mkupriyanov05/Diploma_Baka/RPZ_Kupriyanov_Diploma.docx

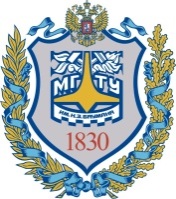
[picture p76: figure]
Gerb-BMSTU_01

| Министерство науки и высшего образования Российской Федерации Федеральное государственное бюджетное образовательное учреждение высшего образования «Московский государственный технический университет имени Н.Э. Баумана (национальный исследовательский университет)» (МГТУ им. Н.Э. Баумана)

ФАКУЛЬТЕТ «Информатика и системы управления» («ИУ»)

КАФЕДРА «Проектирование и технология производства электронной аппаратуры» («ИУ-4»)

РАСЧЕТНО-ПОЯСНИТЕЛЬНАЯ ЗАПИСКА

К ВЫПУСКНОЙ КВАЛИФИКАЦИОННОЙ РАБОТЕ

НА ТЕМУ:

«Гитарный эффект «Бит Крашер»

Студент группы ИУ4-83Б М.М. Куприянов

(Подпись, дата)

Руководитель ВКР В.В. Макарчук

(Подпись, дата)

Нормоконтролер

(Подпись, дата)

2026 г.

АННОТАЦИЯ

Представленная работа посвящена разработке электронного изделия, реализующего гитарный эффект «Бит Крашер». Такое изделие необходимо для изменения частотного спектра аналогового сигнала, что позволяет менять звучание гитарного инструмента. Его предполагается использовать при исполнении мелодий и музыкальных композиций на электрогитаре. Прошедший через спроектированное изделие звуковой сигнал приобретает характерные черты «роботизированности» и «зернистости».

Расчетно-пояснительная записка (РПЗ) включает в себя комплект документации, необходимой для разработки и производства изделия, состоящий из схем электрических структурной, функциональной и принципиальной, чертежей печатной платы, схемы сборки модуля электроники, деталей корпуса и самого изделия после сборки. Дополнительно в приложении к РПЗ представлены спецификация на изделие и перечень содержащихся в нем электронных компонентов. Приведены соображения по выбору характеристик спроектированного изделия и его электронной компонентной базы.

Ключевые слова: гитарный эффект, «Бит Крашер», аналого-цифровой преобразователь, цифро-аналоговый преобразователь, схема выборки-хранения, схемотехническое проектирование, конструкторское проектирование, технологическое проектирование.

ABSTRACT

This work is dedicated to the development of an electronic device implementing the guitar effect "Bit Crusher." Such a device is necessary for modifying the frequency spectrum of an analog signal, which allows changing the sound of a guitar instrument. It is intended to be used when performing melodies and musical compositions on an electric guitar. The audio signal passing through the designed device acquires characteristic features of "robotic" and "grainy" sound.

The Design and Explanatory Report (DER) includes a set of documentation necessary for the development and production of the device, consisting of electrical circuit diagrams: structural, functional, and schematic; printed circuit board drawings; an electronics module assembly diagram; enclosure parts; and the final assembled device. Additionally, the DER appendix contains the device specification and a list of electronic components included in it. Considerations regarding the selection of characteristics for the designed device and its electronic component base are also provided.

Keywords: guitar effect, "Bit Crusher," analog-to-digital converter, digital-to-analog converter, sample-and-hold circuit, circuit design, engineering design, technological design.

СОДЕРЖАНИЕ

С.

# УСЛОВНЫЕ ОБОЗНАЧЕНИЯ, СОКРАЩЕНИЯ И ТЕРМИНЫ

АЦП - Аналого-Цифровой Преобразователь;

ГОСТ – Государственный Стандарт;

ГЭ Гитарный эффект

ДПП – Двухсторонняя Печатная Плата;

ЕСКД – Единая Система Конструкторской Документации;

ИМС - Интегральная Микросхема;

КМО - Компоненты, Монтируемые в Отверстия;

КМП - Компоненты, Монтируемые на Поверхность;

ОУ - Операционный Усилитель;

ПП - Печатная Плата;

РПЗ – Расчётно-пояснительная записка;

РТЗ – Расширенное техническое задание;

САПР - Система Автоматизированного Проектирования;

СВХ - Схема Выборки-Хранения;

ТЗ - Техническое Задание;

ТРИЗ - Теория Решения Изобретательских Задач;

ЦАП - Цифро-Аналоговый Преобразователь;

ЭА - Электронная Аппаратура;

ЭРЭ - Электрорадиоэлемент;

ЭС - Электронное Средство;

ABS – ударопрочная техническая термопластическая смола на основе сополимера акрилонитрила с бутадиеном и стиролом;

FDM – Fused Deposition Modeling - аддитивная технология, широко используемая при создании трёхмерных моделей, при прототипировании и в промышленном производстве

SNR - Signal-to-Noise Ratio – отношение сигнал/шум

# ВВЕДЕНИЕ

Создание новых музыкальных инструментов было занятием людей задолго до появления современной цивилизации. Необычное звучание выделяло исполнителей среди равных. Множество талантов раскрылось с помощью уникальных звуковых профилей. Изобретая альтернативу классическим инструментам, музыканты проявляли и продолжают проявлять свою креативность, раз за разом расширяя диапазон звуковых волн, достигающих ушей слушателей.

С распространением электричества радиолюбители стали использовать доступные ЭРЭ для создания устройств, искажающих сигнал инструментов, в том числе и гитар. Такие устройства начали называть гитарными эффектами. Самыми популярными из ГЭ признаны «Дисторшн», «Фузз», «Вибрато» и др. Однако, создание первых цифровых программ для персональных компьютеров, осуществляющих функции обработки звуковых сигналов, поставило перед разработчиками программного обеспечения необходимость решения проблемы низкой разрядности. Малая разрядность искажала сигналы и «роботизированность», создаваемая несовершенными устройствами, стала узнаваемой и полюбилась слушателям. После лет усовершенствования электронной аппаратуры встала задача искусственно создать такие искажения звукового сигнала. Решить ее был призван ГЭ, названный «Бит Крашер». Особенность этого эффекта заключается в использовании двух основных принципов: понижение разрядности цифровой формы сигнала и уменьшение частоты его дискретизации.

Оба упомянутых принципа в современных устройствах реализуются при помощи цифровой обработки сигналов. Программное обеспечение или отдельный прибор обычно использует микроконтроллер или другой программируемый модуль для работы с сигналом как набором цифровых линий. Аналого-цифровое преобразование в современных устройствах осуществляется с целью удобства работы с сигналом.

Представляемая работа, в противовес существующим на рынке техническим решениям, с целью сохранения аутентичности звука и лучшего контроля над каждым этапом преобразования использует дискретные элементы и микросхемы. Преобразование звукового сигнала из аналоговой формы в цифровую для создания звукового эффекта совершается в нем не как конечная цель, а для создания возможности дальнейшей работы с сигналом. Весь процесс изменения сигнала осуществляется в данном случае в соответствии со строго обозначенной последовательностью. Дополнительно стоит отметить разделение этой последовательности на функциональные модули, речь о которых пойдет дальше, что дает возможность совершенствовать разработанное изделие согласно этим отдельным модулям, без необходимости замены всей архитектуры системы.

Актуальность работы обусловлена недостаточным количеством аналогов разработанного изделия на отечественном рынке. Выбирая устройства с указанной выше структурой, использующей дискретные ЭРЭ и ИМС, круг производителей сокращается еще больше. В результате анализа цена на указанную продукцию, представленную на зарубежном рынке, оказывается слишком высокой вследствие наличия дополнительных логистических и таможенных затрат.

Целью работы являлось создание макетного образца устройства «Гитарный эффект «Бит Крашер», а также конструкторско-технологической документации к нему, включающей в себя расчетную и графическую часть.

Сборка и тестирование образца будет служить основой для оценки предложенных технических решений, а также проверки корректности функционирования и достижения заявленных характеристик.

Для достижения поставленной цели был выполнен следующий комплекс работ:

- разработка структурной схемы Э1;
- разработка функциональной схемы Э2;
- разработка принципиальной схемы Э3;
- разработка конструкции печатной платы;
- разработка конструкции электронного модуля;
- разработка конструкции корпуса изделия;
- разработка конструкции всего изделия в целом;
- разработка технологического процесса сборки изделия;
- расчёты изделия на механические и тепловые воздействия;
- разработка технологического процесса изделия;
- сборка макетного образца изделия;
- разработка методики и испытательного стенда для контроля рабочих характеристик изделия.

Исходными данными для работы являлись:

- задание на выполнение квалификационной работы бакалавра;
- календарный план выполнения квалификационной работы бакалавра.

Результатами работы являются:

- электрическая структурная схема (Э1);
- электрическая функциональная схема (Э2);
- электрическая принципиальная схема (Э3);
- чертеж печатной платы;
- сборочный чертёж электронного модуля;
- чертеж основания корпуса изделия;
- чертеж крышки корпуса изделия;
- сборочный чертёж изделия;
- эскизный технологический процесс сборки изделия;
- расчёт программы выпуска изделия;
- отчёт по проведению контрольных испытаний изделия.

Структура и объем работы. Работа разделена на четыре раздела.

В первом разделе проведен анализ технико-экономического обоснования выполнения работы путем анализа его технического задания, а также выполнен сравнительный анализ функциональных параметров существующих аналогов.

Второй раздел содержит результаты конструкторско-схемотехнического проектирования разработанного изделия. В ней приведено описание процесса разработки структурной, функциональной и принципиальной электрических схем, конструкций печатной платы и корпуса и выполнены необходимые для этого схемотехнические и конструкторские расчеты.

В третьем разделе изложены результаты технологического проектирования создаваемого изделия. Изложены процесс разработки схем сборки изделия и результаты расчета и анализа его технологичности.

Заключительный четвертый раздел включает в себя результаты экспериментальных исследований созданного изделия, для чего были выполнены работы по созданию измерительного стенда, методик проведения измерений и анализа результатов проведенных экспериментов.

В заключении кратко подведены итоги проделанной работы.

# 1 ТЕХНИКО-ЭКОНОМИЧЕСКОЕ ОБОСНОВАНИЕ РАЗРАБОТКИ ИЗДЕЛИЯ «ГИТАРНЫЙ ЭФФЕКТ «БИТ КРАШЕР»

## 1.1 Обзор существующих аналогов изделия и обоснование экономической целесообразности разработки устройства

Основной задачей изделий типа «Бит Крашер» является изменение спектра звукового сигнала. Ожидаемую форму можно описать как ступенчатое изменение сигнала во времени, т.е. такие изделия должны обеспечить соответствующий спектральный диапазон.

Наиболее частые параметры, по которым описывается необходимый частотный спектр и определяются достоинства ГЭ «Бит Крашер» — это частота дискретизации сигнала, количество разрядов и полоса пропускания. Примем их в качестве фундаментальных характеристик именно для такого типа изделий. Также не стоит забывать и про универсальные для изделий электроники параметры: вес, габариты, потребляемый ток, количество функций и стоимость. Отдельно выделим как характеристику способ преобразования, что как было сказано ранее влияет на сохранение аутентичности звука и модульности архитектуры изделия. Проведем анализ представленных на рынке аналогов по этим характеристикам. Стоит отметить, что в данном разделе под аналогами подразумеваются самостоятельные изделия, а не устанавливаемое программное обеспечение, поскольку цель работы – создание образца изделия, а не программы.

Рассмотрим изделие, реализующее функции гитарного эффекта «Бит Крашер» от фирмы Sonicake (КНР) [1]. Его внешний вид представлен на рисунке 1.1.

Фото 1 - Sonicake QSS-20 Wave Crush Bitcrusher.

Рисунок 1.1 – Внешний вид изделия, реализующего функции гитарного эффекта «Бит Крашер» фирмы «Sonicake» (КНР)

Представленное изделие имеет следующие функциональные параметры:

- Вес: 125 г. Данный вес обеспечивает комфорт при переноске и использовании.
- Габаритные размеры: 92×38×36 мм. Указанные размеры делают изделие портативным.
- Потребляемый ток: 110 мА. Небольшой ток позволяет экономить электроэнергию.
- Количество функций: 3. Совмещение нескольких режимов работы увеличивает вариативность использования изделия, что положительно влияет на спрос на него.
- Стоимость: 6390 р. Указана рыночная цена на данное изделие.
- Частота дискретизации: 0,75 - 44 кГц. Большая вариативность выбора частоты дискретизации влияет на возможность изменения степени искажения звукового сигнала. Чем меньше частота дискретизации, тем более искаженным будет звук.
- Количество разрядов: от 5 до 16. Большая вариативность выбора количества разрядов влияет на возможность изменения степени искажения сигнала. Чем меньше количество разрядов, тем более искаженным будет звук.
- Полоса пропускания: 20 Гц - 20 кГц. Частоты, на которых работает изделие, соответствуют слышимому человеческим ухом звуковому диапазону.
- Cпособ преобразования: цифровой. Цифровое преобразование не требует большого количества ЭРЭ и ИМС, однако не предоставляет тех преимуществ, которые были перечислены при описании преобразовании дискретными элементами.

Эти характеристики позволяют оценить функциональность и особенности данной модели ГЭ.

Также рассмотрим гитарный эффект «Бит Крашер» от Electro-Harmonix (США) [2]. Его внешний вид представлен на рисунке 1.2.


Рисунок 1.2 - Внешний вид гитарного эффекта «Бит Крашер» от Electro-Harmonix (США)

Представленное изделие имеет следующие функциональные параметры:

- Вес: 350 г. Небольшой вес обеспечивает комфорт в переноске и использовании.
- Габариты: 115×70×55 мм. Малые габариты делают изделие портативным.
- Потребляемый ток: 100 мА. Небольшой ток позволяет экономить электроэнергию.
- Количество функций: 5. Совмещение нескольких режимов работы увеличивает вариативность использования изделия, что положительно влияет на спрос на него.
- Стоимость: 23000 р. Указана рыночная цена на данное изделие.
- Частота дискретизации: 0,11 – 48 кГц. Большая вариативность выбора частоты дискретизации влияет на возможность изменения степени искажения сигнала. Чем меньше частота дискретизации, тем более искаженным будет звук.
- Количество разрядов: от 1 до 24. Большая вариативность выбора количества разрядов влияет на возможность изменения степени искажения сигнала. Чем меньше количество разрядов, тем более искаженным будет звук.
- Полоса пропускания: 20 Гц - 20 кГц. Частоты, на которых работает изделие, соответствуют слышимому человеческим ухом звуковому диапазону.
- Cпособ преобразования: цифровой. Цифровое преобразование не требует большого количества ЭРЭ и ИМС, однако не предоставляет тех преимуществ, которые были перечислены при описании преобразовании дискретными элементами.

Эти характеристики позволяют оценить функциональность и особенности данной модели ГЭ.

По итогам анализа характеристик аналогов можно сделать следующие выводы.

Рассмотренные аналоги выделяются своей вариативностью. В качестве достоинств этих изделий можно выделить возможность изменения частоты дискретизации и количества разрядов. Эти параметры значительно увеличивают варианты использования изделия. Также достоинствами являются количество функций и малые габариты. Совмещение этих двух параметров позволяет потенциальному покупателю получить большую функциональность в корпусе меньших размеров.

Недостатками изделия назовем цифровое преобразование сигнала, сопровождающееся спектральными потерями в уникальном звуке инструмента, подключенного ко входу, и его высокую стоимость, которая сделает его менее доступным для покупателей.

Стоит заметить, что представленные модели произведены зарубежом, что делает потенциального пользователя зависимым от импорта товаров. На отечественном рынке сопоставимых по функционалу аналогов практически нет.

Обзор аналогов помогает определить возможные сильные и слабые стороны разрабатываемого изделия. Такое рассмотрение выделяет основные различия между существующими решениями и разрабатываемым изделием, чтобы иметь понимание какие характеристики можно превратить в преимущества готового продукта.

## 1.2 Анализ задания на проектирование

Проведенный анализ расширенного технического задания позволяет выделить требования и характеристики к изделию:

- Cпособ преобразования: на дискретных ЭРЭ и ИМС. Такая архитектура сохраняет аутентичное звучание гитарного инструмента, а также дает возможность легкой замены модулей преобразователя.
- Габаритные размеры: до 150 × 100 × 50 мм. Выбранный способ преобразования обеспечивает умеренные размеры изделия. Важно заметить, что использование большего количества ЭРЭ и ИМС увеличивает габаритные размеры.
- Вес: до 500 г. Габаритные размеры ставят ограничения на снижение итогового веса изделия, однако такое его значение можно признать умеренным.
- Потребляемый ток: до 200 мА. Обеспечение небольшого тока необходимо для малого расхода электроэнергии, а следовательно, и денежных и инфраструктурных затрат на функционирование прибора.
- Количество функций: 1. Создание изделия с меньшим количеством функций и режимов работы удешевляет его и уменьшает его сложность.
- Стоимость: 2000 р. Указана примерная цена на данное изделие, что в сравнении с аналогами делает его более доступным.
- Частота дискретизации: 100 кГц. Уменьшение частоты дискретизации позволяет менять характеристики звука и часто используется в ГЭ «Бит Крашер», однако в данной работе такая задача не ставится. Большая частота дискретизации избавляет изделие от нежелательного явления алиасинга (наложения спектров при слишком малой частоте дискретизации), обеспечивая передискретизацию.
- Количество разрядов: 4. Этот параметр напрямую влияет на степень искажения. В данной работе для упрощения конструкции обеспечивается малая количество разрядов, что вносит значительные искажения в сигнал. При анализе необходимой величины этого параметра было найдено техническое противоречие. Увеличение числа выполняемых разрядов геометрически увеличивает количество необходимых элементов, а следовательно, и габариты изделия. Решение данного противоречия представлено в главе, посвященной схемотехнической разработке изделия.
- Полоса пропускания: 4 Гц – 40 кГц. Частоты, на которых работает изделие, соответствуют слышимому человеческим ухом звуковому диапазону.
- Питание: +9В. Такое стандартное значение питания предполагается обеспечивать распространенной батареи типа «Крона». Большинство ИМС, которые могут использоваться в данной работе, работают от напряжения питания +5В, однако для обеспечения точного преобразования необходимо стабилизировать это питание. Для этого используется источник питания с типовым значением, большим чем +5В.

Учитывая приведенные характеристики, проектируемое изделие можно описать как недорогой, малопотребляющий гитарный эффект, обладающий небольшими размерами и весом, выполняющий серьезные спектральные преобразования для получения ступенчатой формы временной диаграммы звукового сигнала.

## Выводы

Был проведен сравнительный обзор характеристик продуктов-аналогов «Гитарный эффект «Бит Крашер», представленных на рынке. Главными недостатками были признаны однообразие способа преобразования и его несовпадение с требуемым и высокая стоимость изделия. Первый недостаток влияет на желание потребителя сохранять уникальный звук музыкального инструмента при использовании прибора, а также он не обеспечивает достаточной вариативности в замене модулей без изменения всей архитектуры. Второй недостаток сокращает количество потенциальных покупателей, так как высокая цена на изделие значительно уменьшает его доступность.

По итогам анализа технического задания были выявлены требуемые параметры изготавливаемого изделия. В качестве ключевой характеристики было обозначено количество разрядов. Она отвечает за степень искажения сигнала и должна быть обеспечена прежде всего. Также стоит отметить намеренное использование самостоятельных ЭРЭ и ИМС для построения архитектуры преобразования. Этот параметр сильно отличает разрабатываемое изделие от аналогов.

Данная глава помогает определить функционал и направление развития изделия. Выявлены ключевые недостатки аналогов, которые будут использоваться как сильные качества гитарного эффекта «Бит Крашер».

# 1 КОНСТРУКТОРСКО-СХЕМОТЕХНИЧЕСКИЙ РАЗДЕЛ РАЗРАБОТКИ ИЗДЕЛИЯ «ГИТАРНЫЙ ЭФФЕКТ «БИТ КРАШЕР»

## 1.1 Выбор архитектуры изделия

Основная задача изделия – дискретизировать сигнал по определенному числу уровней напряжения. При условии, что на вход подается звукового сигнала от гитары, его форма – синусоида. Она должна быть преобразована в волну такой же частоты, сэмплированную по нескольким уровням. В результате временная диаграмма выглядит как возрастающие и убывающие по закону синусоиды ступеньки.

Самый распространенный вид такого преобразования – последовательное аналого-цифровое, а затем и цифро-аналоговое. Таким образом цифровая форма, несомненно, внесет шумы квантования, за счет чего сигнал и приобретет необходимую форму. Величина этих шумов зависит от количества разрядов АЦП. Чем меньше разрядов, тем больше величина шумов квантования (отклонения значения преобразованного сигнала от входного).

Среди возможных схемотехнических исполнений АЦП было принято решение в пользу АЦП параллельного типа. Он сочетает быстродействие с простотой и отсутствием необходимости использовать множество элементов. Хоть быстродействие и не столь критично для данного устройства, ведь частота дискретизации равна 100 кГц, компактная реализация – безусловный плюс, позволяющий сохранить малые габариты устройства.

С учетом рассмотренных выше соображений была выбрана структура ЦАП для разрабатываемого изделия. В работе была использована R-2R лестница резистивных элементов. Простота исполнения в данном случае дополняется возможностью контроля потребления токов за счет изменения величины сопротивления.

Отдельным вопросом стоит выделить выбор разрядности АЦП. Поскольку в параллельном типе преобразователя количество активных элементов, а именно, компараторов, увеличивается геометрически (N бит параллельного АЦП требуют 2N компараторов), то стоит стремиться к малому их количеству, так как обратное приведет к слишком большим габаритным размерам. Однако при уменьшении разрядности звук становиться все менее разборчивым и искаженным до неузнаваемости, иными словами, уменьшиться критическая величина SNR у схемы. Отсюда можно выделить противоречие: устройство требует одновременно большую и меньшую разрядность АЦП. Это противоречие проиллюстрировано на рисунке 2.1.


Рисунок 2.1 – Предметное противоречие схемы АЦП изделия

Разрешить данное противоречие можно, прибегнув к методам ТРИЗ Г.С. Альтшуллера. Эта теория предоставляет конечный список принципов, используя которые решаются любые противоречия [3]. В данном случае воспользуемся принципами Предварительного действия и Обращения вреда в пользу.

Следуя первому, уменьшим размеры корпусов других блоков и элементов схемы. Это позволит не отказываться от увеличения количества компараторов, а следовательно, и размеров всей схемы, сохраняя их высокие свойства преобразования сигнала. Как уже было упомянуто, будет использоваться компактное решение для ЦАП. Помимо этого, необходимый для устройства блок СВХ тоже будет реализован в малогабаритном исполнении – на единственном конденсаторе.

Принцип Обращения вреда в пользу используем так: примем, что низкое качество сигнала – это «плюс» данного устройства. Такие искажения придадут сигналу неповторимые спектральные параметры, они станут конкурентным преимуществом эффекта перед аналогами. Таким образом, компактность будет удовлетворена, а SNR будет считаться приемлемым.

Придем к компромиссу: в качестве АЦП будет использоваться преобразователь параллельного типа для 4 разрядов. 2⁴ = 16 уровней напряжения позволят сигналу остаться достаточно разборчивым, придадут необходимые спектральные изменения и сохранят габариты устройства малыми.

## 1.2 Проектирование схемы электрической структурной

Структурная схема устройства была разработана согласно ГОСТ 2.701-84 [4]. В качестве среды разработки была выбрана САПР КОМПАС-3D v23 [5]. Структурная схема изделия представлена на рисунке 2.2.

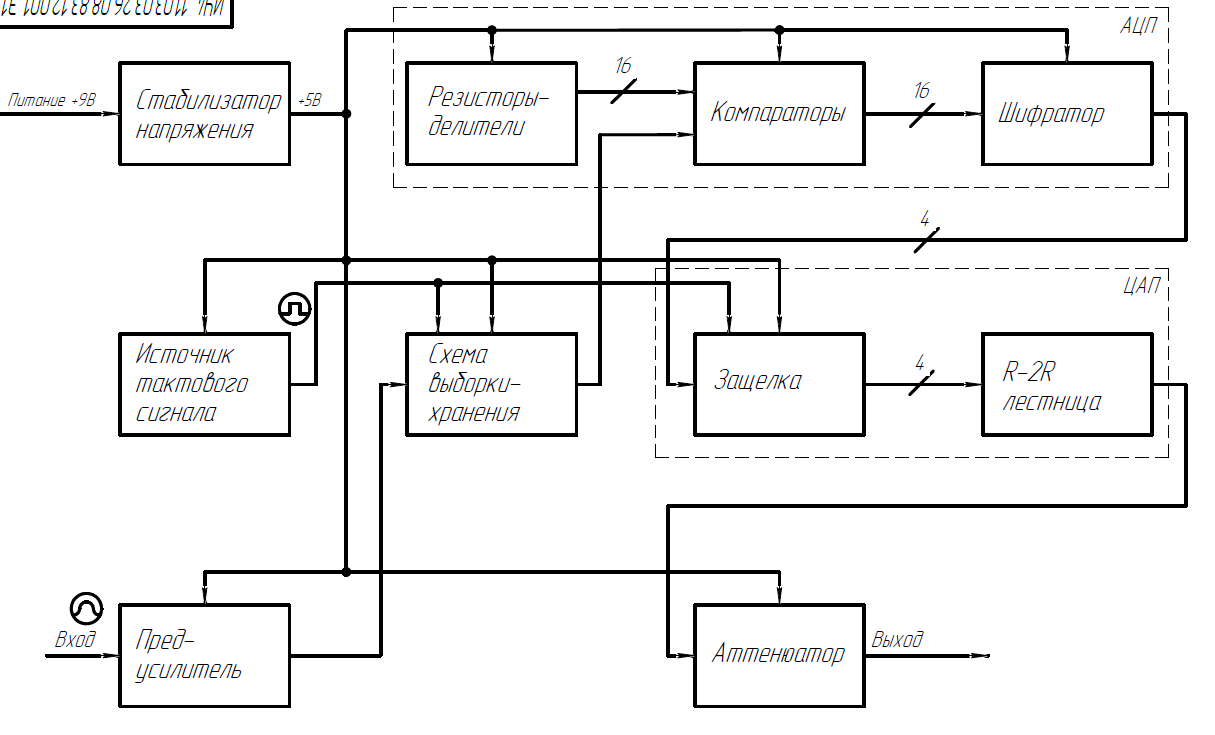
[picture p77: figure]

Рисунок 2.2 – Схема электрическая структурная изделия

Все устройство можно условно разделить на 10 функциональных блоков:

- блок «Стабилизатор напряжения» - микросхема с обвязывающей её по рекомендации производителя элементной базой, служит для понижения и стабилизации напряжения, приходящего со входа питания до уровня, необходимого для питания ИМС;
- блок «Источник тактового сигнала» - кварцевый резонатор, включенный в схему Пирса, необходимый для дискретизации и синхронизации сигнала;
- блок «Резисторы-делители» - 15 точных резисторов одного номинала для создания опорных напряжений для компараторов;
- блок «Компараторы» - 16 компараторов для создания термометрического кода сигнала;
- блок «Шифратор» - преобразует термометрический код в двоичный;
- блок «Предусилитель» - аналоговый усилитель звуковой частоты на операционном усилителе. Выполняет предварительное усиление слабого сигнала с гитары до уровня, необходимого для корректной работы АЦП, имеет возможность подстройки;
- блок «Схема выборки-хранения» - схема, состоящая из аналогового ключа и конденсатора для выборки определенного уровня сигнала и дальнейшей его обработки;
- блок «Защелка» - синхронизирует сигналы с шифратора с помощью тактового сигнала для его дальнейшего корректного преобразования;
- блок «R-2R лестница» - схема на резисторах для преобразования цифрового сигнала в аналоговый;
- блок «Аттенюатор» - аналоговый усилитель звуковой частоты на операционном усилителе. Выполняет ослабление сигнала после преобразований до прежнего уровня гитары, имеет возможность подстройки.

Блоки «Резисторы-делители», «Компараторы» и «Шифратор» были объединены в общий блок «АЦП» для лучшего понимания работы устройства. Аналогично «Защелка» и «R-2R лестница» были объединены в «ЦАП».

## 1.3 Проектирование схемы электрической функциональной

На основе схемы электрической структурной, была разработана схема электрическая функциональная. Схема разработана по ГОСТ 2.702-2011 [6], и представлена на рисунке 2.3.

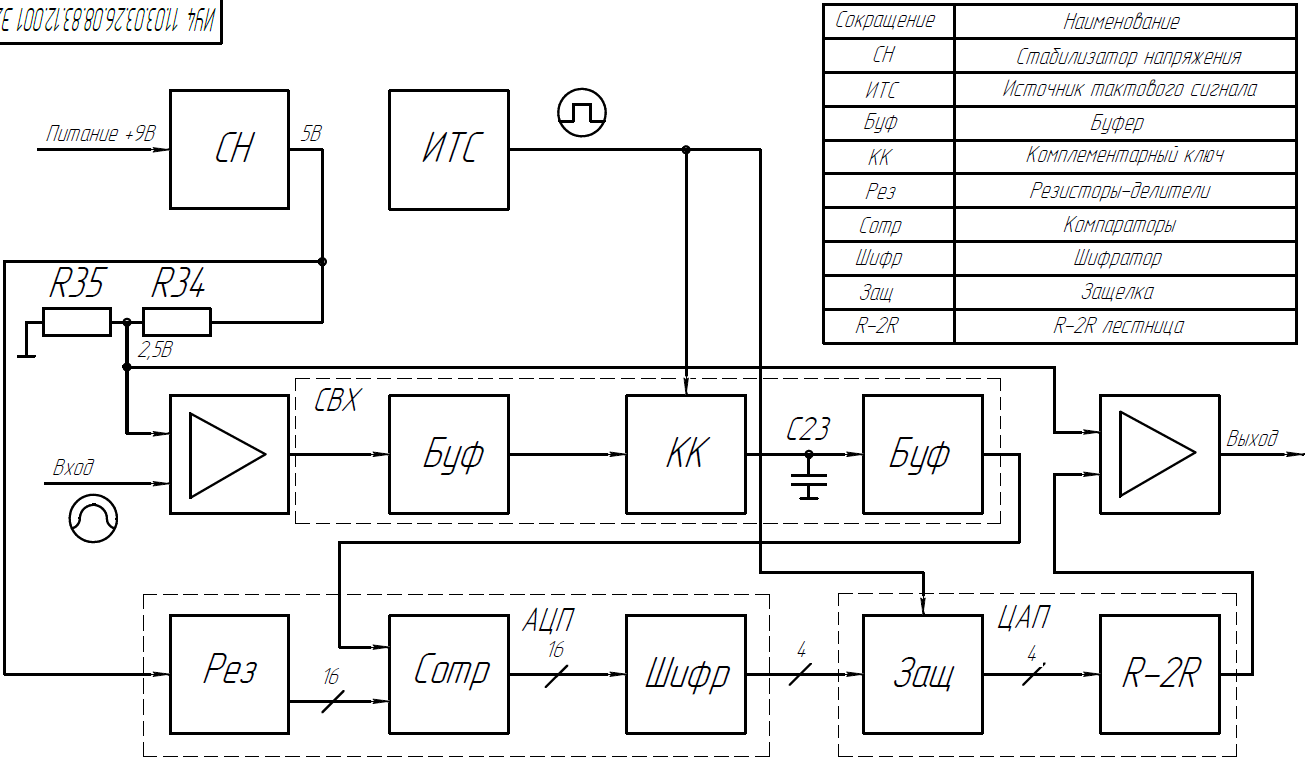
[picture p78: figure]

Рисунок 2.3 - Схема электрическая функциональная изделия

Функциональная схема уточняет структурную. Некоторые блоки разбиты на более подробные. Реализация других блоков представлена с помощью составляющих их элементов. Так, уточнены составляющие элементы схемы выборки-хранения: 2 буфера, комплементарный ключ и конденсатор C23. Также показано образование опорного уровня напряжения питания равного половине питания на резисторах R34 и R35 для корректной работы операционных усилителей.

## 1.4 Проектирование схемы электрической принципиальной

На основе схемы электрической функциональной, была разработана схема электрическая принципиальная. Схема разработана по ГОСТ 2.702-2011 [6], и представлена на рисунке 2.4.

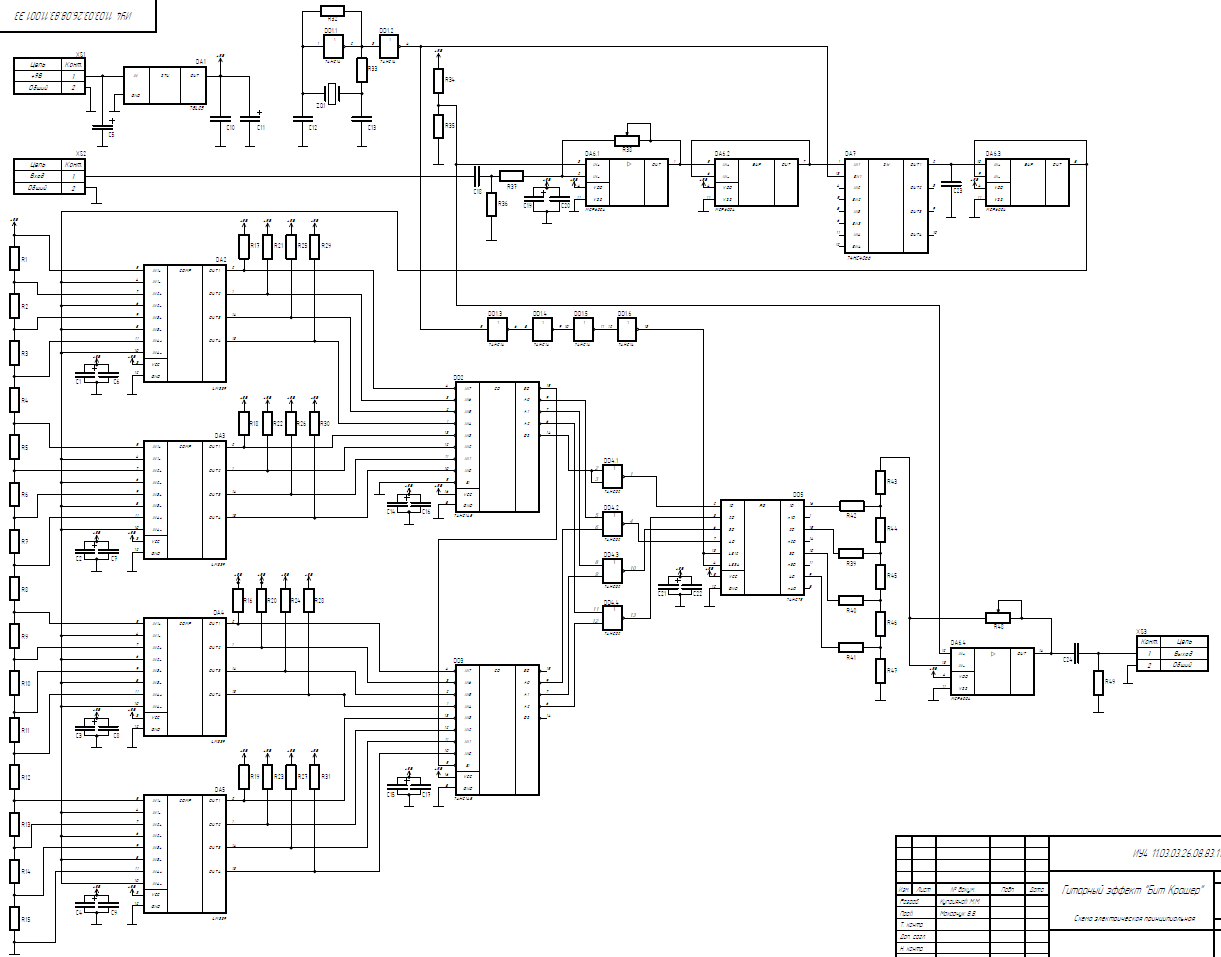
[picture p79: figure]

Рисунок 2.4 - Схема электрическая принципиальная изделия

Стабилизатор напряжения состоит из микросхемы DA1 и помехоподавляющих конденсаторов С5, C10 и С11. Он преобразует входное напряжение 9В в стабильное напряжение 5В, критически необходимое для работы других элементов схемы.

Источник тактового сигнала создает меандр частотой 100 кГц на кварцевом резонаторе ZQ1, резисторах R32, R33, конденсаторах C12, C13, и микросхеме DD1 (инвертор Шмитта).

Предусилитель, включающий микросхему DA6 (операционный усилитель), резисторы R36 - R38 (R38 – потенциометр для изменения амплитуды), конденсаторы C18 – C20 (C18 – разделительный, C19-C20 – помехоподавляющие), увеличивает амплитуду входящего сигнала с целью возможности его корректной обработки следующими блоками.

Схема выборки-хранения (СВХ) – блок, необходимый для временной фиксации значения сигнала в определенном значении. Он использует буферы на микросхемах DA6 (ОУ), DA7 (комплементарный ключ) и конденсаторе C23.

Блок АЦП объединяет в себе ряд резисторов-делителей (R1-R15) для установки 16 пороговых напряжений, ряд компараторов (DA2-DA5) для сравнения полученных пороговых напряжений с сигналом из устройства выборки-хранения и схему приоритетного шифратора 16 в 4 (DD2-DD4) для преобразования термометрического кода в бинарный. Сопутствующие резисторы и конденсаторы нужны для корректной работы микросхем.

Блок ЦАП с помощью защелки (DD5) и R-2R лестницы (R39-R47) преобразует бинарный код обратно в аналоговый сигнал.

Аттенюатор, выполненный на микросхеме DA6 (ОУ) с помощью резистора R48 (потенциометра, аналогичного R38), возвращает прошедшему обработку звуку первоначальную амплитуду.

## 1.5 Выбор и анализ элементной базы устройства

Основные характеристики компонентов приведены в таблице 2.1. Типы используемых элементов и их технические условия указаны в перечне элементов в Приложении А. Таблица составлена на основе технической документации на элементы, а также на основе ГОСТ 28213-89 [7].

Таблица 2.1 – Анализ сборочного состава

Обозначение | Элемент | Описание/Номинал | Параметры внешних воздействий
| | | Температурный диапазон, °С | Влажность | Вибрации, Гц | Перегрузка, g | Ударные перегрузки
С1-C4, C11, C14-C15, C19, C21 | Электролитический конденсатор | 1 мкФ ±20% 16В | -60…+125 | 80% при +25°С | 5…600 | 40 | до 20g за 10мс
C5 | Электролитический конденсатор | 10 мкФ ±20% 50В | -60…+125 | 80% при +25°С | 5…600 | 40 | до 20g за 10мс
C12-C13 | Керамический конденсатор | 20 пФ ±20% 50В 0805 | -60…+125 | 80% при +25°С | 5…600 | 40 | до 20g за 10мс
C23 | Керамический конденсатор | 4,7 нФ ±20% 16В 0805 | -60…+125 | 80% при +25°С | 5…600 | 40 | до 20g за 10мс
C6-C10, C16-C17, C20, C22 | Керамический конденсатор | 100 нФ ±20% 16В 0805 | -60…+125 | 80% при +25°С | 5…600 | 40 | до 20g за 10мс
C18, С24 | Керамический конденсатор | 1 мкФ ±20% 16В 0805 | -60…+125 | 80% при +25°С | 5…600 | 40 | до 20g за 10мс
DA1 | Стабилизатор напряжения | 78L05 | -40…+125 | 98% при +40°С | 5…600 | 40 | до 20g за 10мс
DA2-DA5 | Компаратор счетверенный | LM339D | -40…+85 | 95% при +40°С | 5…600 | 40 | до 10g за 10мс
DA6 | Операционный усилитель счетверенный | MCP6004 | -40…+85 | 95% при +40°С | 5…600 | 40 | до 10g за 10мс
DA7 | Переключатель двунаправленный счетверенный | 74HC4066 | -40…+85 | 95% при +40°С | 5…600 | 40 | до 10g за 10мс
DD1 | Инвертер сшестеренный | 74HC14 | -40…+85 | 95% при +40°С | 5…600 | 40 | до 10g за 10мс
DD2-DD3 | Приоритетный шифратор 8х3 | SN74HC148 | -40…+85 | 95% при +40°С | 5…600 | 40 | до 10g за 10мс
DD4 | 2И-НЕ счетверенный | 74HC02D | -40…+85 | 95% при +40°С | 5…600 | 40 | до 10g за 10мс
DD5 | Защелка бистабильная счетверенная | 74HC75D | -40…+85 | 95% при +40°С | 5…600 | 40 | до 10g за 10мс
R1-R15 | Резистор | 316 Ом ±0.5% 0.125Вт 0805 | -60…+150 | 98% при +35°С | 5…600 | 60 | до 20g за 10мс
R33 | Резистор | 1 кОм ±5% 0.125Вт 0805 | -60…+150 | 98% при +35°С | 5…600 | 60 | до 20g за 10мс
R16-R31, R37 | Резистор | 5,1 кОм ±5% 0.125Вт 0805 | -60…+150 | 98% при +35°С | 5…600 | 60 | до 20g за 10мс
R34-R35, R43-R46 | Резистор | 10 кОм ±0.1% 0.125Вт 0805 | -60…+150 | 98% при +35°С | 5…600 | 60 | до 20g за 10мс
R38, R48 | Потенциометр | 10,0 кОм ±10% 1 Вт | -60…+150 | 98% при +35°С | 5…600 | 60 | до 20g за 10мс
R39-R42, R47 | Резистор | 20 кОм ±0.1% 0.125Вт 0805 | -60…+150 | 98% при +35°С | 5…600 | 60 | до 20g за 10мс
R32, R36, R49 | Резистор | 1 МОм ±5% 0.125Вт 0805 | -60…+150 | 98% при +35°С | 5…600 | 60 | до 20g за 10мс
ZQ1 | Кварцевый резонатор | 100 кГц, DMX-26S, SMD08038P4 | -20…+60 | 98% при +35°С | 5…600 | 60 | до 20g за 10мс
XS1 | Разъем штыревой | WR-TBL 691313510002 | -20…+85 | 98% при +40°С | 5…600 | 40 | до 10g за 10мс
XS2-XS3 | Разъем «Джек» 6,3 мм | NYS-2152 | -20…+85 | 98% при +40°С | 5…600 | 40 | до 10g за 10мс

С учетом анализа элементной базы сформулированы нормальные условия для работы изделия:

- диапазон температур: -0…+40°С;
- перегрузки до 20g;

Из анализа элементной базы можно сделать вывод, что данный состав компонентов устройства обеспечивает его функционирование и работоспособность в условиях, соответствующих техническому заданию.

## 1.6 Расчет коэффициентов электрической нагрузки

Воспользовавшись справочными данными и результатами моделирования, схемы, найдем коэффициенты нагрузки ЭРЭ.

Для конденсаторов:

k_н =U/(U_(доп))

где U – напряжение на обкладках

Uдоп – максимально допустимое напряжение на обкладках.

Конденсатор C5

Напряжение на обкладках конденсатора C1 равно напряжению питания схемы и составляет 9В±10%. Максимально допустимое напряжение на обкладках данных конденсаторов, согласно их техническим данным, составляет 50В. Таким образом, коэффициент нагрузки для них равен:

k_н =9/50=0,18

Конденсаторы С1-C4, C6-C11, C14-C17, C19-C22

Напряжение на обкладках этих конденсаторов определяется напряжением стабилизированного напряжения, что составляет 5В. Максимально допустимое напряжение на обкладках конденсаторов, согласно его техническим данным, составляет 16В. Таким образом, коэффициент нагрузки для него равен:

k_н =5/16=0,313

Конденсаторы C12, С13

Напряжение на обкладках конденсаторов С12, С13 примерно равно значениям цифровой схемы DD1 (0 и 5В). Выберем максимальное – 5В. Максимально допустимое напряжение на обкладках конденсаторов, согласно их техническим данным, составляет 50В. Таким образом, коэффициент нагрузки для него равен:

k_н =5/50=0,1

Конденсаторы C18, C24

Напряжение на обкладках конденсаторов C18, C24 примерно равно уровню опорного напряжения делителя плюс максимальному напряжению выходного сигнала и составляет 3,5В. Максимально допустимое напряжение на обкладках конденсаторов, согласно их техническим данным, составляет 16В. Таким образом, коэффициент нагрузки для них равен:

k_н =(3,5)/16=0,219

Для резисторов:

k_н =P/(P_(доп))

где P – рассеиваемая мощность на резисторе;

Pдоп – максимально допустимая рассеиваемая мощность.

Резисторы R1-R15

При сопротивлении резистора R = 316 Ом и протекающем токе 1 мА рассеиваемая мощность резистора составляет P=I^2 R= 0,000316 Вт . Из конструкторско-технологических соображений выбраны резисторы с рассеиваемой мощностью P=0,125 Вт . Таким образом, коэффициент нагрузки резистора составляет:

k_н =(0,000316)/(0,125)=0,002528

Резисторы R16-R31

При сопротивлении резисторов R = 5,1 кОм и максимальном падении напряжения 5В рассеиваемая мощность резистора составляет P=(U^2)/R=0,0049 Вт . Из конструкторско-технологических соображений выбраны резисторы с рассеиваемой мощностью P=0,125 Вт . Таким образом, коэффициент нагрузки резистора составляет:

k_н =(0,0049)/(0,125)=0,0392

Резистор R32, R36, R49

При сопротивлении резисторов R = 1 MОм и максимальном падении напряжения 5В рассеиваемая мощность резистора составляет P=(U^2)/R=0,000025 Вт . Из конструкторско-технологических соображений выбраны резисторы с рассеиваемой мощностью P=0,125 Вт . Таким образом, коэффициент нагрузки резистора составляет:

k_н =(0,000025)/(0,125)=0,0002

Резистор R33

При сопротивлении резисторов R = 1 кОм и максимальном падении напряжения 5В рассеиваемая мощность резистора составляет P=(U^2)/R=0,025 Вт . Из конструкторско-технологических соображений выбраны резисторы с рассеиваемой мощностью P=0,125 Вт . Таким образом, коэффициент нагрузки резистора составляет:

k_н =(0,025)/(0,125)=0,2

Резисторы R34, R35

При сопротивлении резисторов R = 10 кОм и максимальном падении напряжения 2,5В рассеиваемая мощность резистора составляет P=(U^2)/R=0,00025 Вт . Из конструкторско-технологических соображений выбраны резисторы с рассеиваемой мощностью P=0,125 Вт . Таким образом, коэффициент нагрузки резистора составляет:

k_н =(0,00025)/(0,125)=0,002

Резистор R37

При сопротивлении резистора R = 5.1 кОм и максимальном падении напряжения 2В рассеиваемая мощность резистора составляет P=(U^2)/R= 0,00078 Вт . Из конструкторско-технологических соображений выбраны резисторы с рассеиваемой мощностью P=0,125 Вт . Таким образом, коэффициент нагрузки резистора составляет:

k_н =(0,00078)/(0,125)=0,00627

Резисторы R38, R48

При сопротивлении резистора R = 10 кОм и максимальном падении напряжения 2В рассеиваемая мощность резистора составляет P=(U^2)/R= 0,0004Вт . Из конструкторско-технологических соображений выбраны резисторы с рассеиваемой мощностью P=0,125 Вт . Таким образом, коэффициент нагрузки резистора составляет:

k_н =(0,0004)/(0,125)=0,0032

Резистор R39-R42

При сопротивлении резистора R = 20 кОм и протекающем токе 20 мкА рассеиваемая мощность резистора составляет P=I^2 R= 0,000008 Вт . Из конструкторско-технологических соображений выбраны резисторы с рассеиваемой мощностью P=0,125 Вт . Таким образом, коэффициент нагрузки резистора составляет:

k_н =(0,000008)/(0,125)=0,000064

Резисторы R43-R46

При сопротивлении резистора R = 10 кОм и протекающем токе 20 мкА рассеиваемая мощность резистора составляет P=I^2 R= 0,000004 Вт . Из конструкторско-технологических соображений выбраны резисторы с рассеиваемой мощностью P=0,125 Вт . Таким образом, коэффициент нагрузки резистора составляет:

k_н =(0,000004)/(0,125)=0,000032

Резистор R47

При сопротивлении резисторов R = 20 кОм и максимальном протекающем токе I = 80 мкА рассеиваемая мощность резистора составляет P=I^2 R=0,000128 Вт . Из конструкторско-технологических соображений выбраны резисторы с рассеиваемой мощностью P=0,125 Вт . Таким образом, коэффициент нагрузки резистора составляет:

k_н =(0,000128)/(0,125)=0,001024

Для стабилизатора напряжения DA1:

Падение напряжения на стабилизаторе составляет 9 – 5 = 4, следовательно мощность для стабилизатора при токе 45 мкА: P=IU=0,00018 Вт .

Для компараторов DA2-DA5:

Поскольку напряжение питания составляет 5 В, а ток потребления может достигать 0,8 мА, следовательно мощность составляет: P=IU=0,004 Вт .

Для операционного усилителя DA6:

Поскольку напряжение питания составляет 5 В, а ток потребления может достигать 0,1 мА, следовательно мощность составляет: P=IU=0,0005 Вт .

Для переключателя двунаправленного DA7:

Поскольку протекающий ток составляет примерно 1 мА, а сопротивление ключа составляет 50 Ом, следовательно мощность составляет: P=I^2 R=0,00005 Вт .

Для инверторов DD1:

Поскольку напряжение питания составляет 5 В, а ток потребления может достигать 10 мкА, следовательно мощность составляет: P=IU=0,00005 Вт .

Для шифраторов DD2-DD3:

Поскольку напряжение питания составляет 5 В, а ток потребления может достигать 90 мкА, следовательно мощность составляет: P=IU=0,00045 Вт .

Для «2И-НЕ» DD4:

Поскольку напряжение питания составляет 5 В, а ток потребления может достигать 20 мкА, следовательно мощность составляет: P=IU=0,0001 Вт .

Для защелки DD5:

Поскольку напряжение питания составляет 5В, а ток потребления может достигать 10 мкА, следовательно мощность составляет: P=IU=0,00005 Вт .

Рассчитаем мощность, потребляемую изделием:

P_c = ΔU→0 = 0

P_(DA1) =IU≈0,00018 Вт

P_(DA2-5) =IU≈0,016 Вт

P_(DA6) =IU≈0,0005 Вт

P_(DA7) =I^2 R≈0,00005 Вт

P_(DD1) =I^2 R≈0,00005 Вт

P_(DD2-3) =IU≈0,0009 Вт

P_(DD4) =IU≈0,0001 Вт

P_(DD5) =IU≈0,00005 Вт

P_(R1-15) =I^2 R≈0,00474 Вт

P_(R16-31) =(U^2)/R≈0,0784 Вт

P_(R32,36, 49) =(U^2)/R≈0,000075 Вт

P_(R33) =(U^2)/R≈0,025 Вт

P_(R34,35) =(U^2)/R≈ 0,00125 Вт

P_(R37) =(U^2)/R≈0,00078 Вт

P_(R38,48) =(U^2)/R≈0,0008 Вт

P_(R39-42) =I^2 R≈0,000032 Вт

P_(R43-46) =I^2 R≈0,000016 Вт

P_(R47) =I^2 R≈0,000128 Вт

P _(XS1-4) = ΔU→0 = 0

Суммарная мощность P=0,129 Вт . Тогда ток источника питания должен быть равен:

I = P/U = (0,129)/9≈14,3 мА

Максимальную рассеиваемую мощность примем равной 0,2 от суммарной мощности, т.е. примерно 0,0258 Вт . Устройство должно обеспечить тепловой режим, гарантирующий отвод тепла и не допускающий превышение указанного температурного диапазона. При проектировании важно учесть ограничение по мощности и оставить необходимое пространство для более оптимальной циркуляции воздуха.

## 1.7 Расчет параметров печатного монтажа изделия

Плата изготавливается комбинированным позитивным методом. Выбранный материал изготовления платы – стеклотекстолит фольгированный СФ-2-18Г. Толщина диэлектрика – 1,5 мм. Толщина фольгированного слоя – 18 мкм. Класс точности изготовления – 3. Количество слоёв – 2. Выбор параметров материала ПП обусловлен размерами электронных компонентов и токами, протекающими по проводникам. Минимальная ширина печатных проводников, минимальное расстояние между печатными проводниками и минимальный гарантийный поясок указаны в ГОСТ Р 53429-2009 [8] для 3 класса точности.

Конструктивно-технологический расчет печатных плат производится с учётом производственных погрешностей рисунка проводящих элементов, фотошаблона, базирования, сверления и т.п.

Минимальная ширина проводников:

Минимальная ширина печатных проводников для ПП, изготовленных комбинированным методом вычисляется по формуле:

t=t_(D_(min)) +|Δt_(н.о.) | ,

где t_(D_(min)) – минимально допустимая ширина проводника, рассчитываемая в зависимости от допустимой токовой нагрузки,

Δt_(н.о.) – нижнее предельное отклонение размеров ширины печатного проводника.

Минимальная допустимая ширина проводника по постоянному току рассчитывается по формуле:

t_(D_(min)) =(I_(max))/(j_(доп) *h) ,

где I_(max) – максимальный постоянный ток,

j_(доп) – допустимая плотность тока,

h - толщина печатного проводника.

Максимальная допустимая плотность тока при изготовлении ПП комбинированным позитивным методом варьируется от 100 до 250 А/(мм^2) . Для расчётов примем её равной 100 А/(мм^2) .

Из расчёта потребляемой мощности известно, что максимальный ток в печатных проводниках равен 14,3 мА.

Тогда минимальная ширина печатных проводников, при толщине медного слоя 18 мкм:

t_(D_(min)) =(14,3*10^(-3))/(100*0,018)=0,085 мм

Также необходимо рассчитать максимальную длину проводника с учётом допустимого падения напряжения для обеих групп:

t_(D_(min)) =(ρ*I_(max) *l)/(U_(доп) *h) ,

где ρ – удельное сопротивление слоя меди,

l – максимальная длина проводника,

U_(доп) – допустимое падение напряжение (принимается как 5% от напряжения питания).

Максимальная длина проводника – 50 мм:

t_(D_(min)) '=(0,0175*14,3*10^(-3) *0,050)/(12*0,05*0,018)≈0,125 мм

Рассчитываем минимальные ширины печатных проводников по формуле:

t_1 =t_(D_(min)) +|Δt_(н.о.) |=0,085+0,1=0,185

t_2 =t_(D_(min)) '+|Δt_(н.о.) |=0,125+0,1=0,225

Примем значения толщин групп печатных проводников равными t_1 =0,25 мм , а t_2 =0,25 мм (минимальные для класса точности 3).

Минимальное значение диаметров монтажных отверстий:

d=d_э +|Δd_(н.о.) |+r ,

где d_э – максимальный размер вывода устанавливаемого ЭРЭ,

Δd_(н.о.) – нижнее предельное отклонение от номинального диаметра монтажного отверстия,

r – разница между минимальным диаметром отверстия и максимальным диаметром вывода ЭРЭ.

Максимальный размер вывода устанавливаемого ЭРЭ равна 1,3 мм. Тогда по формуле можно высчитать минимальное допустимое значение диаметров монтажных отверстий:

d=1,3+0,1+0,1=1,5 мм

Примем значение диаметра монтажного отверстия равным 1,5 мм.

Минимальный диаметр контактных площадок:

D=d+Δd_(в.о.) +2b+Δt_(в.о.) +2Δd_(тр) +√(T_d^2 +T_D^2 +Δt_(н.о.)^2)

где Δd_(в.о.) – верхнее предельное отклонение диаметра отверстия,

b – гарантийный поясок,

Δd_(тр) – величина подтравливания диэлектрика в отверстии (0 – для ДПП),

T_d – позиционный допуск расположения отверстия,

T_D – позиционный допуск расположения контактной площадки,

Δt_(в.о.) – верхнее предельное отклонение ширины печатного проводника,

Δt_(н.о.) – нижнее предельное отклонение ширины печатного проводника.

Тогда минимальный диаметр контактных площадок:

D=1,5+0+2*0,04+0,05+0+√(0,000064+0,000225+0,0001)≈1,59

Примем размер контактной площадки равной 1,6 мм.

Расчёт минимального расстояния между элементами проводящего рисунка:

S=S_(minD) +Δt_(в.о.) +(T_1)/2 ,

где S_(minD) – минимально допустимое расстояние между элементами проводящего рисунка (для фольгированного стеклотекстолита с напряжением менее 25 В принимается равным 0,1 мм),

T_1 – позиционный допуск расположения печатных проводников.

Тогда:

S=0,1+0,1+(0,05)/2=0,225

Примем S = 0,25 мм.

## 1.8 Разработка печатной платы изделия

На основе вычисленных параметров печатного монтажа была разработана топология печатной платы.

При компоновке были учтены требования оптимальных функциональных связей между модулями, их устойчивость и стабильность, требования прочности и жесткости, помехозащищенности и нормального теплового режима, требования технологичности, эргономики, удобства эксплуатации и ремонта. Внешний вид электронного модуля представлен на рисунке 2.5.


Рисунок 2.5 – Внешний вид электронного модуля

Топология печатной платы представлена на рисунках 2.6 и 2.7.


Рисунок 2.6 - Топология верхнего слоя печатной платы


Рисунок 2.7 - Топология нижнего слоя печатной платы

Чертеж печатной платы ИУ4.11.03.03.25.07.73.11.002 представлен на рисунке 2.8 и в Приложении А.

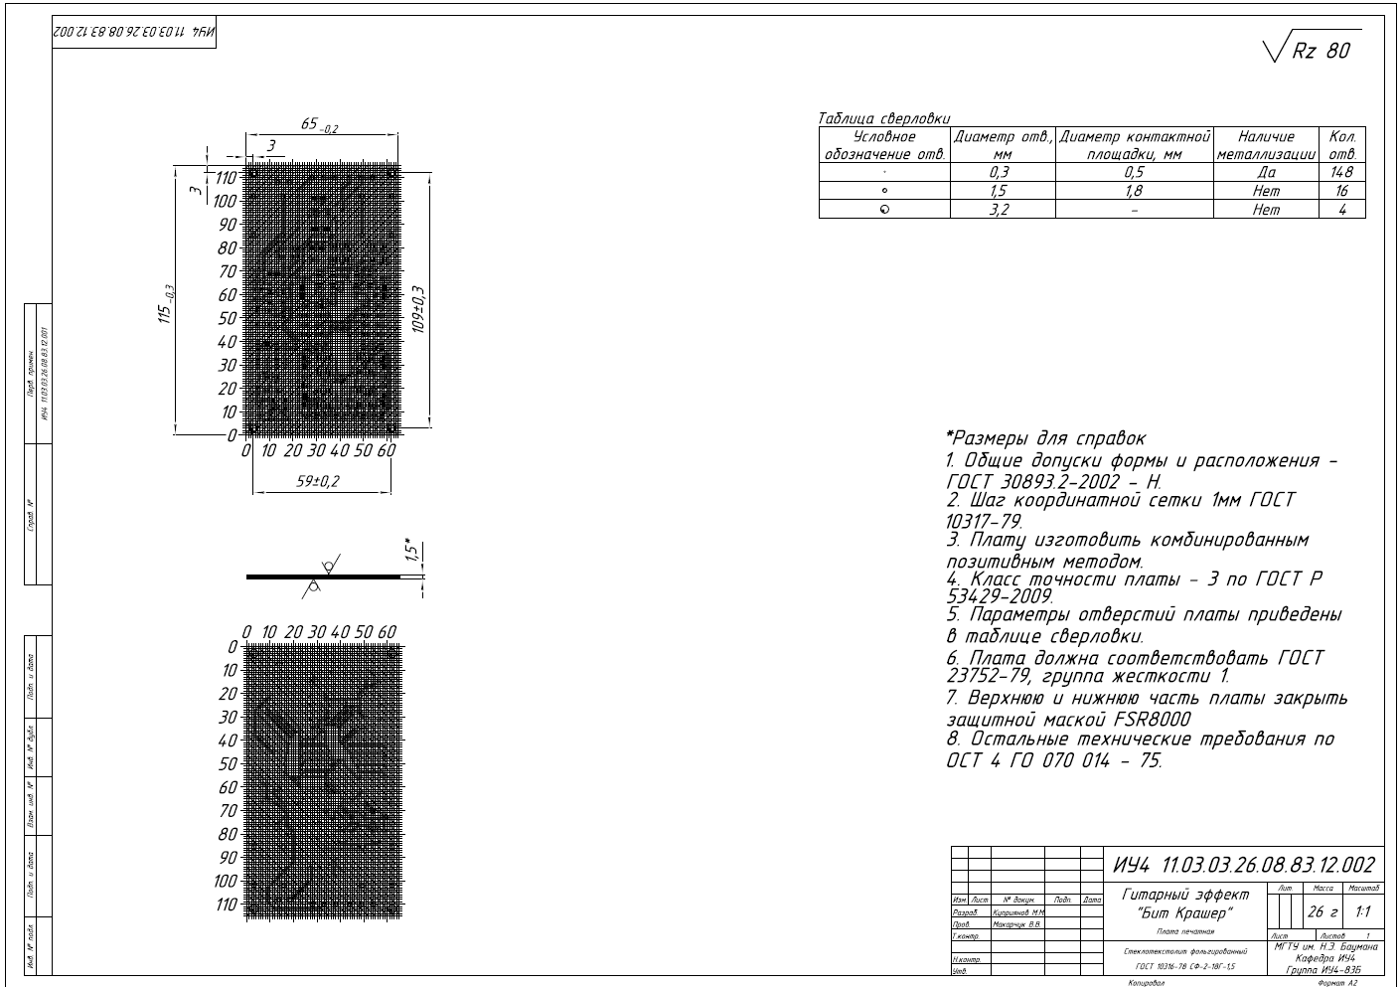
[picture p80: figure]

Рисунок 2.8 – Чертеж печатной платы изделия

Разработка топологии печатной платы устройства производилась в САПР Altium Designer 21. Готовая плата соответствует требованиям ГОСТ 53429-2009 [8], 3-й класс точности. Шаг координатной сетки 1,0 мм.

## 1.9 Разработка электронного модуля изделия

Сборочный чертёж электронного модуля представлен на рисунке 2.9, а также на чертеже ИУ4.11.03.03.24.07.73.11.001 СБ (Приложение А).

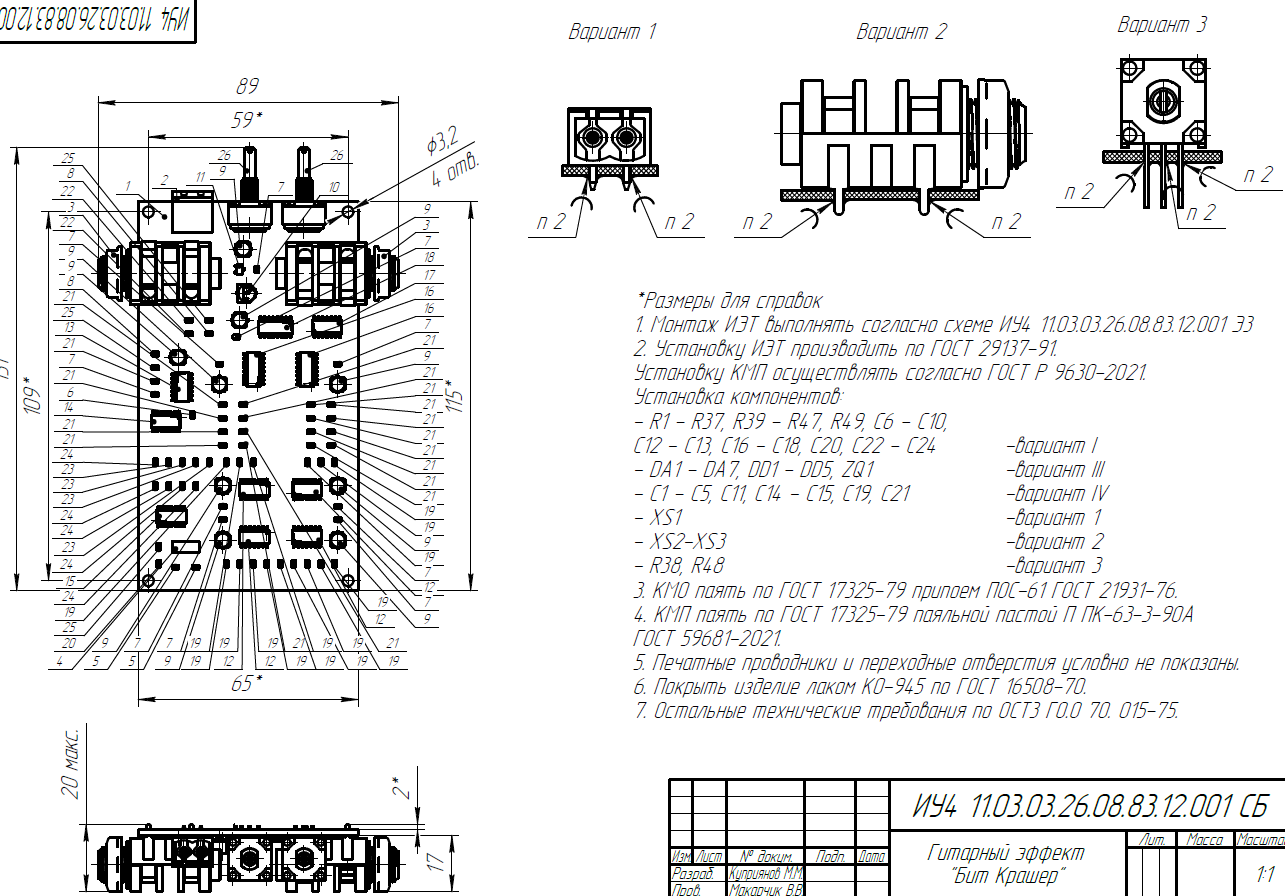
[picture p81: figure]

Рисунок 2.9 – Сборочный чертеж электронного модуля

Для защиты электронного модуля от влаги необходимо нанесение электроизоляционного лака на места паянных соединений. Для этого был выбран акриловый лак PLASTIK-71 ТУ 2389-001-78983067-05, как наиболее удобный для нанесения, надёжный, а также дешёвый среди аналогов.

## 1.10 Расчет теплового режима

Целью расчета является определение температур нагретой зоны и среды вблизи поверхности ЭРЭ, необходимых для оценки надёжности. Для получения более точных данных производилось моделирование теплового режима в пакете FloEFD САПРа Solid Edge 2022 [9], т.к. моделирование в нём дает возможность проводить комплексный анализ и симуляцию внутренних потоков и теплообмена.

Были установлены определенные условия моделирования. Некоторые из этих условий включают:

Окружающая среда: для моделирования теплового режима использовался воздух, что является типичной окружающей средой для моделируемого устройства.

Температура окружающей среды: для моделирования принята температура окружающей среды 20°C, как температура окружающей среды типичная для жилых помещений.

Рассеивающая мощность компонентов: В модели учтены только компоненты с рассеивающей мощностью более 0,1 мВт. Это позволяет сосредоточиться на наиболее значимых источниках тепла и провести более точный анализ их влияния на тепловой режим устройства. Так как в результате расчетов ни один из компонентов не рассеивает более указанной мощности, моделирование не учитывает рассеиваемую мощность компонентов.

Коэффициент теплопроводности для ПП и ЭРЭ: для моделирования использованы соответствующие значения коэффициентов теплопроводности для стеклотекстолита FR4 (материал печатной платы) и пластика (материал элементов радиоэлектроники). Эти значения важны для правильного расчета передачи тепла внутри устройства.

Геометрия: для проведения анализа использовалась упрощённая модель электронного модуля и устройства, которые позволяют сократить общий объём вычислений, не влияя на конечное значение результата.

Все это позволяет оценить эффективность системы охлаждения, выявить потенциальные проблемы с перегревом и принять соответствующие меры для обеспечения нормального теплового режима работы устройства.

Результаты теплового анализа представлены на рисунке 2.10.


Рисунок 2.10 - Результаты теплового анализа изделия

Наиболее чувствительные к верхней температурной границе компоненты – стабилизатор напряжения DA1 и операционный усилитель DA6, максимально допустимая температура которого - +85 ℃. Сравнение температур нагревающихся компонентов с их максимально возможными допустимыми температурами представлено в таблице 2.2.

Таблица 2.2 - Сравнение температур нагревающихся компонентов с их максимально возможными допустимыми температурами

Компонент | Предельная температура, ℃ | Расчётная температура, ℃
DA1 | +85 | +33
DA6 | +85 | +32

Как видно из таблицы 2.2 ни у одного элемента расчётная температура не превышает максимально допустимую.

Нижняя граница температур согласно техническому заданию – 0℃. Но т.к. все компоненты выдерживают как минимум 0℃, то проводить моделирование при данной температуре окружающей среды бессмысленно.

Результаты моделирования позволяют убедиться, что температурные условия внутри устройства находятся в пределах допустимых значений, что способствует надежной и безопасной работе устройства.

## 1.11 Расчет на механические воздействия

Согласно ГОСТ 16019-2001 [10], разрабатываемое изделие относится к групповой аппаратуре С1, которая подразумевает стойкость к различным механическим и климатическим факторам.

В частности, требования к стойкости устройства включают воздействие синусоидальных вибраций и механических ударов при транспортировке.

Для синусоидальных вибраций указан следующий набор параметров:

- диапазон частот от 10 до 150 Гц,
- амплитуда ускорения 14,73 м/с² (1,5⋅g).

Относительно механических ударов при эксплуатации приведены следующие значения:

- пиковое ударное ускорение 49,1 м/с² (5⋅g),
- длительность удара 10 мс.

Эти параметры определяются для проверки устойчивости изделия к вибрациям и ударам, которым оно может подвергаться в процессе эксплуатации. Разработка изделия должна учитывать данные требования и предусмотреть соответствующие меры для обеспечения стойкости и надежности в условиях синусоидальных вибраций и механических ударов.

Т.к. закрепление устройства производится по четырём угловым монтажным отверстиям (по четырём точкам), для анализа механических воздействий необходимо использовать моделирование в специализированных компьютерных средах.

Было произведено частотное моделирование в САПР SolidEdge 2022 с использованием пакета FloEFD. Условия проведения моделирования, следующие:

- крепление электронного модуля обеспечивается монтажными отверстиями в четырех точках,
- геометрия ПП была упрощена для достижения необходимого результата,
- параметры и масса печатной платы соответствуют стеклотекстолиту СФ-2-18Г,
- материал для ЭРЭ соответствует пластику ABS.

Результат моделирования продемонстрирован на рисунках 2.11, 2.12, 2.13, 2.14, 2.15.


Рисунок 2.11 - Деформация электронного модуля при воздействии частоты первой моды


Рисунок 2.12 - Деформация электронного модуля при воздействии частоты второй моды


Рисунок 2.13 - Деформация электронного модуля при воздействии частоты третьей моды


Рисунок 2.14 - Деформация электронного модуля при воздействии частоты четвертой моды


Рисунок 2.15 - Деформация электронного модуля при воздействии частоты пятой моды

Результаты моделирования показывают, что существует 5 резонансных мод для проектируемого устройства. Собственные частоты этих мод указаны в таблице 2.3.

Таблица 2.3 – Собственные частоты электронного модуля

Номер моды | Собственная частота, Гц
1 | 770
2 | 1528
3 | 2593
4 | 3152
5 | 4099

Таким образом, на основе результатов моделирования можно сделать вывод, что проектируемое устройство будет работоспособным и сохранит свою функциональность при действии вибраций в заданном диапазоне от 10 до 150 Гц, т.к. ни одна из собственных частот не попадает в этот диапазон.

## 1.12 Расчет интенсивности отказов

Расчет интенсивности отказов заключается в определении показателей надежности изделия по известным характеристикам надежности составляющих компонентов и условиям эксплуатации.

Расчёт выполняется по методике π‑факторов, используемой для оценки интенсивности отказов изделий на импортной элементной базе.

Исходные данные: Нормальные условия окружающей среды. Уровень качества компонентов – коммерческий. Электрическая нагрузка элементов не превышает номинальных значений.

Интенсивность отказа компонентов с учетом условий эксплуатации изделия вычисляется по формуле:

λ_i = λ_b π_T π_E π_Q π_S ,

где λ_b – базовая интенсивность отказов элемента (FIT/шт);

π_T – температурный коэффициент;

π_E – коэффициент, учитывающий условия эксплуатации;

π_Q – коэффициент качества;

π_S – коэффициент электрической нагрузки.

Результаты вычислений представлены в таблице 2.4:

Таблица 2.4 – Интенсивность отказов компонентов

№ | Группа элементов | Кол-во | Выводы | λ_b, FIT/шт | K_T | K_э | K_к | K_c | λᵢ, FIT/шт | Σ(nᵢλᵢ), FIT
1 | Конденсатор электролитический | 1 | 2 | 200 | 1.8 | 1.0 | 1.0 | 1.0 | 360 | 360
2 | Конденсатор керамический | 14 | 2 | 10 | 1.3 | 1.0 | 1.0 | 1.0 | 13 | 182
3 | Резистор | 48 | 2 | 5 | 1.2 | 1.0 | 1.0 | 1.0 | 6 | 288
4 | ИМС аналоговая SOIC-8 | 1 | 8 | 120 | 1.5 | 1.0 | 1.0 | 1.1 | 198 | 198
5 | ИМС аналоговая SOIC-14 | 6 | 14 | 120 | 1.5 | 1.0 | 1.0 | 1.2 | 216 | 1296
6 | ИМС цифровая SOIC-14 | 2 | 14 | 100 | 1.5 | 1.0 | 1.0 | 1.2 | 180 | 360
7 | ИМС цифровая SOIC-16 | 3 | 16 | 100 | 1.5 | 1.0 | 1.0 | 1.3 | 195 | 585
8 | Кварцевый резонатор | | 4
9 | Разъём клеммный WR-TBL | 2 | 2 | 300 | 1.1 | 1.0 | 1.0 | 1.0 | 330 | 660
10 | Разъём Jack 6.35 мм | 2 | 4 | 350 | 1.1 | 1.0 | 1.0 | 1.0 | 385 | 770
11 | Печатная плата СФ-2-18Г, двусторонняя | 1 | — | 50 | 1.1 | 1.0 | 1.0 | 1.0 | 55 | 55

Суммарная интенсивность отказов:

λ_(сист) =∑_(i=1)^n n_i λ_i = 4774 FIT

Среднее время наработки на отказ:

T_(ср) = (10^9)/(λ_(сист))≈ 209000 ч ≈ 24 года.

С учетом нагрева компонентов в процессе работы (до 61°C) расчетное среднее время наработки на отказ устройства составляет менее 24 лет, что на порядок превышает минимальное требование, заданное в ТЗ (10000 часов). Устройство обладает высоким запасом по интенсивности отказов, что свидетельствует о качественно подобранной элементной базе.

## 1.13 Проектирование корпуса изделия

Согласно техническому заданию, устройство предполагается использовать при температуре окружающей среды от 0 °С до +40 °С. Относительная влажность 0…95% при температуре +25 °С и атмосферном давлении (8,3…10,6) 10⁴ Па.

Требования по механические воздействия: вибрации в диапазоне частот от 10 до 150 Гц с ускорением до 1,5g, а также ударные нагрузки с ускорением до 5g длительностью до 10 мс, предъявляются только во время транспортировки.

Корпус устройства выполняет несколько важных функций для обеспечения его надежной работы и защиты:

Во-первых, корпус должен обеспечивать прочное и надежное крепление печатной платы внутри устройства. Это важно для предотвращения перемещений и деформаций платы, которые могут привести к повреждению компонентов или нарушению электрических соединений.

Во-вторых, корпус должен быть способен выдерживать воздействия, такие как удары, вибрации и падения, чтобы предотвратить повреждение внутренних компонентов. Он должен обладать достаточной прочностью и амортизационными свойствами, чтобы поглощать энергию при ударах и смягчать воздействие вибраций.

В-третьих, корпус должен быть выполнен из материалов, обеспечивающих оптимальное сочетание легкости и прочности. Это позволяет уменьшить вес устройства и одновременно обеспечить достаточную жесткость и устойчивость к вибрационным нагрузкам. Такая конструкция позволяет избежать искажений и повреждений компонентов при воздействии вибраций.

В-четвёртых, корпус должен быть разработан с учетом экономической эффективности. Это включает в себя возможность мелкосерийного и серийного производства, использование стандартных компонентов и материалов, а также оптимизацию процессов сборки и монтажа. Такой подход позволяет снизить затраты на производство и обеспечить экономическую целесообразность устройства.

В-пятых, корпус должен обеспечивать удобный доступ ко всем внутренним компонентам для обслуживания и ремонта. Это включает наличие съемных панелей или крышки, легкость снятия и установки компонентов, а также обеспечение доступа к разъемам и соединениям. Удобство обслуживания и ремонта упрощает обслуживание устройства, сокращает время и затраты на его обслуживание.

В-шестых, корпус придает устройству законченный внешний вид и защищает его от воздействий окружающей среды, таких как пыль, влага, химические вещества и электромагнитные помехи. Он должен быть выполнен из материалов, которые обладают необходимой степенью защиты и электромагнитной совместимости.

Все эти требования и функции корпуса устройства взаимосвязаны и важны для обеспечения надежной работы и защиты устройства во время эксплуатации. В результате проведённого анализа в качестве материала для изготовления корпусов устройства выбран ударопрочный пластик ABS (акрилонитрил бутадиен стирол) ГОСТ 33366.1-2015 [11]. Выбор ABS в качестве материала для изготовления корпусов устройства обоснован его свойствами и соответствием требованиям. Изделие спроектировано для изготовления на 3D-принтере с применением FDM-технологии.

Корпус состоит из 2 деталей: основания и крышки. Внешний вид и чертеж основания корпуса изображены на рисунках 2.16 и 2.17.


Рисунок 2.16 – Внешний вид основания корпуса

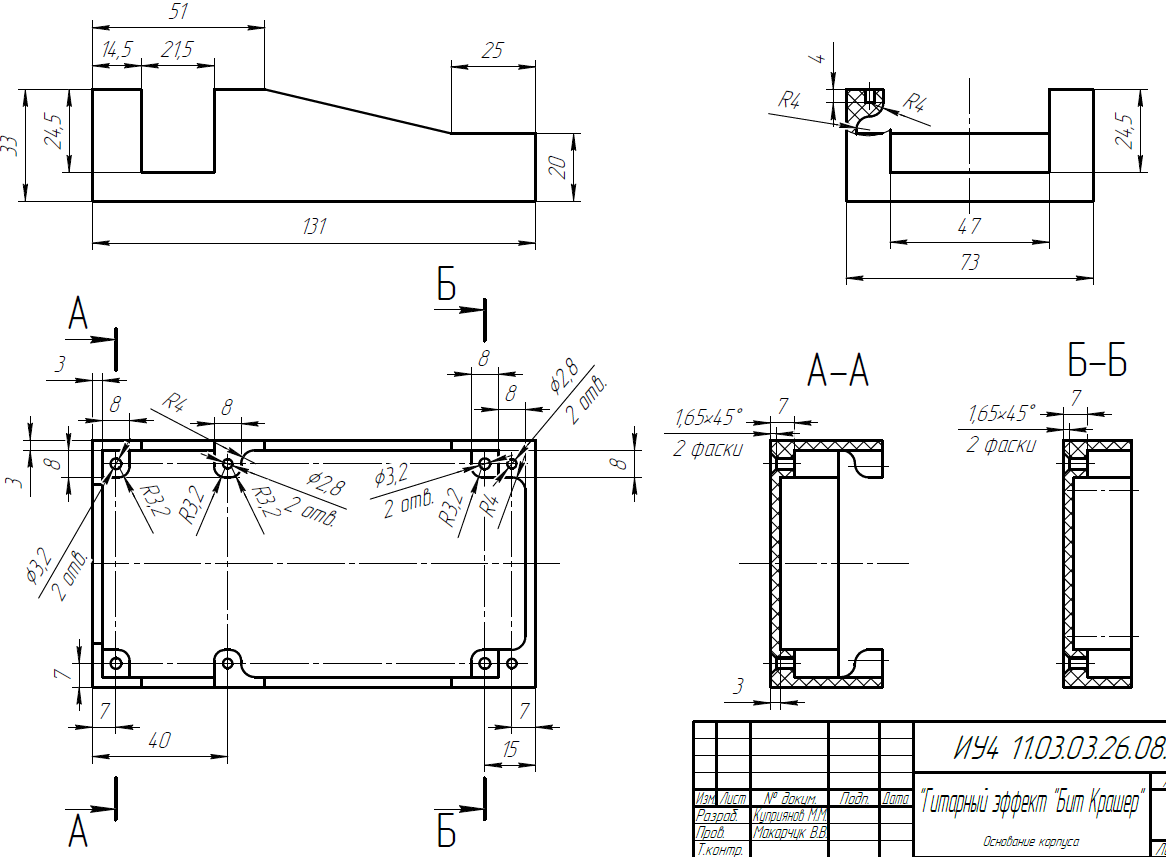
[picture p82: figure]

Рисунок 2.17 – Чертеж основания корпуса

Внешний вид и чертеж крышки показаны на рисунках 2.18 и 2.19.


Рисунок 2.18 - Внешний вид крышки корпуса


Рисунок 2.19 - Чертеж крышки корпуса

Внешний вид и чертеж изделия в сборе представлены на рисунке 2.20 и 2.21.


Рисунок 2.20 – Внешний вид изделия в сборе

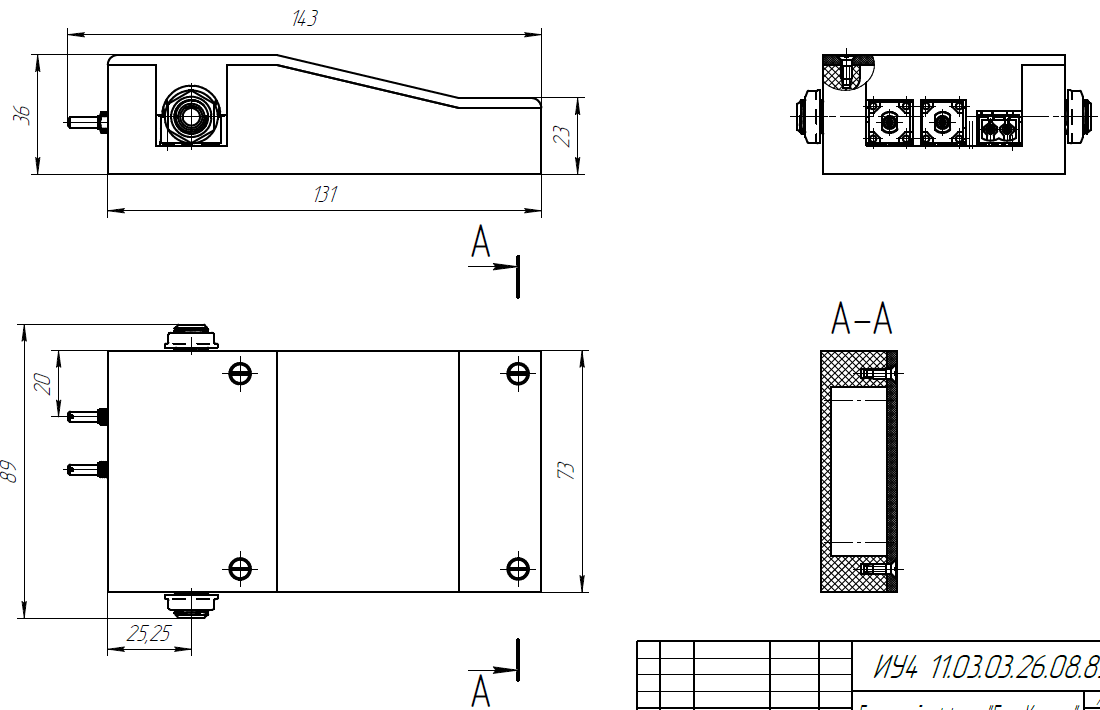
[picture p83: figure]

Рисунок 2.21 – Чертеж изделия в сборе

Габаритные размеры устройства равны 143×89×36 мм, что удовлетворяет условиям технического задания.

Приведенные расчеты показывают разработанные корпус и крышка, предназначены для изготовления с применением FDM-технологии, что дает возможность точно соответствовать требованиям проектирования, обеспечивает гибкость и экономическую эффективность процесса производства, а также упрощает обслуживание и ремонт устройства.

## Выводы

В схемотехнической части этой главы были разработаны электрические схемы устройства «Гитарный эффект «Бит Крашер». Начиная со схемы электрической структурной (Э1), в которой архитектура была разделена на 10 логических блоков, производилось уточнение связей: сначала до схемы электрической функциональной (Э2), а после и до электрической принципиальной (Э3).

Затем были подобраны и проанализированы электронные компоненты для дальнейшего проектирования электронного модуля устройства. Также для ЭРЭ и ИМС проведены расчеты нагрузок. Далее были вычислены необходимые параметры печатной платы. На основе данных о компонентах и ПП создана топология печатной платы, на которой КМО и КМП расположены с одной стороны, в то время как печатные проводники – с двух. Топология была представлена в виде чертежа ПП, а электронный модуль – в виде сборочного чертежа.

На следующем этапе произведены расчеты электронного модуля ГЭ: тепловой режим, механические воздействия и интенсивность отказов. Полученные данные удовлетворяют условиям ТЗ.

Завершающей частью главы стала разработка корпуса изделия. В качестве материала был выбран ABS пластик для удобной FDM-печати. Разработанные детали корпуса и изделие в сборе были представлены в виде 3D-моделей и чертежей.

По итогам этой главы было разработано функционирующее устройство «Гитарный эффект «Бит Крашер», соответствующее целям и задачам работы. Результаты работы оформлены в чертежах и таблицах, представленных в главе.

# 2 ТЕХНОЛОГИЧЕСКИЙ РАЗДЕЛ РАЗРАБОТКИ ИЗДЕЛИЯ «ГИТАРНЫЙ ЭФФЕКТ «БИТ КРАШЕР»

## 2.1 Анализ конструкторской документации изделия

В список разработанных для изделия деталей входят электронный модуль (печатная плата с установленными на нее ЭРЭ и ИМС), основание корпуса и его крышка. Габаритные размеры, получившиеся после проектирования и изготовления изделия, составляют 143×89×36 мм.

Выберем типы пайки электронных компонентов на печатную плату. При единичном и мелкосерийном производстве осуществляется пайка паяльником для КМО и пайка феном для КМП. При крупносерийном и массовом производстве рекомендуется осуществлять пайку групповой заготовки КМО волной и пайку КМП в печи. Так как количество КМО в конструкции мало, используем следующие типы: пайка в печи для КМП, пайка паяльником для КМО. Монтаж элементов на плате односторонний.

Здесь и далее рассматриваются технологические аспекты производства для серийного процесса.

ЭРЭ и ИМС, размещенные на плате, можно разделить на следующие группы, указанные в порядке установки на ПП:

- интегральные цифровые и аналоговые микросхемы в корпусе типа SOIC, устанавливаемые на поверхность.
- интегральные аналоговые микросхемы в корпусе типа SOT, устанавливаемые на поверхность,
- резисторы и конденсаторы в корпусе типоразмера 0805, устанавливаемые на поверхность,
- конденсаторы в корпусах типоразмера A (3216) и C (6032), устанавливаемые на поверхность,
- потенциометры, устанавливаемые в отверстие,
- разъемы, устанавливаемые в отверстие.

Выводы ЭРЭ, монтируемых в отверстие, формовки не требуют.

На основе анализа конструкторской документации для разработки ТП сборки и монтажа устройства необходимо предусмотреть поузловую сборку:

- сборка электронного модуля,
- сборка корпуса, которая включает монтаж электронной модуля на основание и установку крышки.

## 2.2 Анализ сборочного состава

В таблице 3.1 представлен анализ сборочного состава электронного модуля изделия «Гитарный эффект «Бит Крашер».

Таблица 3.1 - Анализ сборочного состава электронного модуля

№ п/п | Наименование и обозначение ЭРЭ | Внешний вид компонентов | Эскиз установки | Операция | Код операции

Чип резистор (SMD) 0805 10 КОм купить в магазине радиотехники «Проконтакт»

1 | Резисторы: R1-R49 Конденсаторы: C6-C10, C12-C13, C16-C18, C20, C22-C24 Кварцевые резонаторы: ZQ1 | | | Монтаж КМП | 8878
2 | Конденсаторы: С1-C5, C11, C14-C15, C19, C21 | | | Монтаж КМП | 8878

Купить Микросхема TLC7733ID SOIC8 на сайте официального дилера по выгодной цене - ООО "ТСИ"

3 | Микросхемы: DA1 | | | Монтаж КМП | 8878

OP747ARZ, прецизионный ОУ 4 канала малошумящий SOIC14

4 | Микросхемы: DA2-DA7, DD3-DD4 | | | Монтаж КМП | 8878
5 | Микросхемы: DD1-DD2, DD5 | | | Монтаж КМП | 8878

Потенциометр (резистор) — Википедия

6 | Потенциометры: R38, R48 | | | Монтаж КМО | 8881

691313510002 WURTH ELEKTRONIK, Terminal Block, Header, 5.08 mm | element14 Australia

7 | Разъемы: XS1-XS2 | | | Монтаж КМО | 8881

Купить Rean NYS 215 панельный разъём 1/4 Phone Jack 6.3 мм "мама", стерео в Москве по цене 37 ₽ в интернет-магазине - описание, фото, параметры, видео, отзывы

8 | Разъемы: XS3-XS4 | | | Монтаж КМО | 8881

Способы сборки деталей корпуса представлены в таблице 3.2.

Таблица 3.2 - Способы сборки деталей корпуса

№ п/п | Наименование | Эскиз варианта установки | Характеристика варианта установки и способа фиксации | Примечания


1 | Установка модуля электронного на основание | | Установка с помощью винтов и гаек | На эскизе: 1 –основание, 2 – винт, 3 - гайка


2 | Присоединение крышки к основанию | | Установка с помощью винтов | На эскизе: 4– крышка, 5 – винт

Пайка выводов КМО компонентов производится согласно ГОСТ 23592-96 [12]. После сборки изделие промывают в ультразвуковой очистительной ванне со очистительной смесью ОЖ-21А по ТУ 2381-001-07518266-2009. Контроль паяных соединений производится визуально-оптическим методом 16х по ГОСТ 24715-81 [13].

## 2.3 Расчет и анализ коэффициента технологичности

Оценку технологичности конструкции ячеек электронных проводят по комплексному показателю технологичности, который рассчитывается по базовым показателям технологичности по формуле:

K=(∑_(i=1)^n (K_i φ_i ))/(∑_(i=1)^n (φ_i )) ,

где Ki – базовые показатели технологичности конструкции ячейки электронной,

φi – весовые коэффициенты базовых показателей технологичности.

Исходные данные для расчета и анализа технологичности конструкции модуля электронного получают путем анализа конструкторской документации. Показатели для расчета и анализа технологичности представлены в таблице 3.3.

Таблица 3.3 - Показатели для расчета и анализа технологичности

Наименование | Обозначение | Значение
Количество ИМС | Нимс | 12
Количество контактных соединений, полученных механизированным путем | Нм.к. | 309
Общее количество соединений | Нм. | 325
Количество элементов, подготавливаемых механизированным путем | Нм.п. | 84
Количество операций механизированного контроля и настройки | Нм.к.н. | 2
Общее количество операций контроля и настройки | Нк.н. | 3
Количество типов номиналов ИЭТ | Нт.ИЭТ | 25
Количество типов номиналов оригинальных ИЭТ | Нт.ор.ИЭТ | 0
Общее число ИЭТ | Hиэт | 89

В таблице 3.4 представлены значения базового коэффициента технологичности, а также коэффициенты технологичности для устройства.

Таблица 3.4 - Значения базового коэффициента технологичности и коэффициенты технологичности

№ п/п | Наименование базового показателя | Расчетная формула | Значение, Ki | Весовой коэффи-циент, φ_i | Примечания
1 | Коэффициент использования ИМС | K_(ИМС) =(Н_(ИМС))/(Н_(ИЭТ)) | 0,13 | 1,0 | Hимс - количество ИМС Hиэт = Hимс + Hэрэ Конструкторский показатель.
2 | Коэффициент автоматизации монтажа | K_(АМ) =(Н_(м.к.))/(Н_М) | 0,95 | 0,8 | Hм.к.-количество монтажных соединений, полученных автоматизированным или механизированным способом. Hм- общее количество паяных соединений. Технологический показатель.
3 | Коэффициент механизации подготовки к монтажу | K_(МП) =(Н_(МП ИЭТ))/(Н_(ИЭТ)) | 0,94 | 0,5 | Hмп.иэт- число элементов, автоматически подготавливаемых к монтажу. Hиэт- общее число ИЭТ Технологический показатель.
4 | Коэффициент механизации контроля и настройки | K_(КН) =(Н_(МКН))/(Н_(КН)) | 0,67 | 0,5 | Hмкн-количество операций механизированного контроля и настройки Hкн-общее число операции контроля и настройки. Технологический показатель.
5 | Коэффициент повторяемости ИЭТ | K_(пов) =1-(Н_(Т ИЭТ))/(Н_(ИЭТ)) | 0,72 | 0,3 | Hт.иэт- число типноминалов ИЭТ. Hиэт-общее число ИЭТ Конструкторский показатель.
6 | Коэффициент применяемости ИЭТ | K_(пр ИЭТ) =1-(Н_(Т ОР ИЭТ))/(Н_(Т ИЭТ)) | 1 | 0,2 | Hт.ор.иэт- число оригинальных ИЭТ. Hт.иэт- число типовых ИЭТ Конструкторский показатель.
7 | Коэффициент использования прогрессивных форм | K_(АМ) =(Д_(пр))/Д | 0 | 0,1 | Дпр. - число деталей пространственной компоновки прогрессивной формы. Д - общее число деталей пространственной компоновки. Конструкторско-технологический показатель.

Комплексный показатель технологичности устройства для заданного объема выпуска определяется на основании базовых показателей по формуле:

K=(0,13×1,0+0,95×0,8+0,94×0,5+0,67×0,5+0,72×0,3+1×0,2+0)/(1,0+0,8+0,5+0,5+0,3+0,2+0,1)=(2,116)/(3,4)≈0,62

Полученное значение комплексного показателя технологичности соответствует нормативному комплексному показателю для серийного производства, хотя его можно назвать лишь удовлетворительным (ГОСТ 14.205-83 [14]). В серийном производстве используют специализированное, высокопроизводительное оборудование и стационарную оснастку, ориентированную на выполнение узкого круга операций, а также труда операторов с навыками работы на конкретных технологических линиях.

## 2.4 Разработка схемы сборки изделия в серийном производстве

Схема сборки необходима для описания последовательности основных сборочных операций и служит источником данных для разработки маршрутного ТП. Процесс сборки можно условно разделить на 2 этапа. На первом этапе производится сборка электронного модуля, на втором этапе – сборка устройства в корпус.

Схема сборки электронного модуля устройства представлена на рисунке 3.1.

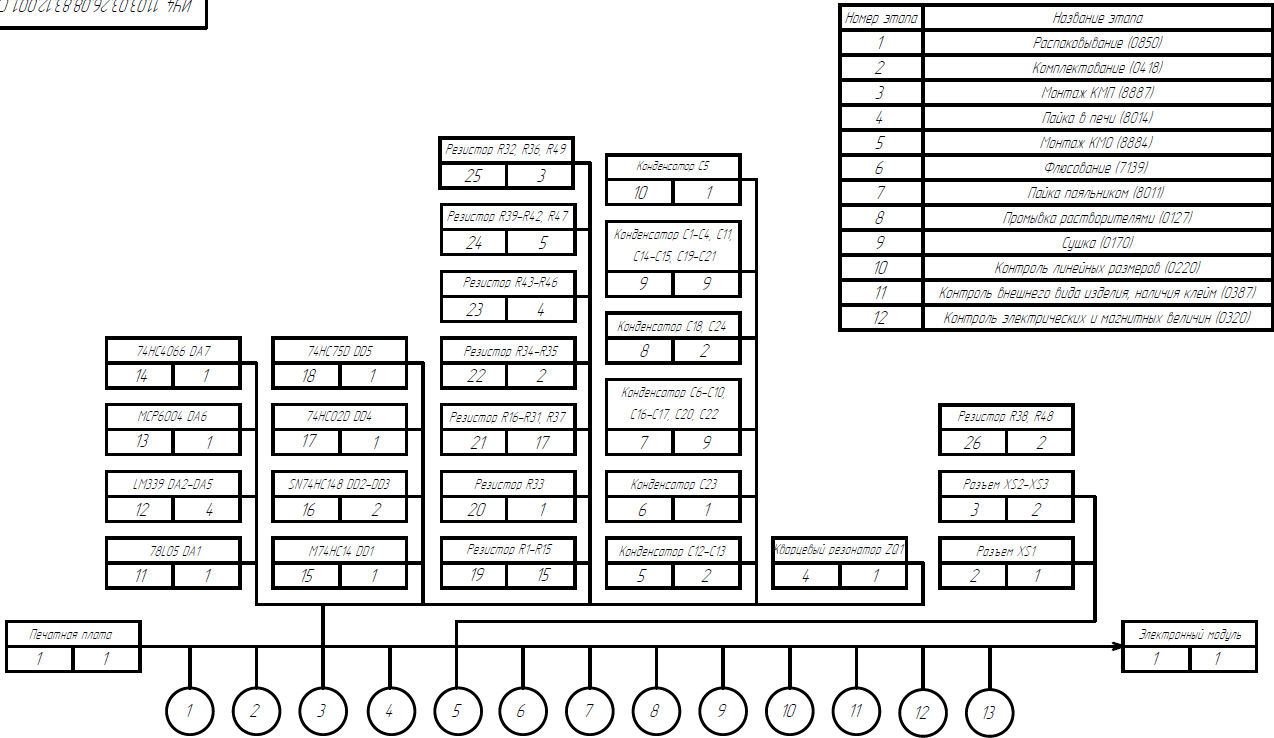
[picture p84: figure]

Рисунок 3.1 - Схема сборки электронного модуля

Для сборки устройства используются операции согласно классификатору технологических операций [15] в следующей последовательности:

  1. Распаковывание (0850);
  2. Комплектование (0418);
  3. Монтаж КМП (8887);
  4. Пайка в печи (8014);
  5. Монтаж КМО (8884);
  6. Флюсование (7139);
  7. Пайка паяльником (8011);
  8. Промывка растворителями (0127);
  9. Сушка (0170);
  10. Контроль линейных размеров (0220);
  11. Контроль внешнего вида изделия, наличия клейм (0387);
  12. Контроль электрических и магнитных величин (0320);
  13. Лакирование кистью (7427).

Схема сборки устройства в корпус представлена на рисунке 3.2.


Рисунок 3.2 – Схема сборки устройства в корпус

Последовательность сборки устройства:

  14. Комплектование (0418);
  15. Свинчивание с основанием корпуса (8831);
  16. Свинчивание с крышкой корпуса (8831);
  17. Маркирование (0186);
  18. Упаковывание (0837).

## 2.5 Разработка маршрутного технологического процесса сборки и монтажа устройства

Маршрутный технологический процесс сборки отражает последовательность выполнения технологических операций, содержит информацию об оборудовании и времени выполнения каждой операции. МТП разрабатывается на основе анализа конструкторской документации и схемы сборки опытного образца.

Маршрут сборки и монтажа ГЭ представлен в таблице 3.5.

Таблица 3.5 - Маршрут сборки и монтажа

№ опера-ции | Наименование работы | Оборудование | Изображение оборудования | Значение, с

Сборка ячейки электронной
05 | Распаковывание (0850) | Стол монтажный LANGER EMV 1500 | | 30
10 | Комплектование (0418) | Стол монтажный LANGER EMV 1500 | | 60


15 | Монтаж КМП (8878) | Стол монтажный LANGER EMV 1500, полуавтоматический установщик КМП Ersa EASYLINE 01 | | 120
20 | Пайка в печи (8014) | Многозональная печь Heller 1809 MK5 | | 300


25 | Монтаж КМО (8881) | Стол монтажный LANGER EMV 1500, полуавтоматический установщик КМО Mycronic MY500 | | 60
30 | Флюсование (7139) | Автомат распылительного флюсования Kurtz Ersa VERSAFLOW 4/55 | | 60
35 | Пайка волной (8018) | Волновая паяльная установка Kurtz Ersa ECOSELECT 350 | | 90

Система струйной отмывки печатных плат SAM SM-5600 - СМТМАКС

40 | Промывка растворителями (0127) | Моечная машина AQUEOUS TECHNOLOGIES CYCLONE BATCH | | 120
45 | Сушка (0170) | Сушильная камера DESPATCH LAC1-27-10 | | 120
50 | Контроль внешнего вида изделия, наличия клейм (0387) | Стенд контроля Omron VT-S730 | | 60
55 | Контроль электрических и магнитных величин (0320) | Стенд контроля Omron VT-S730 | | 120
60 | Контроль линейных размеров (0220) | Стенд контроля Omron VT-S730 | | 60
65 | Лакирование кистью (7427) | Стол монтажный LANGER EMV 1500 | | 90

Сборка устройства
70 | Комплектование (0418) | Стол монтажный LANGER EMV 1500 | | 10

Высокоточная автоматическая машина для завинчивания с счётчиком подающего устройства для винтов - Китай Автоматическая машина подачи шнека, механизм автоматической подачи шнека

75 | Свинчивание с основанием корпуса (8831) | Стол монтажный LANGER EMV 1500, автомат для завинчивания DEPRAG AUTOFEED SCREWDRIVING SYSTEM MINI-MAT | | 45
80 | Свинчивание с крышкой корпуса (8831); | Стол монтажный LANGER EMV 1500, автомат для завинчивания DEPRAG AUTOFEED SCREWDRIVING SYSTEM MINI-MAT | | 45

Каплеструйный маркиратор KDM Inkjet 800 — ручной принтер с высотой печати до 25 мм | Купить в Москве | КДМ ТРЕЙДИНГ

85 | Маркирование (0186); | Каплеструйный маркиратор VIDEOJET 1580 | | 20
90 | Упаковывание (0837); | Стол монтажный LANGER EMV 1500 | | 30
Штучное время сборки | | | | 1440

Суммарное штучное время Тшт = 1440 сек. Полученное значение штучного времени сборки и монтажа обеспечивает сборку изделия в серийном производстве.

## 2.6 Расчет и анализ такта выпуска

Анализ объема выпуска изделия проводится с целью определения возможности выпуска изделий по данному ТП с заданным объемом в установленные сроки путем сравнения штучного времени сборки изделия с заданным тактом выпуска. По результатам анализа такта выпуска принимается решение о необходимости изменения технологического процесса, и даются рекомендации по выбору более производительного оборудования, использованию групповых методов обработки, подбирается объем партий изделий. Такт выпуска определяется по формуле:

Т_в =(Ф×60)/(N_(вып)) ,

где Tв – такт выпуска [ч.],

Ф = 2070 – годовой фонд рабочего времени [ч.],

NВЫП = 5000 – годовая программа выпуска [шт.].

Тогда:

Т_в =(2070×60)/5000=24,84(мин)/(шт)=1490с/(шт)

Из сравнения штучного времени сборки устройства (Tшт = 1440 с) и такта выпуска (Тв = 1490 с) следует, что технологический процесс сборки и монтажа обеспечивает сборку изделий в серийном производстве в соответствии с производственным планом выпуска.

## 2.7 Разработка маршрутно-операционного технологического процесса сборки изделия

В таблице 3.6 приведен разработанный маршрутно-операционный техпроцесс сборки и монтажа изделия.

Таблица 3.6 - Маршрутно-операционный техпроцесс сборки и монтажа

№ операции/ перехода | Операция/переход | Оборудование и оснастка | Изображение оборудования и оснастки | Материалы | Режимы | Тшт, с
| Сборка электронной ячейки
10 | Распаковывание ПП, ЭРЭ и ИМС (0850) | Стол монтажный LANGER EMV 1500 | | | | 30

Транспортная упаковка: определение, виды и характеристики | Packresource

01 | Извлечь печатную плату из упаковочной тары, поместить в тару технологическую | Тара упаковочная, тара технологическая
02 | Извлечь ЭРЭ/ИМС из упаковочной тары | Тара упаковочная
03 | Повторить переход 02 для всех ЭРЭ и ИМС
20 | Комплектование (0418) | Стол монтажный LANGER EMV 1500 | | | | 60
01 | Положить ЭРЭ и ИМС в тару технологическую согласно сборочному чертежу и спецификации | Тара технологическая | | Сборочный чертеж, спецификация

Ручной трафаретный принтер ФЕБА - Купить в "Авантех"

30 | Монтаж КМП (8878) | Стол монтажный LANGER EMV 1500, трафаретный принтер паяльной пасты DEK Horizon 03iX, полуавтоматический установщик КМП Ersa EASYLINE 01 | | | | 120
01 | Извлечь ПП из технологической тары, установить печатную плату на стол трафаретного принтера | Тара технологическая, трафаретный принтер паяльной пасты DEK Horizon 03iX

Ракель для паяльной пасты - купить недорого | AliExpress

02 | Нанести паяльную пасту через трафарет | Трафаретный принтер паяльной пасты DEK Horizon 03iX, ракель DEK 265mm PROFILE Squeegee Blade | | Паяльная паста ППС-63-3-90А
03 | Извлечь КМП из технологической тары, установить компонент на плату согласно сборочному чертежу | Тара технологическая, полуавтоматический установщик КМП Ersa EASYLINE 01
04 | Повторить переход 03 для всех КМП
05 | Провести визуальный контроль правильности установки компонентов
40 | Пайка в печи (8014) | Многозональная печь Heller 1809 MK5 | | | | 300
01 | Закрепить печатную плату в печи | Многозональная печь Heller 1809 MK5
02 | Оплавить паяльную пасту в печи согласно режиму пайки | Многозональная печь Heller 1809 MK5 | | | 1. 3℃/с 2. 175℃ 3. 240℃ 4. -4℃/с | 1. 50 2. 100 3. 50 4. 60
04 | Извлечь плату из печи | Многозональная печь Heller 1809 MK5
03 | Провести визуальный контроль правильности пайки компонентов, поместить в тару технологическую | Тара технологическая
50 | Монтаж КМО (8881) | Стол монтажный LANGER EMV 1500, полуавтома-тический установщик КМО | | | | 60
01 | Извлечь КМО из технологической тары, установить компонент на плату согласно сборочному чертежу | Технологическая тара, полуавтоматический установщик КМО Mycronic MY500
02 | Повторить переход 01 для всех КМО
03 | Провести визуальный контроль правильности установки компонентов
60 | Флюсование (7139) | Автомат распылительного флюсования Kurtz Ersa VERSAFLOW 4/55 | | | | 60
01 | Закрепить плату в автомате распылительного флюсования | Автомат распылительного флюсования Kurtz Ersa VERSAFLOW 4/55
02 | Нанести флюс на контактные площадки распылением | Автомат распылительного флюсования Kurtz Ersa VERSAFLOW 4/55 | | Флюс ПВ-209
03 | Снять плату с автомата | Автомат распылительного флюсования Kurtz Ersa VERSAFLOW 4/55
70 | Пайка волной припоя (8018) | Волновая паяльная установка Kurtz Ersa ECOSELECT 350 | | | | 90
01 | Закрепить плату в волновой паяльной установке | Волновая паяльная установка Kurtz Ersa ECOSELECT 350
02 | Припаять КМО волной | Волновая паяльная установка Kurtz Ersa ECOSELECT 350 | | Припой ПОС 61 | Температура Т=260+ 20℃
03 | Снять плату с установки | Волновая паяльная установка Kurtz Ersa ECOSELECT 350
04 | Провести визуальный контроль правильности установки компонентов, поместить плату в тару технологическую | Тара технологическая
80 | Промывка растворителями (0127) | Моечная машина AQUEOUS TECHNOLOGIES CYCLONE BATCH | | | | 120
01 | Извлечь плату из технологической тары, поместить в ванну моечной машины | Тара технологическая, моечная машина AQUEOUS TECHNOLOGIES CYCLONE BATCH
02 | Подать растворитель выше уровня покрытия паяных соединений | Моечная машина AQUEOUS TECHNOLOGIES CYCLONE BATCH | | Раство-ритель марки 645
03 | Выполнить ультразвуковую промывку | Моечная машина AQUEOUS TECHNOLOGIES CYCLONE BATCH
04 | Извлечь плату из моечной машины | Моечная машина AQUEOUS TECHNOLOGIES CYCLONE BATCH
90 | Сушка (0170) | Сушильная камера DESPATCH LAC1-27-10 | | | | 120
01 | Установить плату в сушильную камеру | Сушильная камера DESPATCH LAC1-27-10
02 | Обдуть печатную плату и установленные элементы струей сжатого воздуха со всех сторон | Сушильная камера DESPATCH LAC1-27-10 | | | 0,5 МПа
03 | Провести визуальный контроль сушки, поместить плату в тару технологическую | Тара технологическая
100 | Контроль внешнего вида изделия, наличия клейм (0387) | Стенд контроля Omron VT-S730 | | | | 60
01 | Извлечь плату из технологической тары, поместить на стенд контроля | Тара технологическая

Биология – Тема: Увеличительные приборы

02 | Осмотреть поверхность платы, проверить отсутствие остатков флюса, капель припоя, посторонних включений | Оптический увеличительный прибор (увеличение в 5 раз) Vision Engineering Lynx EVO
03 | Проверить качество паяных соединений: отсутствие непропая, наплывов, перемычек, трещин | Оптический увеличительный прибор (увеличение в 5 раз) Vision Engineering Lynx EVO
04 | Проверить расположение и ориентацию всех элементов по маркировке и монтажной схеме | Оптический увеличительный прибор (увеличение в 5 раз) Vision Engineering Lynx EVO

STABILO Контрольные листы проверки лестниц и подставок (50 шт.)

05 | Записать результаты контроля | Контрольный лист
06 | Поместить плату в тару технологическую | Тара технологическая
110 | Контроль электрических и магнитных величин (0320) | Стенд контроля Omron VT-S730 | | | | 120
01 | Извлечь плату из технологической тары, поместить на стенд контроля | Тара технологическая

КВТ Измерительные щупы

02 | Подключить измерительные щупы, к контрольным точкам схемы | Измерительные щупы Fluke TL75 Test Lead Set
03 | Измерить напряжения питания, падение напряжения в контрольных точках | Измерительные щупы Fluke TL75 Test Lead Set
04 | Проверить параметры работы узла по схеме — выходные сигналы, коэффициенты передачи, уровни логических сигналов | Измерительные щупы Fluke TL75 Test Lead Set
05 | Сопоставить полученные значения с допустимыми по техническим условиям, конструкторской документации | | | Технические условия, конструк-торская докумен-тация
06 | Записать значения и результаты контроля в контрольный лист | Контрольный лист
07 | Поместить плату в тару технологическую | Тара технологическая
120 | Контроль линейных размеров (0220) | Стенд контроля Omron VT-S730 | | | | 60
01 | Извлечь плату из технологической тары, поместить на стенд контроля | Тара технологическая

Штангенинструмент

02 | Проверить исправность инструмента, установить ноль | Штангенинструмент, микрометр, индикатор, калибр (ШЦ-1)
03 | Измерить габаритные размеры | Штангенциркуль, микрометр, линейка, измерительная плита (ШЦ-1)

Координатно-измерительные машины ABERLINK серии Axiom too

04 | Измерить межосевые и установочные размеры | Индикатор, калибр, шаблон, координатная измерительная машина Mitutoyo STRATO-Apex 776

Микрометр гладкий МК-25 0,01 ЧИЗ - купить с доставкой по России

05 | Измерить размеры отверстий и пазы | Нутромер, микрометр Mitutoyo 293-821-30, предельные калибры-пробки
06 | Сопоставить полученные значения с допустимыми по техническим условиям, конструкторской документации | | | Технические условия, конструк-торская докумен-тация
07 | Записать значения и результаты контроля в контрольный лист | Контрольный лист
08 | Поместить плату в тару технологическую | Тара технологическая

Кисть плоская флейцевая 50мм (2 дюйма) купить от 50 ₽ - ASpro-Сибирь

130 | Лакирование кистью (7427) | Стол монтажный LANGER EMV 1500, кисть плоская флейцевая | | | | 90
01 | Извлечь плату из технологической тары, поместить на монтажный стол | Тара технологическая
02 | Нанести лак кистью на поверхности платы | Кисть плоская флейцевая
03 | Подождать 60 секунд для высыхания лака на плате
04 | Поместить плату в тару технологическую | Тара технологическая
| Сборка устройства
140 | Комплектование (0418) | Тара технологическая | | | | 10
01 | Положить основание корпуса, винты и гайки в тару технологическую согласно сборочному чертежу и спецификации | Тара технологическая | | Сборочный чертеж, специфика-ция
150 | Свинчивание с основанием корпуса (8831) | Стол монтажный LANGER EMV 1500, автомат для завинчивания DEPRAG AUTOFEED SCREWDRIVING SYSTEM MINI-MAT | | | | 45
01 | Извлечь плату, основание корпуса, гайки и винты из технологической тары, поместить на монтажный стол | Тара технологическая
02 | Совместить установочные отверстия, установить ячейку на основание
03 | Вставить винты в отверстия
04 | Надеть гайки на винты, завернуть вручную на 3 витка резьбы для центрирования
05 | Затянуть гайки в диагональном порядке, обеспечивая равномерное прижатие электронной ячейки к основанию | Автомат для завинчивания DEPRAG AUTOFEED SCREWDRIVING SYSTEM MINI-MAT
06 | Проверить положение электронной ячейки, отсутствие перекоса, зазоров, повреждений покрытия
07 | Поместить устройство в тару технологическую | Тара технологическая
160 | Свинчивание с крышкой корпуса (8831) | Стол монтажный LANGER EMV 1500, автомат для завинчивания DEPRAG AUTOFEED SCREWDRIVING SYSTEM MINI-MAT | | | | 45
01 | Извлечь плату, основание корпуса и винты из технологической тары, поместить на монтажный стол | Тара технологическая
02 | Совместить установочные отверстия, установить крышку на основание
03 | Вставить винты в отверстия, завернуть вручную на 3 витка резьбы для центрирования
04 | Затянуть винты в диагональном порядке, обеспечивая равномерное прижатие электронной ячейки к основанию | Автомат для завинчивания DEPRAG AUTOFEED SCREWDRIVING SYSTEM MINI-MAT
05 | Проверить положение электронной ячейки, отсутствие перекоса, зазоров, повреждений покрытия
06 | Поместить устройство в тару технологическую | Тара технологическая
170 | Маркирование (0186) | Каплеструйный маркиратор VIDEOJET 1580 | | | | 20
01 | Извлечь устройство из технологической тары, поместить на монтажный стол | Тара технологическая
02 | Очистить маркируемую поверхность от пыли, влаги, масел | | | Ветошь, спирт
03 | Разместить корпус на монтажном столе, обеспечить правильную ориентацию поверхности под печать
04 | Активировать процесс нанесения надписи | Каплеструйный маркиратор VIDEOJET 1580
05 | Проверить чёткость, читаемость и полноту нанесённой информации, правильность расположения надписи
06 | Поместить устройство в тару технологическую
180 | Упаковывание (0837) | Стол монтажный LANGER EMV 1500 | | | | 30
01 | Извлечь устройство из технологической тары, поместить на монтажный стол | Тара технологическая
02 | Поместить устройство в индивидуальный пакет | | | Индиви-дуальный пакет
03 | Разместить упакованное изделие в коробке | | | Коробка
04 | Вложить паспорт, руководство по эксплуатации | | | Паспорт, руководство по эксплуа-тации

Канцелярский нож Attache с фиксатором красный 18 мм - купить с доставкой на дом в Купер

05 | Закрыть коробку, заклеить клейкой лентой | Нож канцелярский NT Cutter A-550P | | Клейкая лента
06 | Нанести стикер с обозначениями: наименование, артикул, количество, масса, знак обращения с грузом | | | Клейкий стикер
07 | Передать упакованные изделия на участок хранения/отгрузки | Тара технологическая

Таким образом, процесс сборки состоит из 18 операций, каждая из которых имеет до 10 переходов.

## 2.8 Разработка электронной модели

Процесс сборки электронной модели устройства «Гитарный эффект «Бит Крашер» представлен далее. На рисунке 3.3 продемонстрирована установка компонентов, монтируемых на поверхность. На рисунке 3.4 показана установка компонентов, монтируемых в отверстие. На рисунке 3.5 представлена установка ячейки на основание корпуса. На рисунке 3.6 показана установка крышки на основание корпуса.


Рисунок 3.3 - Установка компонентов, монтируемых на поверхность


Рисунок 3.4 - Установка компонентов, монтируемых в отверстие


Рисунок 3.5 - Установка ячейки на основание корпуса


Рисунок 3.6 - Установка крышки на основание корпуса

## Выводы

В данном разделе была проведена разработка технологического процесса для устройства «Гитарный эффект «Бит Крашер». При разработке учтены документация и информация о планируемых объемах производства, которое относится к категории «серийное». В результате этого в технологический процесс были включены автоматизированные процессы, такие как установка компонентов и нанесение паяльной пасты. Это позволяет повысить эффективность и точность сборки устройства.

Кроме того, были разработаны схема сборки устройства и маршрутно-операционный технологический процесс. Схема сборки дает общее представление о последовательности операций, необходимых для сборки устройства. Маршрутно-операционный технологический процесс содержит более детальную информацию о каждой операции, включая информацию об оборудовании, времени выполнения и другие технические детали.

Также, была проведена оценка технологичности изделия «Гитарный эффект «Бит Крашер». Расчет показал, что электронный модуль устройства подходит для серийного производства на предприятии. Это подтверждает, что технологический процесс разработан таким образом, чтобы обеспечить эффективную деятельность с учетом планируемых объемов выпуска устройства.

# 3 ЭКСПЕРИМЕНТАЛЬНЫЕ ИССЛЕДОВАНИЯ И ИСПЫТАНИЯ ИЗДЕЛИЯ «ГИТАРНЫЙ ЭФФЕКТ «БИТ КРАШЕР»

## 3.1 Разработка программы испытаний изделия

В данном разделе представлены результаты экспериментальных исследований разработанного изделия, согласно программе и методике испытаний, которая приведена ниже. Схема измерительного стенда показана на рисунке 4.1.


Рисунок 4.1 – Схема измерительного стенда изделия

На схеме указаны все необходимые для проведения эксперимента приборы, а также их взаимное подключение. Источник синусоидального имитирует входной сигнал музыкального инструмента. Источник напряжения подает необходимое питание на изделие. Осциллограф отображает результат преобразование сигнала изделием в виде временной диаграммы.

Программа испытаний предусматривает следующие действия:

1. Подключить источник напряжения +9В±10% к разъему XS1 разработанного изделия;
2. Подключить источник синусоидального сигнала амплитудой из диапазона 0,5-2В и частоты из диапазона 20 Гц – 25 кГц к разъему XS2;
3. Подключить вход осциллографа к разъему XS3;
4. Произвести подстройку предусилителя и аттенюатора разработанного изделия путем вращения ручек потенциометров R38 и R48 до требуемого результата временной диаграммы на экране осциллографа;
5. Сделать снимок полученной на экране осциллографа временной диаграммы;
6. Визуально оценить наличие гармоник в форме полученного сигнала;
7. Получить набор точек, соответствующих амплитуде и частоте полученного сигнала с экрана осциллографа для выполнения быстрого преобразования Фурье;
8. Провести быстрое преобразование Фурье и сравнить спектральную диаграмму с результатами моделирования.

## 3.2 Результаты моделирования изделия

Процесс разработки и тестирования схемы начался с моделирования в среде PSpice A/D [16]. Она обладает обширной библиотекой элементов и интуитивным интерфейсом, что выделяет ее среди аналогичных программ.

В результате моделирования была получена временная диаграмма сигнала на выходе схемы, показанная на рисунке 4.2.


Рисунок 4.2 – Временная диаграмма результата моделирования схемы

Визуальная оценка формы сигнала позволяет сделать вывод о корректности работы схемы изделия. На рисунке наблюдается синусоидальный сигнал, ступенчато дискретизированный по уровням, соответствующим 4 разрядному цифро-аналоговому преобразованию.

Далее средствами PSpice A/D было проведено быстрое преобразование Фурье. На рисунке 4.3 показана спектральная диаграмма сигнала для звукового диапазона сигналов (до 25 кГц).


Рисунок 4.3 - Спектральная диаграмма сигнала изделия

На спектрограмме наблюдается сигнал основной частоты 1 кГц, а также небольшие амплитуды более высоких частот, которые соответствуют искажениям, вносимым гитарным эффектом. Стоит отметить и довольно широкую полосу частот, в которой наблюдается основной сигнал.

По итогам моделирования можно подтвердить работоспособность модели схемы и зафиксировать результаты для сравнения с ними экспериментальных.

## 3.3 Результаты экспериментального исследования изделия

В этом подразделе описано исследование работоспособности готового изделия. После выполнения пункта 5 методики проведения эксперимента была зафиксирована временная диаграмма выходного сигнала, представленная на рисунке 4.4.


Рисунок 4.4 – Временная диаграмма результата эксперимента над изделием

Визуальный анализ сигнала подтверждает функционирование изделия. Выходной сигнал имеет синусоидальную форму, изменяющуюся ступенчато, и соответствует должному преобразованию. Он практически совпадает с результатом моделирования.

Далее с применением стороннего программного обеспечения был проведен спектральный анализ наблюдаемого сигнала. Он представлен на рисунке 4.5.


Рисунок 4.5 –Спектр выходного сигнала, полученный в результате эксперимента

Спектральный анализ практически идентичен результату моделирования. Он также имеет широкую частотную область нахождения основной гармоники и на нем можно наблюдать небольшие амплитуды на других частотах. Они обеспечивают необходимое искажение.

## Выводы

По итогам данного раздела была разработана программа испытаний для изделия «Гитарный эффект «Бит Крашер» и схема измерительного стенда. В ходе работы было проведено компьютерное моделирование и практические исследования собранного макета. Сравнение полученных результатов является важной частью разработки с целью обеспечения высокого уровня качества изделия.

Тестирование макета проводилось в условиях, близких к реальным. Результаты испытаний подтвердили корректное функционирование изделия. Исходя из результатов тестирования, можно сделать вывод, что разработанное изделие, реализующего эффект «Бит Крашер», соответствует требованиям технического задания в плане корректности и качества работы.

# ЗАКЛЮЧЕНИЕ

Процесс написания работы был начат с обоснования актуальности выбранной темы, для чего был проведен сравнительный анализ ее целей и задач, поставленных на основе требований к функциональности и главным параметрам спроектированного изделия.

По итогам исследования аналогов были выявлены достоинства и недостатки имеющихся на рынке изделий, что позволило противопоставить технические параметры разработанного изделия «Гитарный эффект «Бит Крашер» этим недостаткам. Таким образом была доказана целесообразность проектирования изделия.

Схемотехническое проектирование изделия было выполнено на основе анализа с помощью ТРИЗ архитектур существующих прототипов. В результате чего были созданы схемы электрическая структурная, функциональная и принципиальная. Они описывают взаимное соединение элементов модуля электроники изделия на разных уровнях декомпозиции. Дополнительно в данный раздел вошел анализ выбора электронных компонентов.

Как итог проведенного анализа выбраны параметры изготовления печатной платы, разработана ее топология. Далее определены характеристики сборки электронного модуля, на основе которых был разработан сборочный чертеж модуля. Заключает схемотехническую часть проведенный расчет тепловых и механических параметров изделия.

Помимо схемотехнического проектирования второй раздел включает в себя и конструкторское проектирование. На основе технических требований разработаны 3D-модели и чертежи корпуса, состоящего из двух частей: основания и крышки. В итоге проведенной работы создан сборочный чертеж изделия в сборе.

Следующим этапом работы был технологический раздел. На начальном этапе были проведены анализы конструкторской документации и сборочного состава. На их основе с целью упрощения создания технологического процесса сборки электронные компоненты разделены на несколько групп. После этого проведен расчет коэффициента технологичности изделия, признанный удовлетворительным для серийного производства.

Разработаны две схемы сборки, в которых описан этот процесс для электронного модуля и всего изделия в корпус. Рассчитаны штучное время и такт выпуска. Проведена работа по разработке маршрутно-технологического процесса сборки изделия, включающего подробное описание каждой операции и перехода, совершаемых при сборке изделия на серийном производстве. Заключением раздела стала разработка 3D-моделей этапов сборки деталей в готовое изделие.

В заключительном разделе работы проведено экспериментальное исследование готового изделия. Разработана схема измерительного стенда для изделия. Описан порядок действий программы эксперимента. Далее было проведено сравнение временных диаграмм выходного сигнала при компьютерном моделировании и эксперименте. Заключающим шагом стал анализ спектрограмм этих сигналов.

На основе выполненных работ можно сделать вывод, что разработанное изделие «Гитарный эффект «Бит Крашер» полностью соответствует требованиям технического задания и может быть запущено в серийное производство.

# СПИСОК ИСПОЛЬЗОВАННЫХ ИСТОЧНИКОВ

1. Магазин гитарных эффектов. Sonicake Wave Crush. Электронный ресурс. Адрес доступа: https://dmtrpedals.ru/product/sonicake-wave-crush/. Дата обращения 27.04.2026
2. Магазин гитарных эффектов. EHX Mainframe Bit Crusher. Электронный ресурс. Адрес доступа: https://dmtrpedals.ru/product/ehx-mainframe-bit-crusher/. Дата обращения 27.04.2026
3. Альтшуллер, Г. С. Алгоритм изобретения / Г. С. Альтшуллер ; предисл. Л. И. Гинзбурга. — 2-е изд. — Петрозаводск : Северный Олимп, 2004. — 400 с. — ISBN 5-98602-013-5.
4. ГОСТ 2.701-84 «Единая система конструкторской документации (ЕСКД). Схемы. Виды и типы. Общие требования к выполнению»
5. САПР КОМПАС-3D v23. Электронный ресурс. Адрес доступа: https://kompas.ru/kompas-3d/v23/. Дата обращения 07.02.2026.
6. ГОСТ 2.702-2011 «Единая система конструкторской документации. Правила выполнения электрических схем»
7. ГОСТ 28213-89 «Основные методы испытаний на воздействие внешних факторов. Часть 2. Испытания. Испытание Еа и руководство: Одиночный удар»
8. ГОСТ Р 53429-2009 «Платы печатные. Основные параметры конструкции»
9. Simcenter FLOEFD для САПРа Solid Edge. Электронный ресурс. Адрес доступа: https://solidedge.siemens.com/en/solutions/products/simulation/solid-edge-flow-simulation/. Дата обращения 05.05.2026
10. ГОСТ 16019-2001 «Аппаратура сухопутной подвижной радиосвязи. Требования по стойкости к воздействию механических и климатических факторов и методы испытаний»
11. ГОСТ 33366.1-2015 «Пластмассы. Условные обозначения и сокращения. Часть 1. Основные полимеры и их специальные характеристики»
12. ГОСТ 23592-96 «Монтаж электрический радиоэлектронной аппаратуры и приборов. Общие требования к объемному монтажу изделий электронной техники и электротехнических»
13. ГОСТ 24715-81 «Соединения паяные. Методы контроля качества»
14. ГОСТ 14.205-83 «Технологичность конструкции изделий. Термины и определения»
15. Введение в технологию коммутационных структур электронных средств: учебное пособие / [В. Н. Гриднев и др.]. — Москва: Издательство МГТУ им. Н. Э. Баумана, 2024. — 511, [1] с.: ил. (Библиотека «Приборостроение». Т. 9). ISBN 978-5-7038-6098-4. ISBN 978-5-7038-6323-7 (т. 9)
16. PSpice A/D. Электронный ресурс. Адрес доступа: https://www.cadence.com/en_US/home/tools/pcb-design-and-analysis/analog-mixed-signal-simulation/. Дата обращения 01.03.2026

# ПРИЛОЖЕНИЕ А

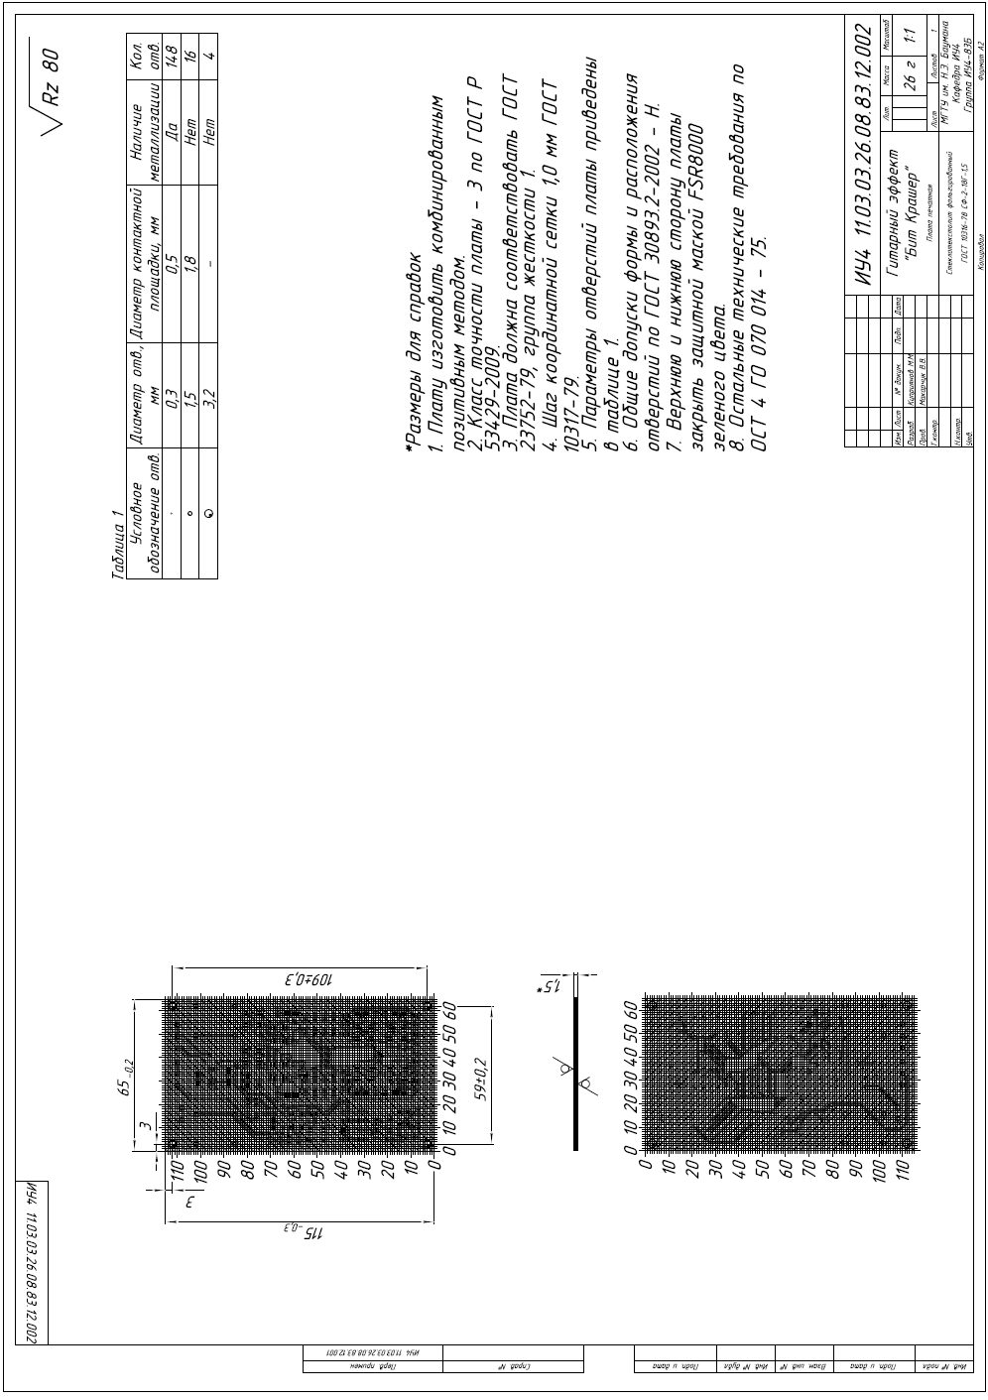
[picture p85: figure]
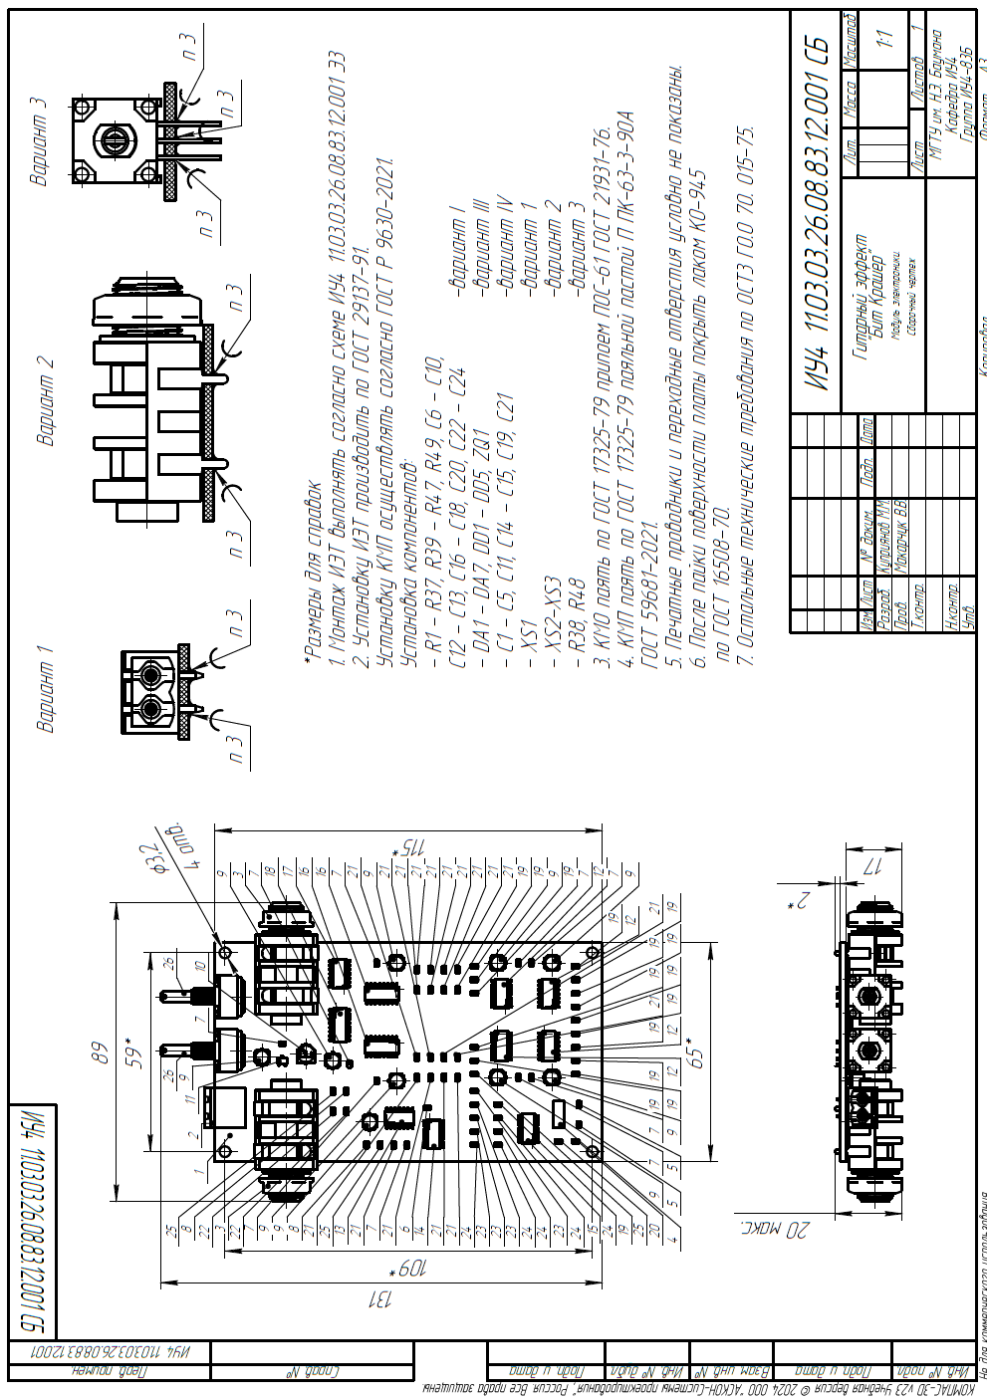
[picture p86: figure]
