mkupriyanov05/Diploma_Baka/Practicum_Kupriyanov_Blanki.docx

| Министерство науки и высшего образования Российской Федерации Федеральное государственное автономное образовательное учреждение высшего образования «Московский государственный технический университет имени Н.Э. Баумана (национальный исследовательский университет)» (МГТУ им. Н.Э. Баумана)

ФАКУЛЬТЕТ | Информатика и системы управления
КАФЕДРА | Проектирование и технологии производства ЭА

ОТЧЕТ

ПО КОНСТРУКТОРСКО-ТЕХНОЛОГИЧЕСКОМУ ПРАКТИКУМУ

НА ТЕМУ:

Гитарный эффект «Бит Крашер» на основе 4-разрядного АЦП

Студент | ИУ4-73Б | | | | Куприянов М.М.
| (группа) | | (подпись, дата) | | (И.О. Фамилия)
Руководитель практикума | | | | | Курносенко А.Е.
| | | (подпись, дата) | | (И.О. Фамилия)

2025 г.

Министерство науки и высшего образования Российской Федерации

Федеральное государственное автономное образовательное учреждение

высшего образования

«Московский государственный технический университет имени Н.Э. Баумана

(национальный исследовательский университет)»

(МГТУ им. Н.Э. Баумана)

Утверждаю
Заведующий кафедрой
| | | (индекс)
| | (И.О. Фамилия)
(подпись)
| | (дата)

ЗАДАНИЕ

на конструкторско-технологический практикум

Студент группы | | ИУ4-73Б Куприянов Михаил Михайлович
| | (Фамилия, имя, отчество)
Тема: | | | Гитарный эффект «Бит Крашер» на основе 4-разрядного АЦП

Направленность практикума (учебная, исследовательская, практическая, производственная, др.)

учебная
Источник тематики (кафедра, предприятие, НИР) | | | | кафедра
Задание

1. Дать описание назначения и принципа работы устройства согласно теме практикума.
2. Разработать электрическую структурную схему устройства.
3. Разработать электрическую принципиальную схему устройства.
4. Дать подробное описание функционирования устройства в соответствии с разработанной электрической принципиальной схемой.
5. Выполнить топологическое проектирование печатной платы электронного модуля (модулей) в составе устройства, привести в отчете эскиз рабочего варианта топологии.

Оформление отчета по практикуму:

Отчет на_____ листах формата А4. Отчет содержит:

1. Введение
2. Описание структурной схемы устройства
3. Описание принципиальной схемы устройства
4. Описание топологии печатной платы электронного модуля
5. Заключение, выводы по проделанной работе
6. Список использованных источников
7. Приложения: электрическая структурная схема, электрическая принципиальная схема, рабочий вариант топологии печатной платы электронного модуля

Дата выдачи задания « ___ » ____________ 20__ г.

Руководитель практикума | | | | Курносенко А.Е.
| | (подпись, дата) | | (И.О. Фамилия)
Студент | | | | Куприянов М.М.
| | (подпись, дата) | | (И.О. Фамилия)

Примечание: Задание оформляется в двух экземплярах: один выдается студенту, второй хранится на кафедре.

Министерство науки и высшего образования Российской Федерации

Федеральное государственное автономное образовательное учреждение

высшего образования

«Московский государственный технический университет имени Н.Э. Баумана

(национальный исследовательский университет)»

(МГТУ им. Н.Э. Баумана)

КАЛЕНДАРНЫЙ ПЛАН

на конструкторско-технологический практикум

Студент группы | ИУ4-73Б Куприянов Михаил Михайлович
| (Фамилия, имя, отчество)
Тема практикума: | | Гитарный эффект «Бит Крашер» на основе 4-разрядного АЦП

№ п/п | Наименование этапов выпускной квалификационной работы | Сроки выполнения этапов | | Отметка о выполнении
| | план | факт | Руководитель практикума | Куратор
| Задание на выполнение конструкторско-технологического практикума | 08.09.2025
| Схемотехническое проектирование | 29.09.2025 Планируемая дата
| Топологическое проектирование | 27.10.2025 Планируемая дата
| Оформление отчета | 24.11.2025 Планируемая дата
| Защита практикума | 29.12.2025 Планируемая дата

Студент __________________________ Руководитель проекта _________________________

(подпись, дата) (подпись, дата)
