mkupriyanov05/Diploma_Baka/Spec_Full_Kupriyanov_Diploma.pdf

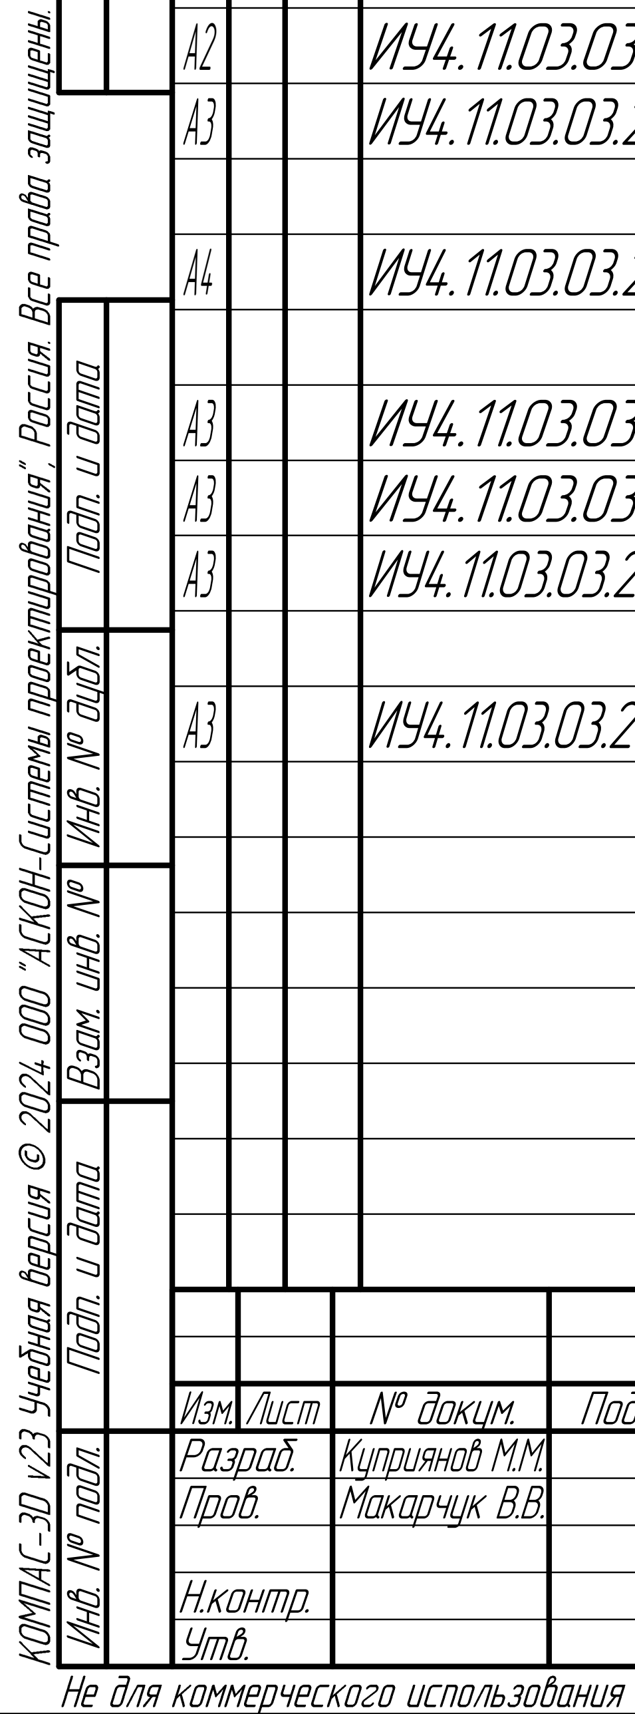
[picture p103: figure]
Н.контр. Утв.

| | № докум. | Подп. | Дата | ИУ4.11.03.03.26.08.83.12.005 СП Изм. Лист
| | Разраб. | Куприянов М.М. | | | Гитарный эффект "Бит Крашер" Спецификация | Лит. | Лист | Листов
Пров. | Макарчук В.В. | | | | | | | 1 2
МГТУ им. Н.Э. Баумана Кафедра ИУ4 Инв. № подл. Подп. и дата Взам. инв. № Инв. № дубл. Подп. и дата | Группа ИУ4-83Б Справ. № Перв. примен. | Документация
А3 | | ИУ4.11.03.03.26.08.83.12.005 Сборочный чертеж
| | | устройства
А3 | | ИУ4.11.03.03.26.08.83.12.001 Э1 Схема электрическая
| Поз. | Обозначение | устройства Формат Зона Наименование структурная | Кол. | Приме-
А3 | | ИУ4.11.03.03.26.08.83.12.001 Э2 Схема электрическая
| | | функциональная
А2 | | ИУ4.11.03.03.26.08.83.12.001 Э3 Схема электрическая
| | | принципиальная
А4 | | ИУ4.11.03.03.26.08.83.12.001 ПЭ3 Перечень элементов
А2 | | ИУ4.11.03.03.26.08.83.12.002 Плата печатная
А3 | | ИУ4.11.03.03.26.08.83.12.001 СБ Сборочный чертеж
| | | электронного модуля
А4 | | ИУ4.11.03.03.26.08.83.12.001 СП Спецификация
| | | электронного модуля
А3 | | ИУ4.11.03.03.26.08.83.12.003 Основание корпуса
А3 | | ИУ4.11.03.03.26.08.83.12.004 Крышка корпуса
А3 | | ИУ4.11.03.03.26.08.83.12.001 СХ1 Схема сборки
| | | электронного модуля
А3 | | ИУ4.11.03.03.26.08.83.12.001 СХ2 Схема сборки

чание

Копировал | Формат A4

## ИУ4.11.03.03.26.08.83.12.005 СП Лист

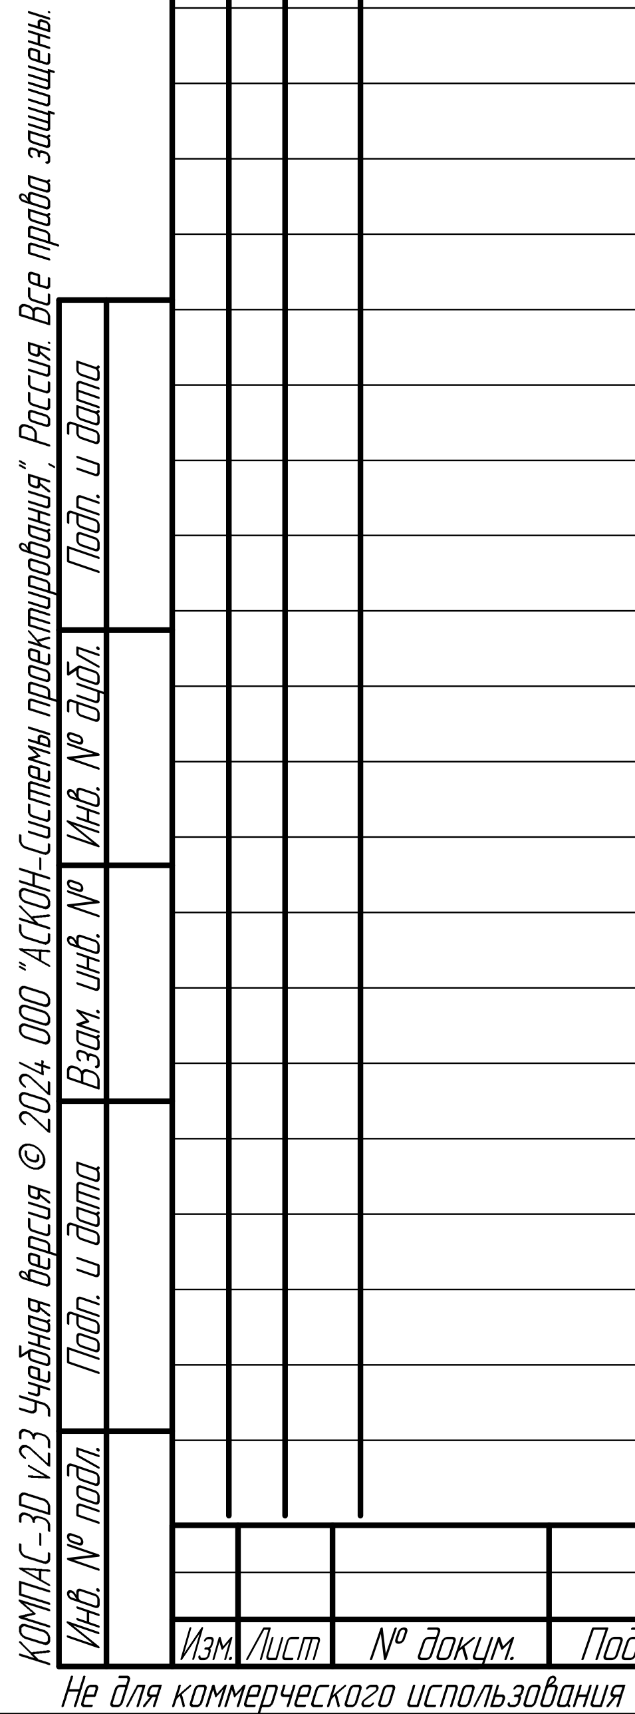
[picture p104: figure]

2 Инв. № подл. Подп. и дата Взам. инв. № Инв. № дубл. Подп. и дата | Изм. Лист | № докум. | Подп. | Дата
| | Детали
Поз. | Обозначение | ГОСТ 50403-92 Формат Зона Наименование | Кол. | Приме-
1 | Модуль электроники | 1
2 | Основание корпуса | 1
3 | Крышка корпуса | 1
4 | Гайка М3-6H | 4
| ГОСТ 5915-70
5 | Винт М3x6.46.026 | 4
| ГОСТ 50403-92
6 | Винт М3x10.01.016 | 4

чание

Копировал | Формат A4
