mkupriyanov05/Diploma_Baka/Spec_RUS_ModuleOnly_Kupriyanov_Diploma.pdf

| | № докум. | Подп. | Дата | ИУ4 11.03.03.26.08.83.12.001 СП Изм. Лист
| | Разраб. | Куприянов М.М. | | | Гитарный эффект "Бит Крашер" Спецификация электронного модуля | Лит. | Лист | Листов
Пров. | Макарчук В.В. | | | | | | | 1 3

Н.контр.
Утв.
МГТУ им. Н.Э. Баумана Кафедра ИУ4 Инв. № подл. Подп. и дата Взам. инв. № Инв. № дубл. Подп. и дата | Группа ИУ4-83Б Справ. № Перв. примен. | Документация
А3 | | ИУ4 11.03.03.26.08.83.12.001 СБ Сборочный чертеж
| | | электронного модуля
А3 | | ИУ4 11.03.03.26.08.83.12.001 Э1 Схема электрическая
| | | структурная
А3 | | ИУ4 11.03.03.26.08.83.12.001 Э2 Схема электрическая
| Поз. | Обозначение | ф. "Rean" (Китай) Формат Зона Наименование функциональная | Кол. | Приме-
А2 | | ИУ4 11.03.03.26.08.83.12.001 Э3 Схема электрическая
| | | принципиальная
А4 | | ИУ4 11.03.03.26.08.83.12.001 | Перечень элементов
А2 | | ИУ4 11.03.03.26.08.83.12.002 | Плата печатная

Детали

1 ИУ4 11.03.03.26.08.83.12.002 | Плата печатная | 1

Прочие изделия

2 | Разъем WR-TBL, 2,5 мм, | 1 | XS1
| ф. "Wurth Elektronik" (Германия)
3 | Разъем NYS-2152, 6,35 мм, | 2 | XS2-XS3

чание

Копировал | Формат A4

## ИУ4 11.03.03.26.08.83.12.001 СП Лист

4 | Кварцевый резонатор DMX-26S, | 1 | ZQ1
| 100 кГц, SMD08038P4,
| ф. "KDS" (Япония)
| | Конденсаторы
| | К10-83 АДПК.673511.022 ТУ
5 | | 20,0 пФ 50 В ±20%, 0805 | 2 С12-С13
Поз. 6 | Обозначение | (Нидерланды) Формат Зона Наименование 4,7 нФ 16 В ±20%, 0805 | Кол. 1 | Приме-С23
7 | | 100,0 нФ 16 В ±20%, 0805 | 9 C6-C10,
| | | | С16-С17,
| | | | С20, С22
8 | | 1,0 мкФ 16 В ±20%, 0805 | 2 С18, С24
| | К50-97 ЕВАЯ.673541.054 ТУ
9 | | 1,0 мкФ 50 В ±20% | 9 C1-C4,
| | | | C11, C14-
| | | | C15, C19,
| | | | C21
10 | | 10,0 мкФ 16 В ±20% | 1 | С5
| | | Микросхемы аналоговые
| 11 | | 78L05, ф. "CJ Electronics" (США) | 1 | DA1
Изм. Лист | 12 | № докум. Подп. Дата | LM339, ф. "Texas Instruments" | 4 | 2 Инв. № подл. Подп. и дата Взам. инв. № Инв. № дубл. Подп. и дата DA2-DA5
| | | (США)
| 13 | | MCP6004, ф. "Microchip" (США) | 1 | DA6
| 14 | | 74HC4066, ф. "Nexperia" | 1 | DA7

## ИУ4 11.03.03.26.08.83.12.001 СП Лист

| | Микросхемы цифровые
15 | | 74HC14, ф. "STMicroelectronics" | 1 | DD1
| | (Швейцария)
16 | | 74HC148, | 2 | DD2-DD3
| | ф. "Texas Instruments" (США)
17 | | 74HC02D, ф. "Nexperia" | 1 | DD4
26 Поз. | Обозначение | 10,0 кОм ±10% 1 Вт Наименование (Нидерланды) | 2 Кол. | R38, R48 Формат Зона Приме-
18 | | 74HC75D, ф. "Nexperia" | 1 | DD5
| | (Нидерланды)
| | | Резисторы
| | | Р1-12 ОЖ0.467.169 ТУ
| 19 316 Ом ±0,5% 0,125 Вт, 0805 15 R1-R15
| 20 | | 1,0 кОм ±5% 0,125 Вт, 0805 | 1 | R33
| 21 5,1 кОм ±5% 0,125 Вт, 0805 17 R16-R31,
| | | | | R37
| 22 | | 10,0 кОм ±0,5% 0,125 Вт, 0805 | 2 R34-R35
| 23 | | 10,0 кОм ±5% 0,125 Вт, 0805 | 4 | R43-R46
| 24 | | 20,0 кОм ±0,5% 0,125 Вт, 0805 | 5 | R39-R42,
| | | | | R47
| 25 | | 1,0 МОм ±5% 0,125 Вт, 0805 | 3 | R32, R36,
| | | | | R49
Изм. Лист | | № докум. Подп. Дата | ППБ-1А ОЖ0.468.555 ТУ | | 3 Инв. № подл. Подп. и дата Взам. инв. № Инв. № дубл. Подп. и дата
