mkupriyanov05/Diploma_Baka/Spec_ModuleOnly_Kupriyanov_Diploma.pdf

| | № докум. | Подп. | Дата | ИУ4 11.03.03.26.08.83.12.001 СП Изм. Лист
| | Разраб. | Куприянов М.М. | | | Гитарный эффект "Бит Крашер" Спецификация электронного модуля | Лит. | Лист | Листов
Пров. | Макарчук В.В. | | | | | | | 1 3

Н.контр.
Утв.
МГТУ им. Н.Э. Баумана Кафедра ИУ4 Инв. № подл. Подп. и дата Взам. инв. № Инв. № дубл. Подп. и дата | Группа ИУ4-83Б Справ. № Перв. примен. | Документация
А3 | | ИУ4 11.03.03.26.08.83.12.001 СБ Сборочный чертеж
| | | электронного модуля
А2 | | ИУ4 11.03.03.26.08.83.12.001 Э3 Схема электрическая
| | | принципиальная
А4 | | ИУ4 11.03.03.26.08.83.12.001 | Перечень элементов
А2 | 5 Поз. | Обозначение ИУ4 11.03.03.26.08.83.12.002 | RT0805BRD07316RL, 0805, 15 R1-R15 Формат Зона Наименование Плата печатная | Кол. | Приме-

Детали

1 ИУ4 11.03.03.26.08.83.12.002 | Плата печатная | 1

Прочие изделия

2 | Разъем WR-TBL, 2,5 мм, | 1 | XS1
| Wurth Elektronik, Германия
3 | Разъем NYS-2152, 6,35 мм, | 2 | XS2-XS3
| Rean, Китай
4 | Кварцевый резонатор 100 кГц, 1 | | ZQ1
| SMD08038P4

Резисторы

чание

Копировал | Формат A4

## ИУ4 11.03.03.26.08.83.12.001 СП Лист

| 316 Ом, ±0,1%, Yageo, Тайвань
6 | RC0805JR-071KL, 0805, 1 кОм, 1 | | R33
| ±5%, Yageo, Тайвань
7 RC0805JR-075K1L, 0805, 5.1 кОм, 19 R16-R31,
| ±5%, Yageo, Тайвань | | R37
8 | 16K1-10C10K, 10 кОм, | 2 | R38, R48
| Song Huei Electronic, Тайвань
9 RT0805BRD0710KL, 0805, 10 кОм, 2 R34-R35
| ±0,1%, Yageo, Тайвань
10 | RC0805JR-0710KL, 0805, 10 кОм, 4 | | R43-R46
| ±5%, Yageo, Тайвань
11 | RT0805BRD0720KL, 0805, 20 кОм, 5 | | R39-R42,
| ±0,1%, Yageo, Тайвань | | R47
12 | RC0805JR-071ML, 0805, 1 МОм, 3 | | R32, R36,
| ±5%, Yageo, Тайвань | | R49
| | | Конденсаторы керамические
| 13 | | GRM2165C1H200J, 0805, | 2 С12-С13
| | | 20 пФ, Murata, Япония
| 14 | | GRM21AR72С472KW01D, 0805, 1 | | С23
| | | 4.7 нФ, Murata, Япония
| 15 GCM21BR72С104KA37L, 0805, 9 C6-C9,
Изм. Лист | | № докум. Подп. Дата | 100 нФ, Murata, Япония | | 2 Инв. № подл. Подп. и дата Взам. инв. № Инв. № дубл. Подп. и дата C10, С16-
| | | | | С17, С20,
| | | | | С22
| 16 GRM21BR71C105KA01L, 0805, 2 С18, С24
| | | 1 мкФ, Murata, Япония
| Конденсаторы электролитические
17 | JCK1C100M040054, 10 мкФ, 1 | С5
| JB Capacitors, Гонконг
18 | JCK1H010M040054, 1 мкФ, 9 C1-C4, Формат Зона | Поз. | Обозначение | Наименование | Кол. | Приме-

## ИУ4 11.03.03.26.08.83.12.001 СП Лист

JB Capacitors, Гонконг | C11, C14-
| C15, C19,
| C21
| | Микросхемы аналоговые
19 | | Стабилизатор напряжения, 78L05, 1 | | DA1
Поз. | Обозначение | Nexperia, Нидерланды Формат Зона Наименование CJ Electronics, США | Кол. | Приме-
20 | | Компаратор, LM339, | 4 | DA2-DA5
| | Texas Instruments, США
21 | | Операционный усилитель, MCP6004, 1 | | DA6
| | Microchip, США
22 | | Переключатель двунаправленный, 1 | | DA7
| | 74HC4066, Nexperia, Нидерланды
| | | Микросхемы цифровые
| 23 | | Инвертер Шмитта, M74HC14, 1 | DD1
| | | STMicroelectronics, Швейцария
| 24 | | Шифратор 8х3, SN74HC148, 2 | DD2-DD3
| | | Texas Instruments, США
| 25 | | Логический элемент 2ИЛИ-НЕ, 1 | DD4
| | | 74HC02D, Nexperia, Нидерланды
| 26 | | Защелка бистабильная, 74HC75D, 1 | DD5
Изм. Лист | | № докум. Подп. Дата | | 3 Инв. № подл. Подп. и дата Взам. инв. № Инв. № дубл. Подп. и дата
