mkupriyanov05/Diploma_Baka/PE_RUS_Kupriyanov_Diploma.pdf

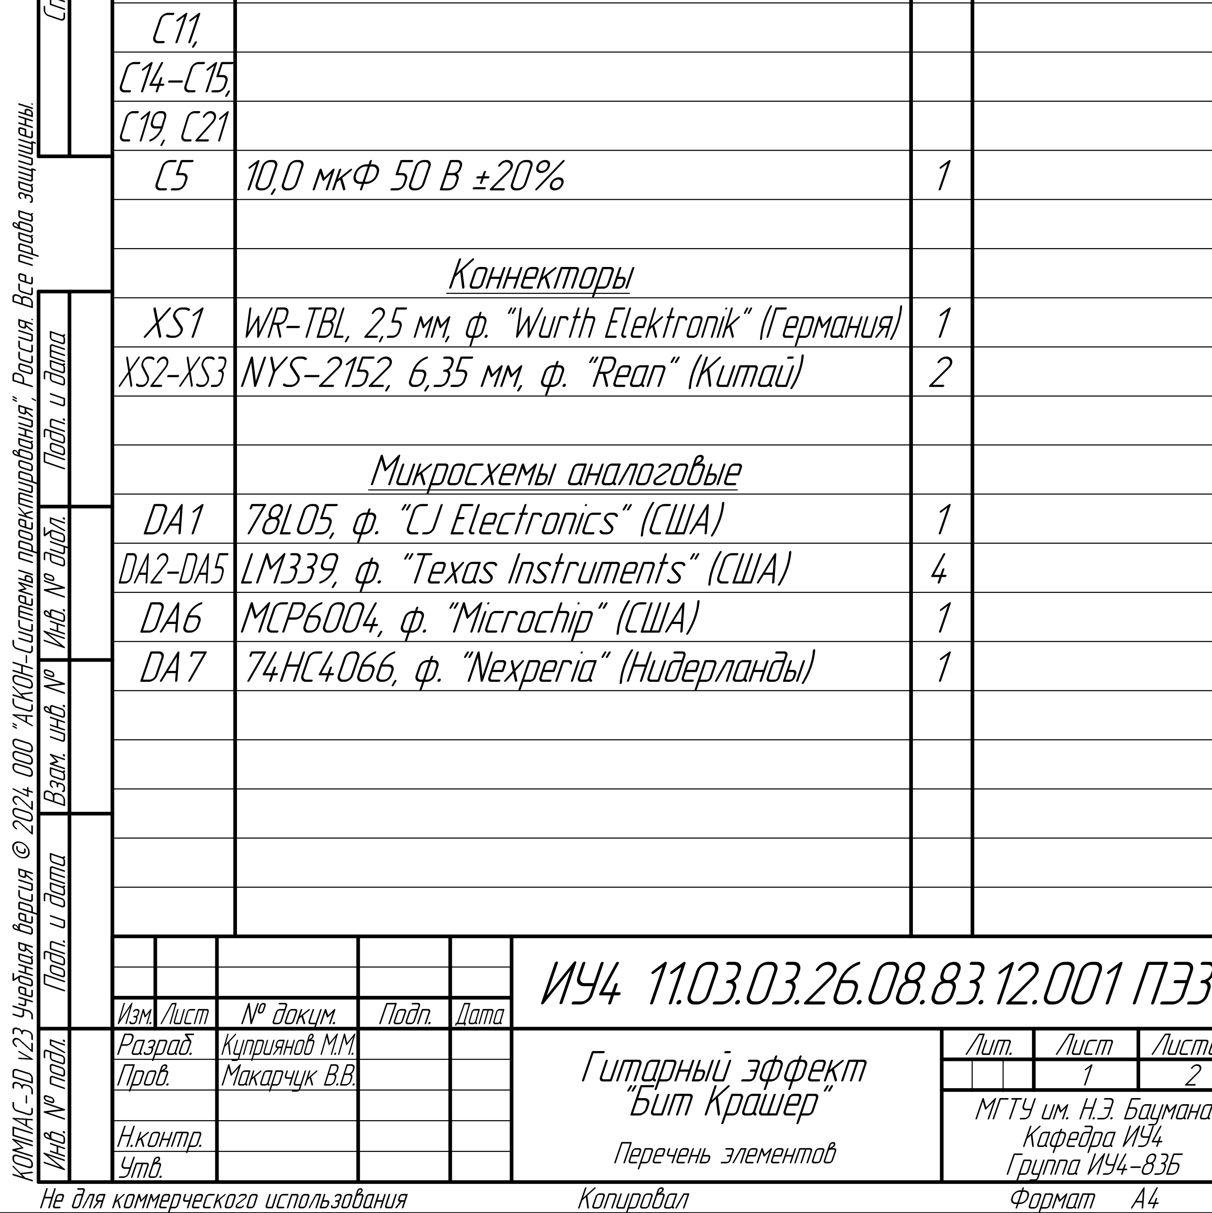
[picture p105: figure]
Пров.; Макарчук В.В.; Н.контр. Утв.; 10,0 мкФ 50 В ±20%; Коннекторы; Микросхемы аналоговые; 78L05, ф. "CJ Electronics" (США); MCP6004, ф. "Microchip" (США); 74HC4066, ф. "Nexperia" (Нидерланды); Копировал; Формат A4

| | № докум. | Подп. | Дата | ИУ4 11.03.03.26.08.83.12.001 ПЭ3 Изм. Лист
| | Разраб. | Куприянов М.М. | | | Гитарный эффект "Бит Крашер" Перечень элементов | Лит. | Лист | Листов
МГТУ им. Н.Э. Баумана Кафедра ИУ4 Инв. № подл. Подп. и дата Взам. инв. № Инв. № дубл. Подп. и дата | Группа ИУ4-83Б Справ. № Перв. примен. ИУ4 ¹¹.03.03.26.08.83.12.00¹ | Конденсаторы
| К10-83 АДПК.673511.022 ТУ
C12-C13 20,0 пФ 50 В ±20%, 0805 | | 2
C23 | 4,7 нФ 16 В ±20%, 0805 | 1
C6-C10, 100,0 нФ 16 В ±20%, 0805 | | 9
C16-C17,
C20, C22
C18, C24 1,0 мкФ 16 В ±20%, 0805 | | 2
| К50-97 ЕВАЯ.673541.054 ТУ
C1-C4, 1,0 мкФ 16 В ±20% | | 9
XS1 | WR-TBL, 2,5 мм, ф. "Wurth Elektronik" (Германия) | 1
XS2-XS3 NYS-2152, 6,35 мм, ф. "Rean" (Китай) | | 2
DA2-DA5 LM339, ф. "Texas Instruments" (США) | | 4

Поз.
обозначение
Наименование | Кол. Примечание

| Кварцевые резонаторы
ZQ1 | DMX-26S, 100 кГц, SMD08038P4, ф. "KDS" (Япония) | 1
| Резисторы
| Р1-12 ОЖ0.467.169 ТУ
R1-R15 316 Ом ±0,5% 0,125 Вт, 0805 | | 15

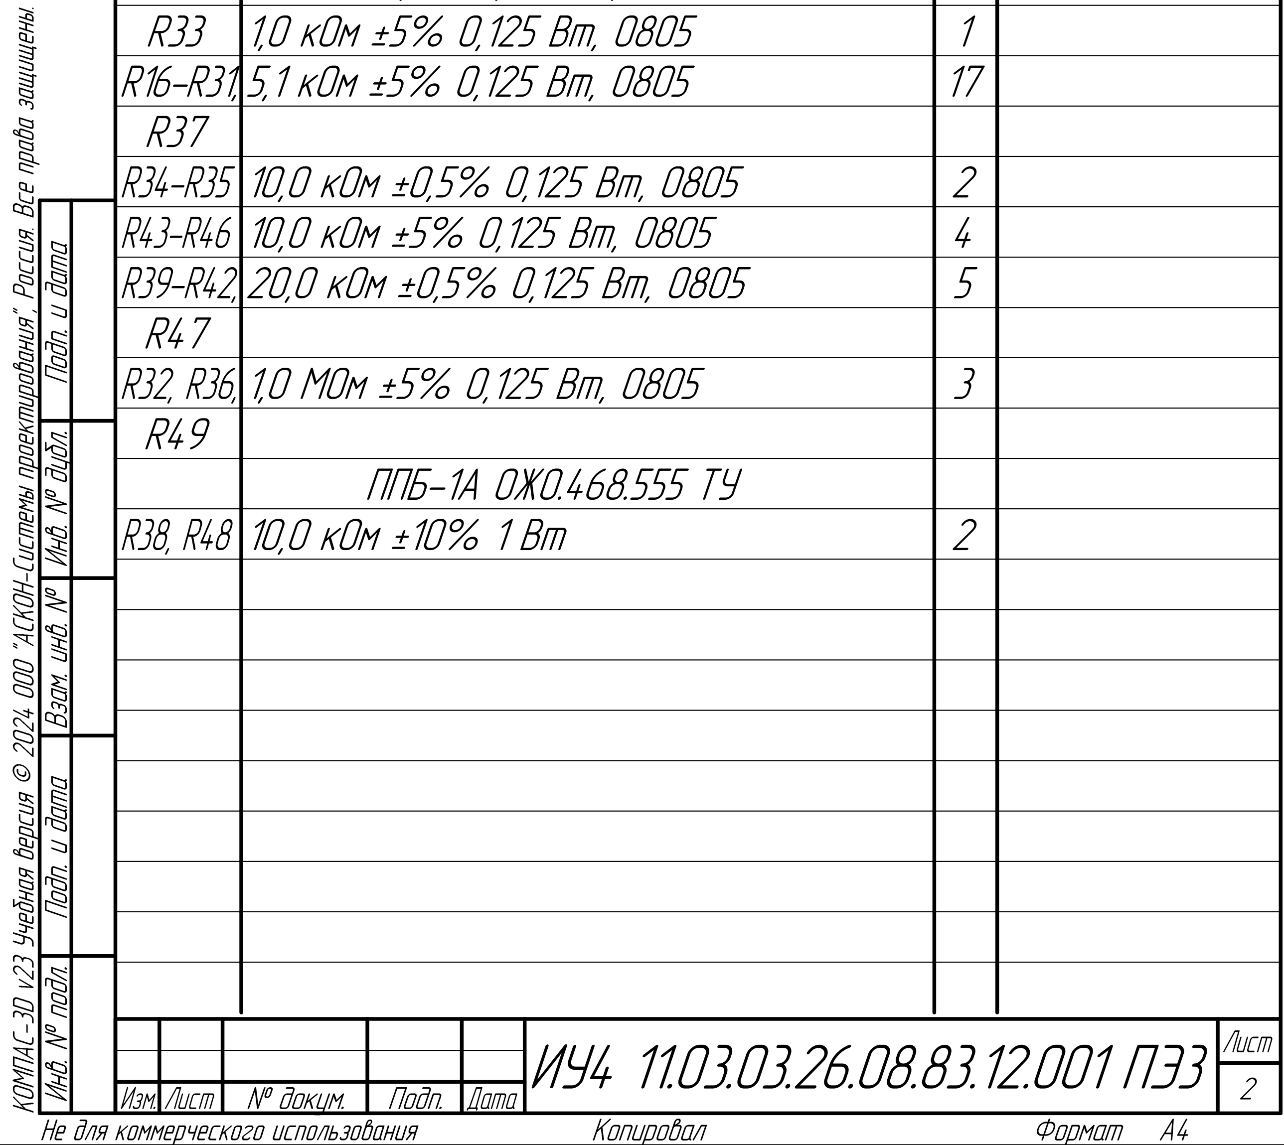
[picture p106: figure]
ИУ4 11.03.03.26.08.83.12.001 ПЭ3 Лист; 1,0 кОм ±5% 0,125 Вт, 0805; R16-R31,5,1 кОм ±5% 0,125 Вт, 0805; R43-R46 10,0 кОм ±5% 0,125 Вт, 0805; R32, R36, 1,0 МОм ±5% 0,125 Вт, 0805; ППБ-1А ОЖ0.468.555 ТУ; Копировал; Формат A4

R34-R35 10,0 кОм ±0,5% 0,125 Вт, 0805 | | 2
R39-R42, 20,0 кОм ±0,5% 0,125 Вт, 0805 | | 5
Изм. Лист R38, R48 10,0 кОм ±10% 1 Вт | № докум. Подп. Дата | 2 | 2 Инв. № подл. Подп. и дата Взам. инв. № Инв. № дубл. Подп. и дата
Поз. обозна-чение | Наименование | Кол. Примечание
| Микросхемы цифровые
DD1 | 74HC14, ф. "STMicroelectronics" (Швейцария) | 1
DD2-DD3 74HC148, ф. "Texas Instruments" (США) | | 2
DD4 | 74HC02D, ф. "Nexperia" (Нидерланды) | 1
DD5 | 74HC75D, ф. "Nexperia" (Нидерланды) | 1
