mkupriyanov05/Diploma_Baka/PE_Kupriyanov_Diploma.pdf

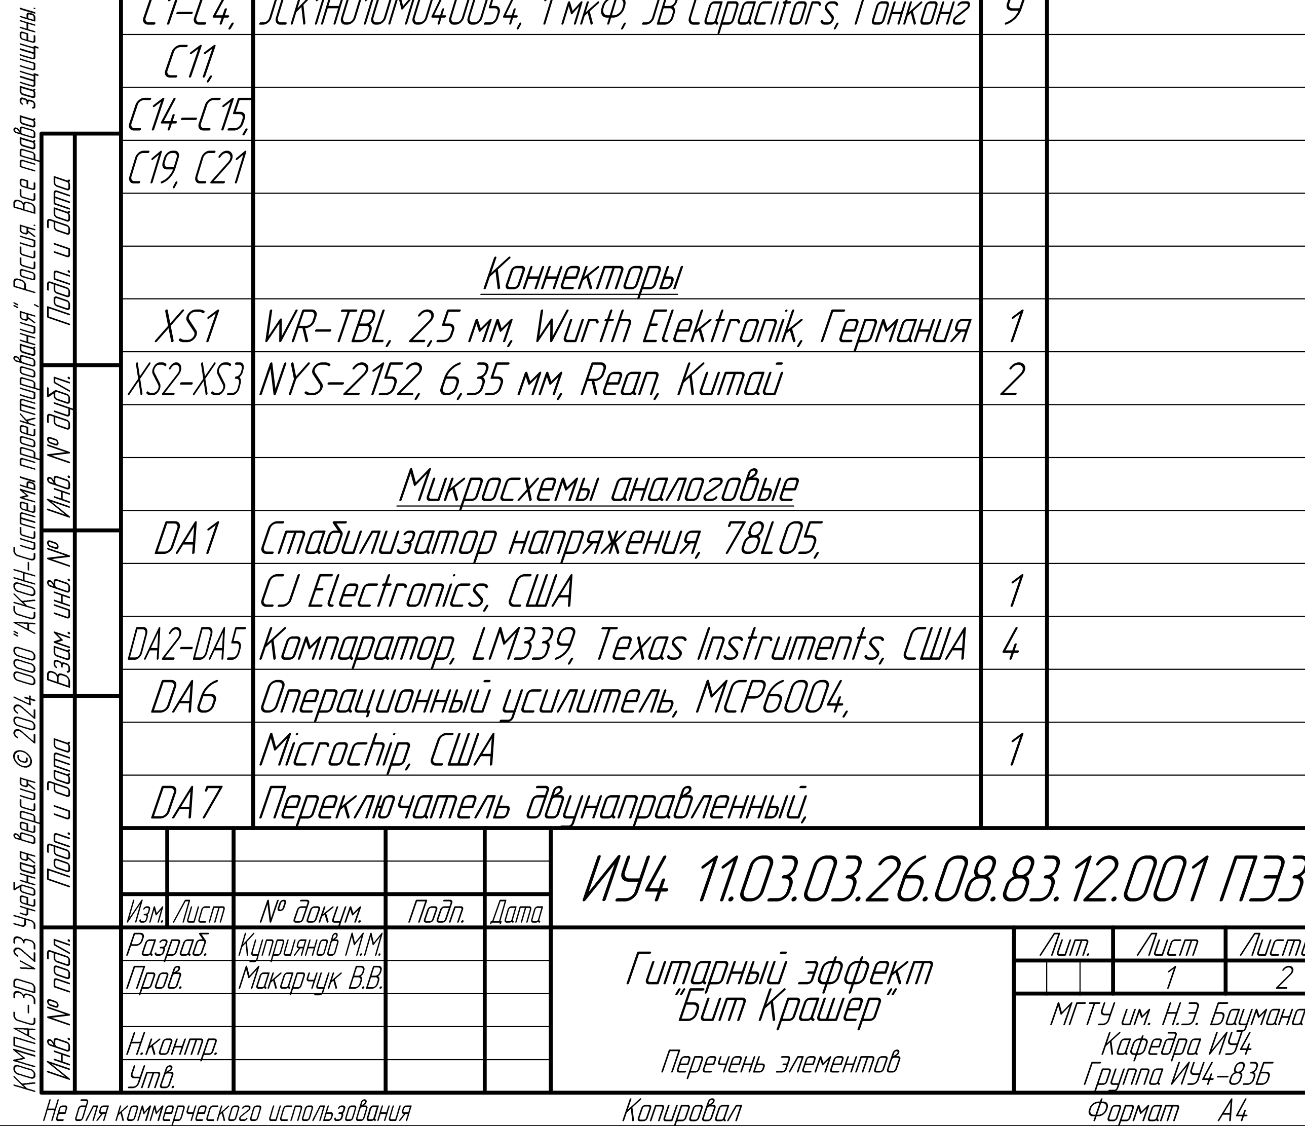
[picture p107: figure]
Пров.; Макарчук В.В.; Н.контр. Утв.; Коннекторы; Микросхемы аналоговые; Стабилизатор напряжения, 78L05,; CJ Electronics, США; Операционный усилитель, MCP6004,; Microchip, США; Переключатель двунаправленный,; Копировал; Формат A4

| | № докум. | Подп. | Дата | ИУ4 11.03.03.26.08.83.12.001 ПЭ3 Изм. Лист
| | Разраб. | Куприянов М.М. | | | Гитарный эффект "Бит Крашер" Перечень элементов | Лит. | Лист | Листов
МГТУ им. Н.Э. Баумана Кафедра ИУ4 Инв. № подл. Подп. и дата Взам. инв. № Инв. № дубл. Подп. и дата | Группа ИУ4-83Б Справ. № Перв. примен. ИУ4 ¹¹.03.03.26.08.83.12.00¹ | Конденсаторы керамические

C12-C13 GRM2165C1H200J, 0805, 20 пФ,
| Murata, Япония | 2
C23 | GRM21AR72С472KW01D, 0805, 4.7 нФ,
| Murata, Япония | 1
C6-C10, GCM21BR72С104KA37L, 0805, 100 нФ,
C16-C17, Murata, Япония | | 9
C20, C22
C18, C24 GRM21BR71C105KA01L, 0805, 1 мкФ,
| Murata, Япония | 2
| Конденсаторы электролитические
C5 | JCK1C100M040054, 10 мкФ, JB Capacitors, Гонконг | 1
C1-C4, JCK1H010M040054, 1 мкФ, JB Capacitors, Гонконг | | 9
XS1 | WR-TBL, 2,5 мм, Wurth Elektronik, Германия | 1
XS2-XS3 NYS-2152, 6,35 мм, Rean, Китай | | 2

DA2-DA5 Компаратор, LM339, Texas Instruments, США 4

Поз.
обозначение
Наименование | Кол. Примечание

| Микросхемы цифровые
DD1 | Инвертер Шмитта, M74HC14,
| STMicroelectronics, Швейцария | 1
DD2-DD3 Шифратор приоритетный 8х3, SN74HC148,
| Texas Instruments, США | 2
DD4 | Логический элемент 2ИЛИ-НЕ,
| 74HC02D, Nexperia, Нидерланды | 1
DD5 | Защелка бистабильная, 74HC75D,
| Nexperia, Нидерланды | 1

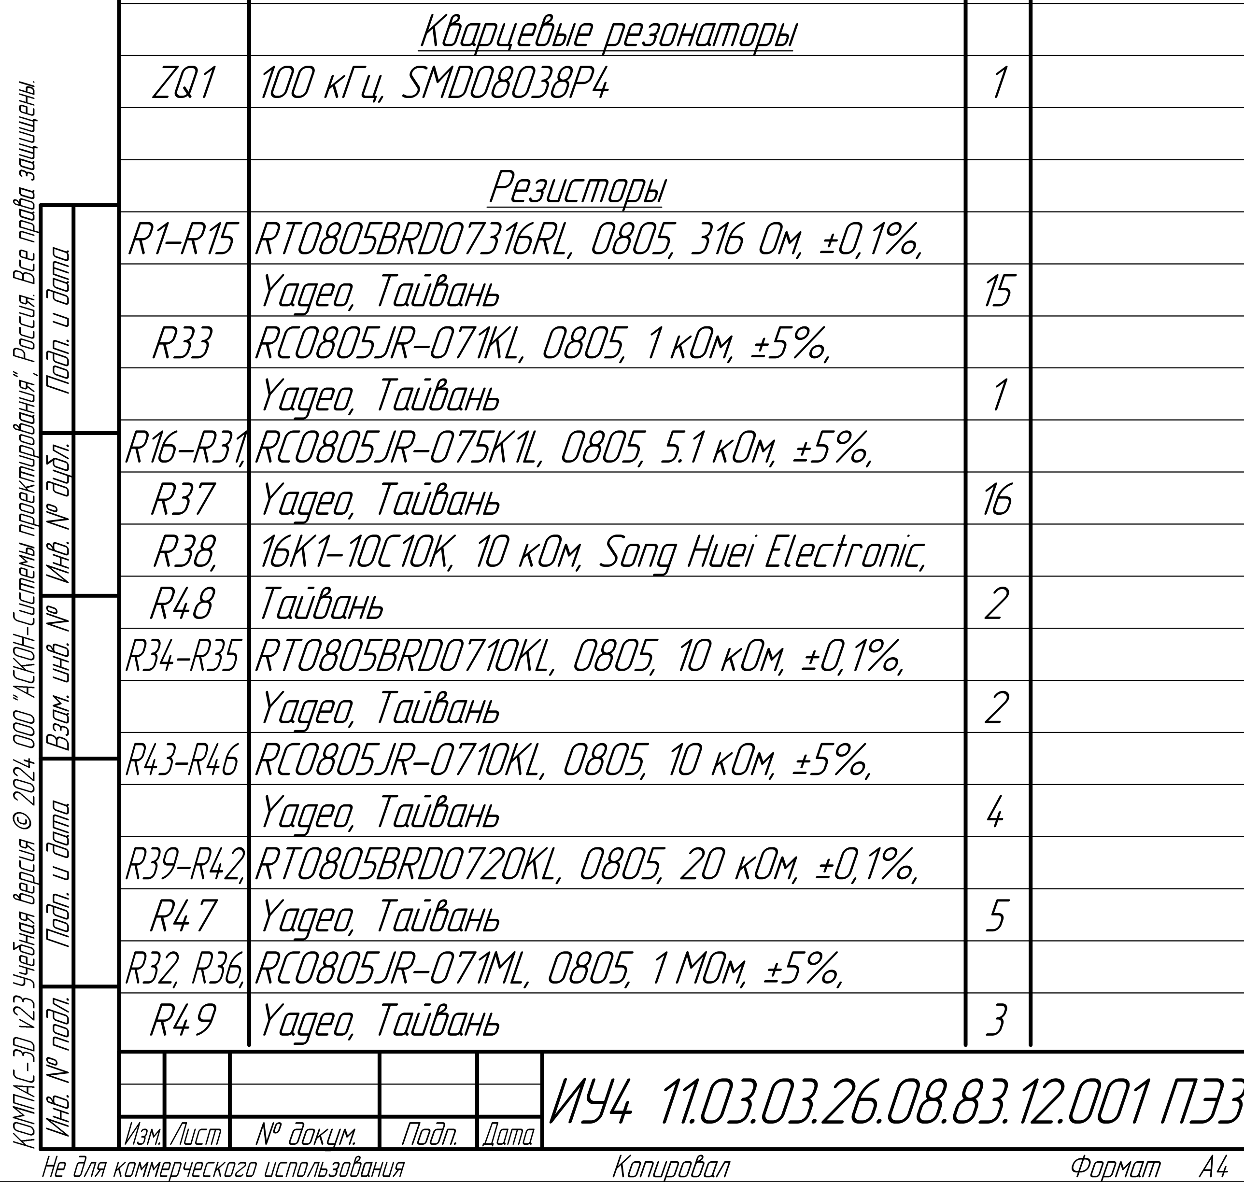
[picture p108: figure]
Кварцевые резонаторы; 100 кГц, SMD08038P4; Резисторы; Yageo, Тайвань; RC0805JR-071KL, 0805, 1 кОм, ±5%,; Тайвань; Копировал; Формат A4

R1-R15 RT0805BRD07316RL, 0805, 316 Ом, ±0,1%,

R16-R31, RC0805JR-075K1L, 0805, 5.1 кОм, ±5%,

Изм. Лист R38, | № докум. Подп. Дата 16K1-10C10K, 10 кОм, Song Huei Electronic, | | 2 Инв. № подл. Подп. и дата Взам. инв. № Инв. № дубл. Подп. и дата

R34-R35 RT0805BRD0710KL, 0805, 10 кОм, ±0,1%,

R43-R46 RC0805JR-0710KL, 0805, 10 кОм, ±5%,

R39-R42, RT0805BRD0720KL, 0805, 20 кОм, ±0,1%,

R32, R36, RC0805JR-071ML, 0805, 1 МОм, ±5%,
| | | | ИУ4 11.03.03.26.08.83.12.001 ПЭ3 Лист
Поз. обозна-чение | Наименование | Кол. Примечание
| 74HC4066, Nexperia, Нидерланды | 1
