mkupriyanov05/Diploma_Baka/AKIP0001.BMP

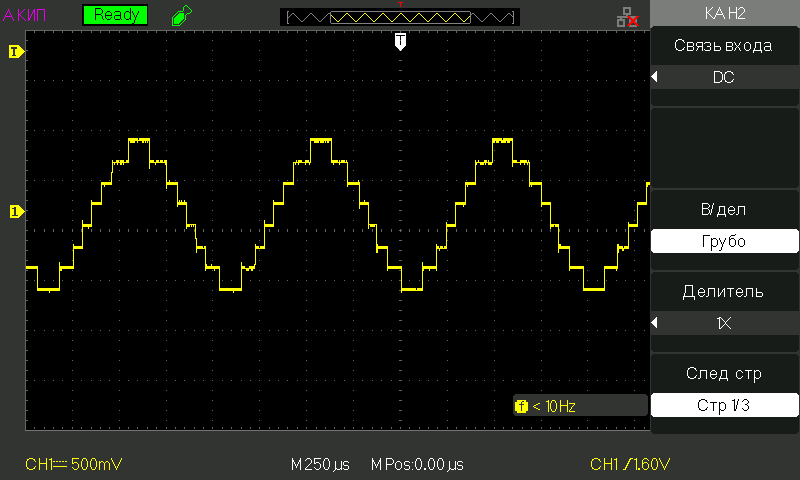
AKIP0001.BMP
