mkupriyanov05/Diploma_Baka/AKIP0002.BMP

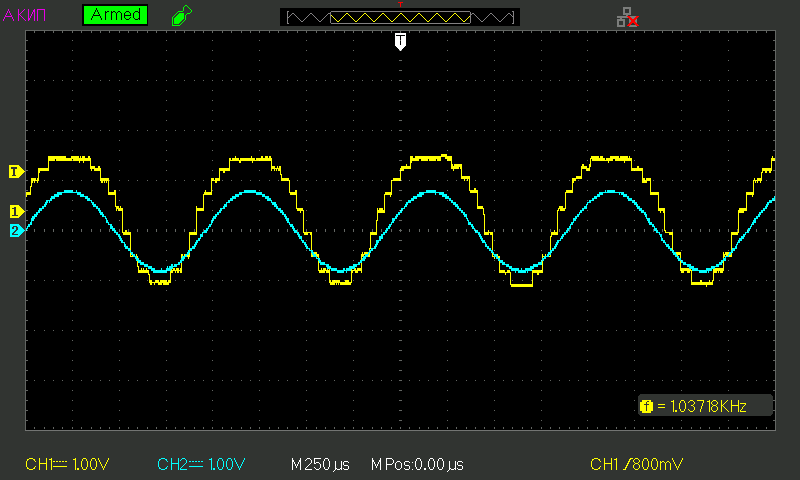
AKIP0002.BMP
