mkupriyanov05/Diploma_Baka/AKIP0004.BMP

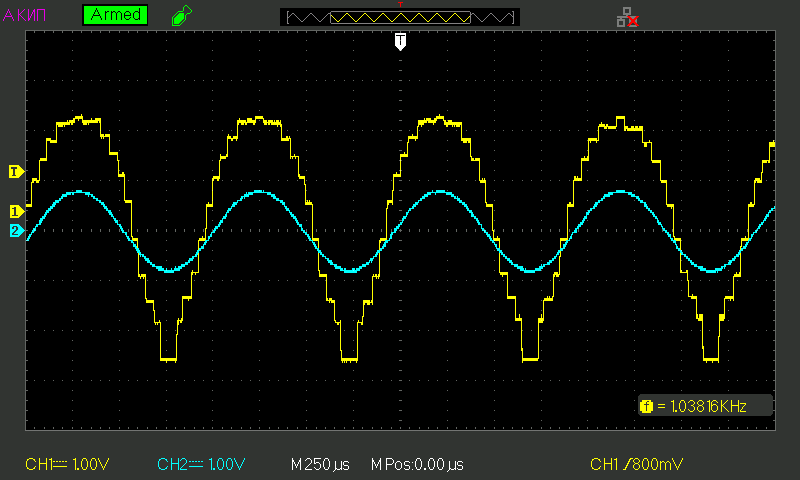
AKIP0004.BMP
