mkupriyanov05/Diploma_Baka/(list of files, cad)

Other CAD files:
E1_Kupriyanov_Diploma.dwg
ADC_Diploma_Topo.dwg
E2_Kupriyanov_Diploma.dwg
