mkupriyanov05/Diploma_Baka/Chertezh_for_sborka_razrezy.pdf

54 12 3

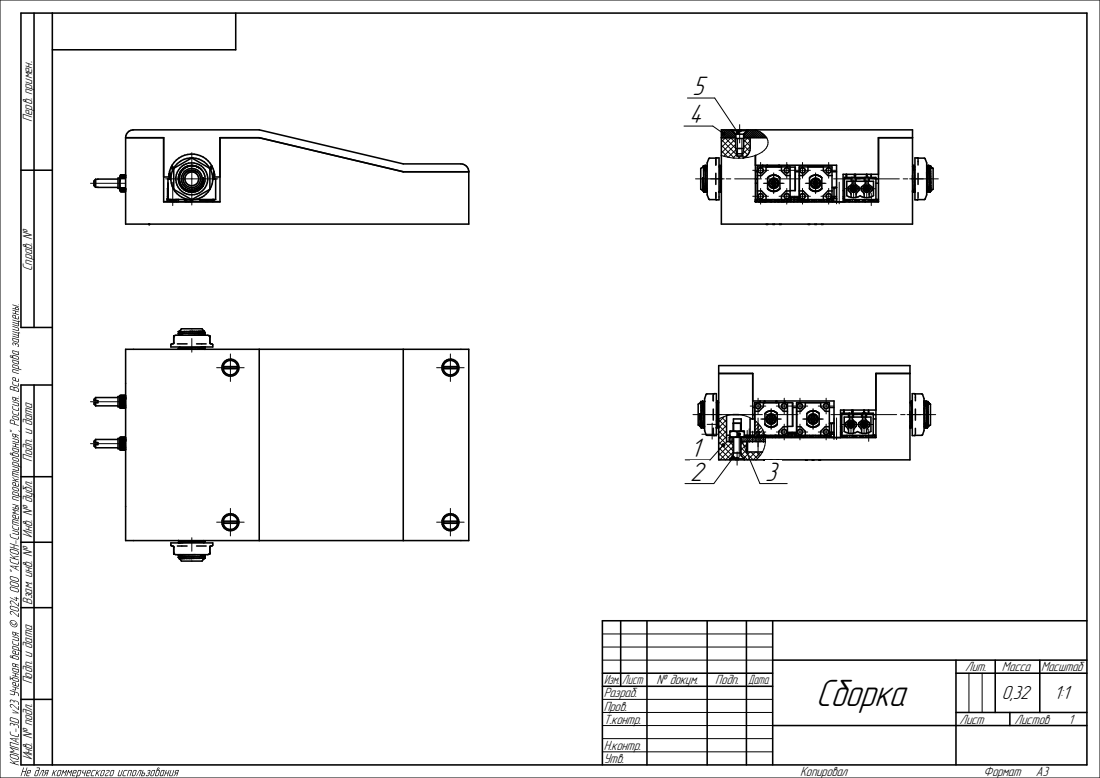
[picture p112: page 1]
Масса Масштаб; Лит.; Т.контр.; Лист; Листов; Сборка; 0,32 Инв. № подл. Подп. и дата Взам. инв. № Инв. № дубл. Подп. и дата Справ. № Перв. примен.; Копировал; Формат A3

Изм. Лист № докум. Подп. Дата
Разраб.
Пров.
Н.контр.
Утв.
