mkupriyanov05/Diploma_Baka/PP_Kupriyanov_Diploma.pdf

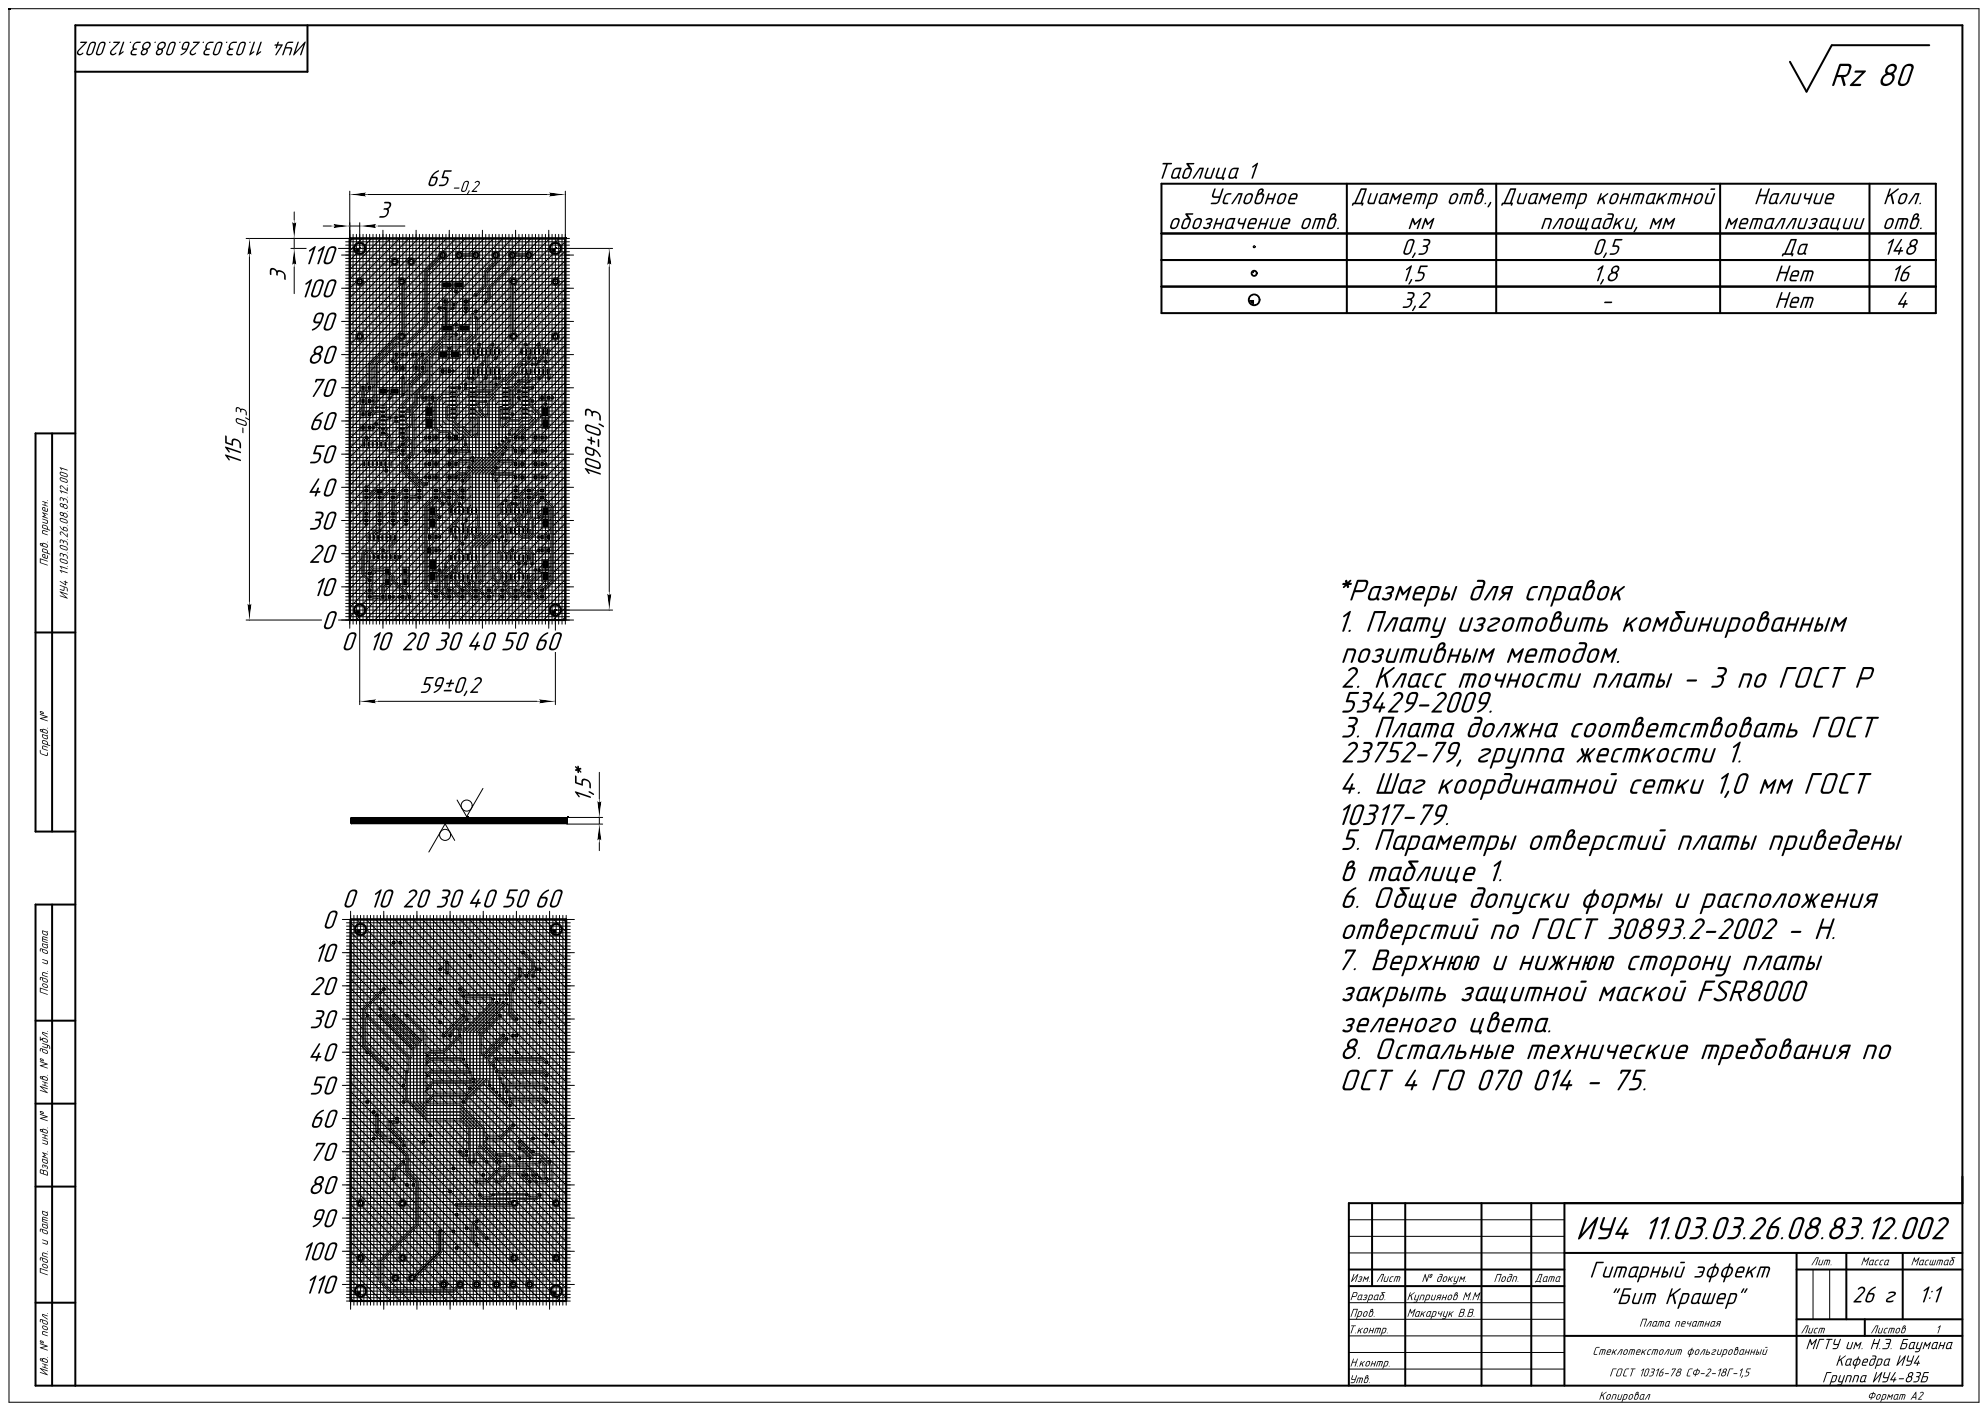
[picture p113: page 1]
