mkupriyanov05/Diploma_Baka/Sbor_Cap_Kupriyanov_Diploma.pdf

14,5 | 21,5 ¹7,5
51 | 25 | 3,2 4 отв. | 14 24,5 10,5 ¹,65•45 | 4 фаски

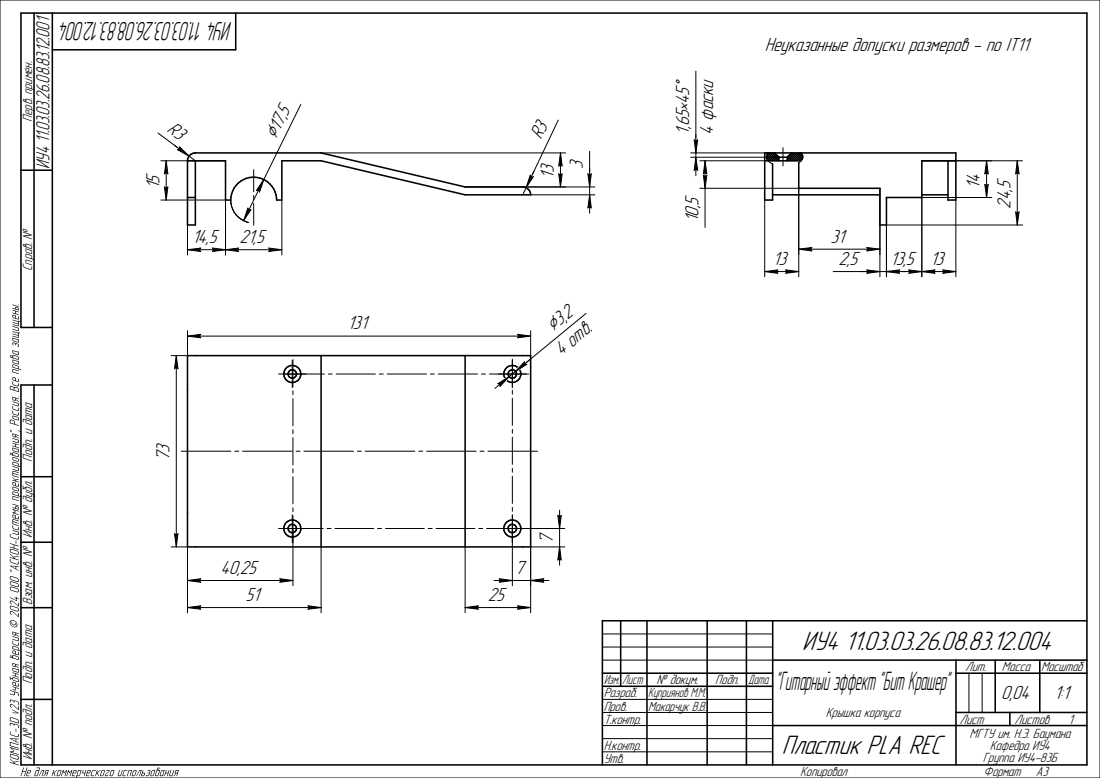
[picture p114: page 1]
Макарчук В.В. Инв. № подл. Подп. и дата Взам. инв. № Инв. № дубл. Подп. и дата Справ. № Перв. примен. ИУ4 ¹¹.03.03.26.08.83.12.00¹; Копировал; Формат A3

Неуказанные допуски размеров - по IT11

"Гитарный эффект "Бит Крашер" Крышка корпуса | Лит. | Масса | Масштаб

Изм. Лист | № докум. | Подп. | Дата | | | | | 0,04 | 1:1 1
Разраб. | Куприянов М.М.
Пров.
Т.контр. | | | | Лист | Листов
Н.контр.
Утв.

Пластик PLA REC | МГТУ им. Н.Э. Баумана Кафедра ИУ4 Группа ИУ4-83Б
