mkupriyanov05/Diploma_Baka/E1_Kupriyanov_Diploma.pdf

# Стабилизатор напряжения

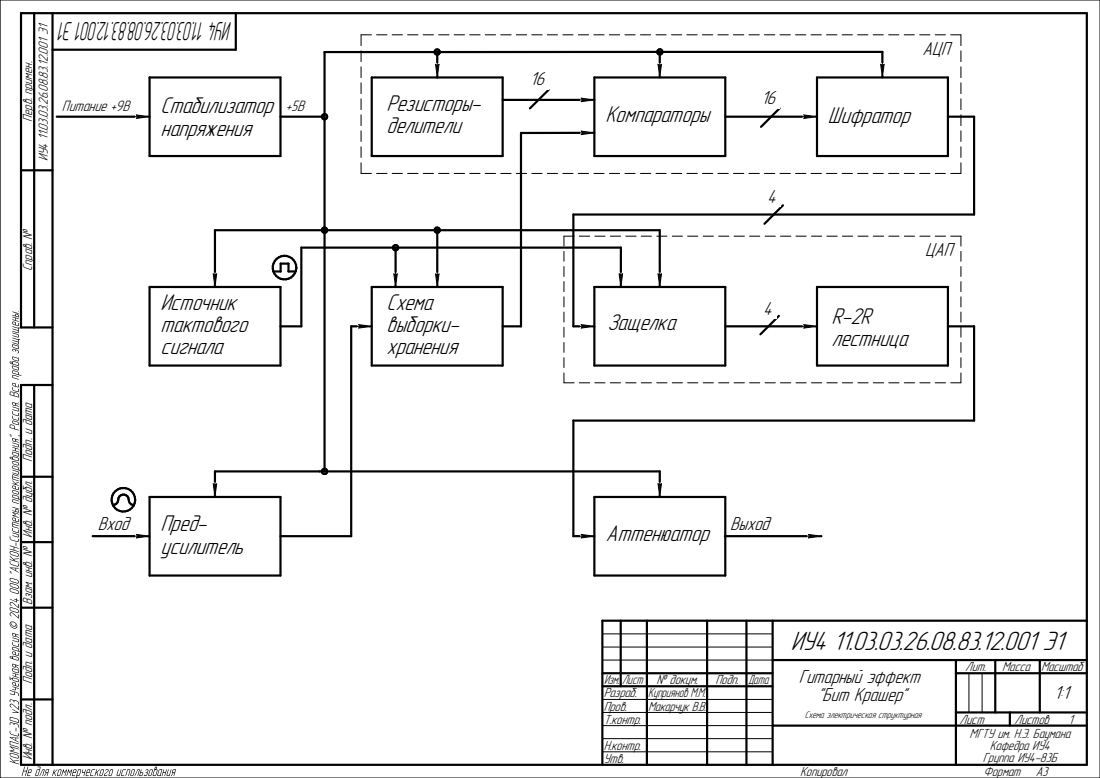
[picture p115: page 1]
Источник тактового сигнала; Пред- усилитель; Схема выборки- хранения; Резисторы-; делители; Компараторы; Шифратор; Защелка; лестница; Аттенюатор; Питание +9В; Вход; Выход; АЦП; ЦАП; МГТУ им. Н.Э. Баумана Кафедра ИУ4 Инв. № подл. Подп. и дата Взам. инв. № Инв. № дубл. Подп. и дата; Группа ИУ4-83Б Справ. № Перв. примен. ИУ4 ¹¹.03.03.26.08.83.12.00¹ Э¹; Копировал; Формат A3

Гитарный эффект "Бит Крашер" Схема электрическая структурная | Лит. | Масса | Масштаб

Изм. Лист | № докум. | Подп. | Дата | | | | | 1:1
Разраб. | Куприянов М.М.
Пров. | Макарчук В.В.
Т.контр. | | | | Лист | Листов 1

Н.контр.
Утв.
