mkupriyanov05/Diploma_Baka/E2_Kupriyanov_Diploma.pdf

# ИТС

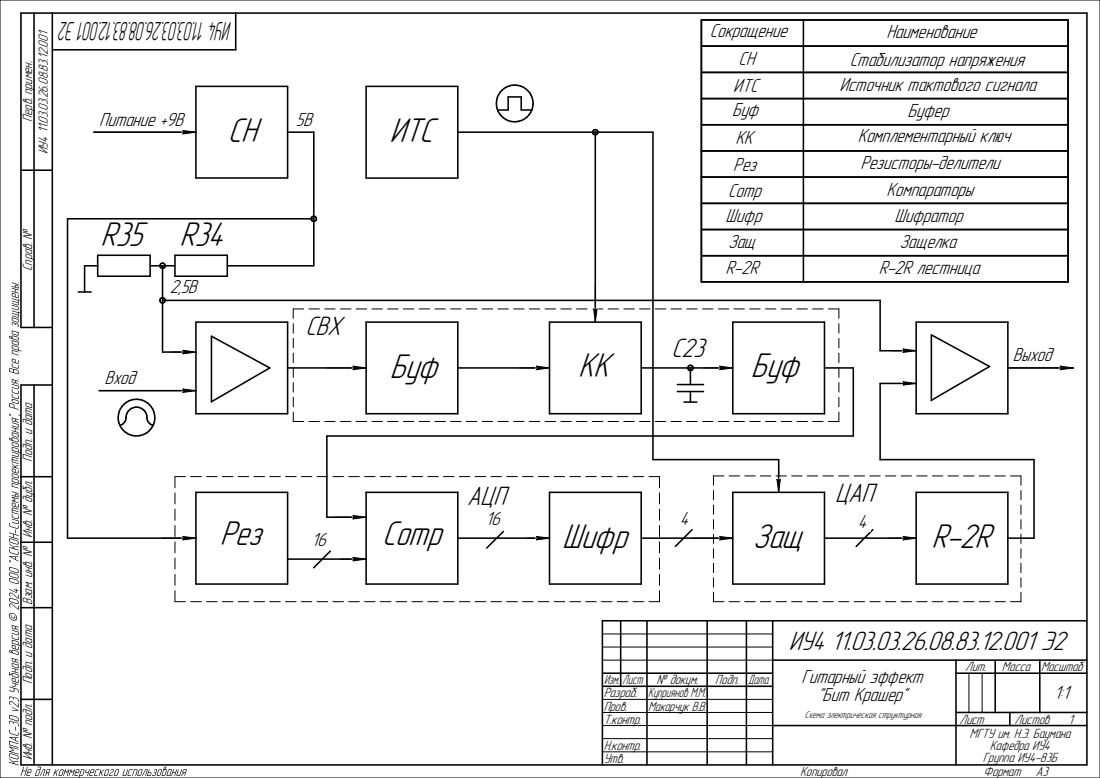
[picture p116: page 1]
СН Питание +9В; Буф; Рез; Comp; Шифр; Защ; Вход; Выход; СВХ; АЦП; ЦАП; МГТУ им. Н.Э. Баумана Кафедра ИУ4 Инв. № подл. Подп. и дата Взам. инв. № Инв. № дубл. Подп. и дата; Группа ИУ4-83Б Справ. № Перв. примен. ИУ4 ¹¹.03.03.26.08.83.12.00¹; Копировал; Формат A3

Сокращение | Наименование
СН | Стабилизатор напряжения
ИТС | Источник тактового сигнала
Буф | Буфер
КК | Комплементарный ключ
Рез | Резисторы-делители
Comp | Компараторы
Шифр | Шифратор
Защ | Защелка
R-2R | R-2R лестница

Гитарный эффект "Бит Крашер" Схема электрическая структурная | Лит. | Масса | Масштаб

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
