mkupriyanov05/Diploma_Baka/E3_Kupriyanov_Diploma.pdf

C23

### Вход

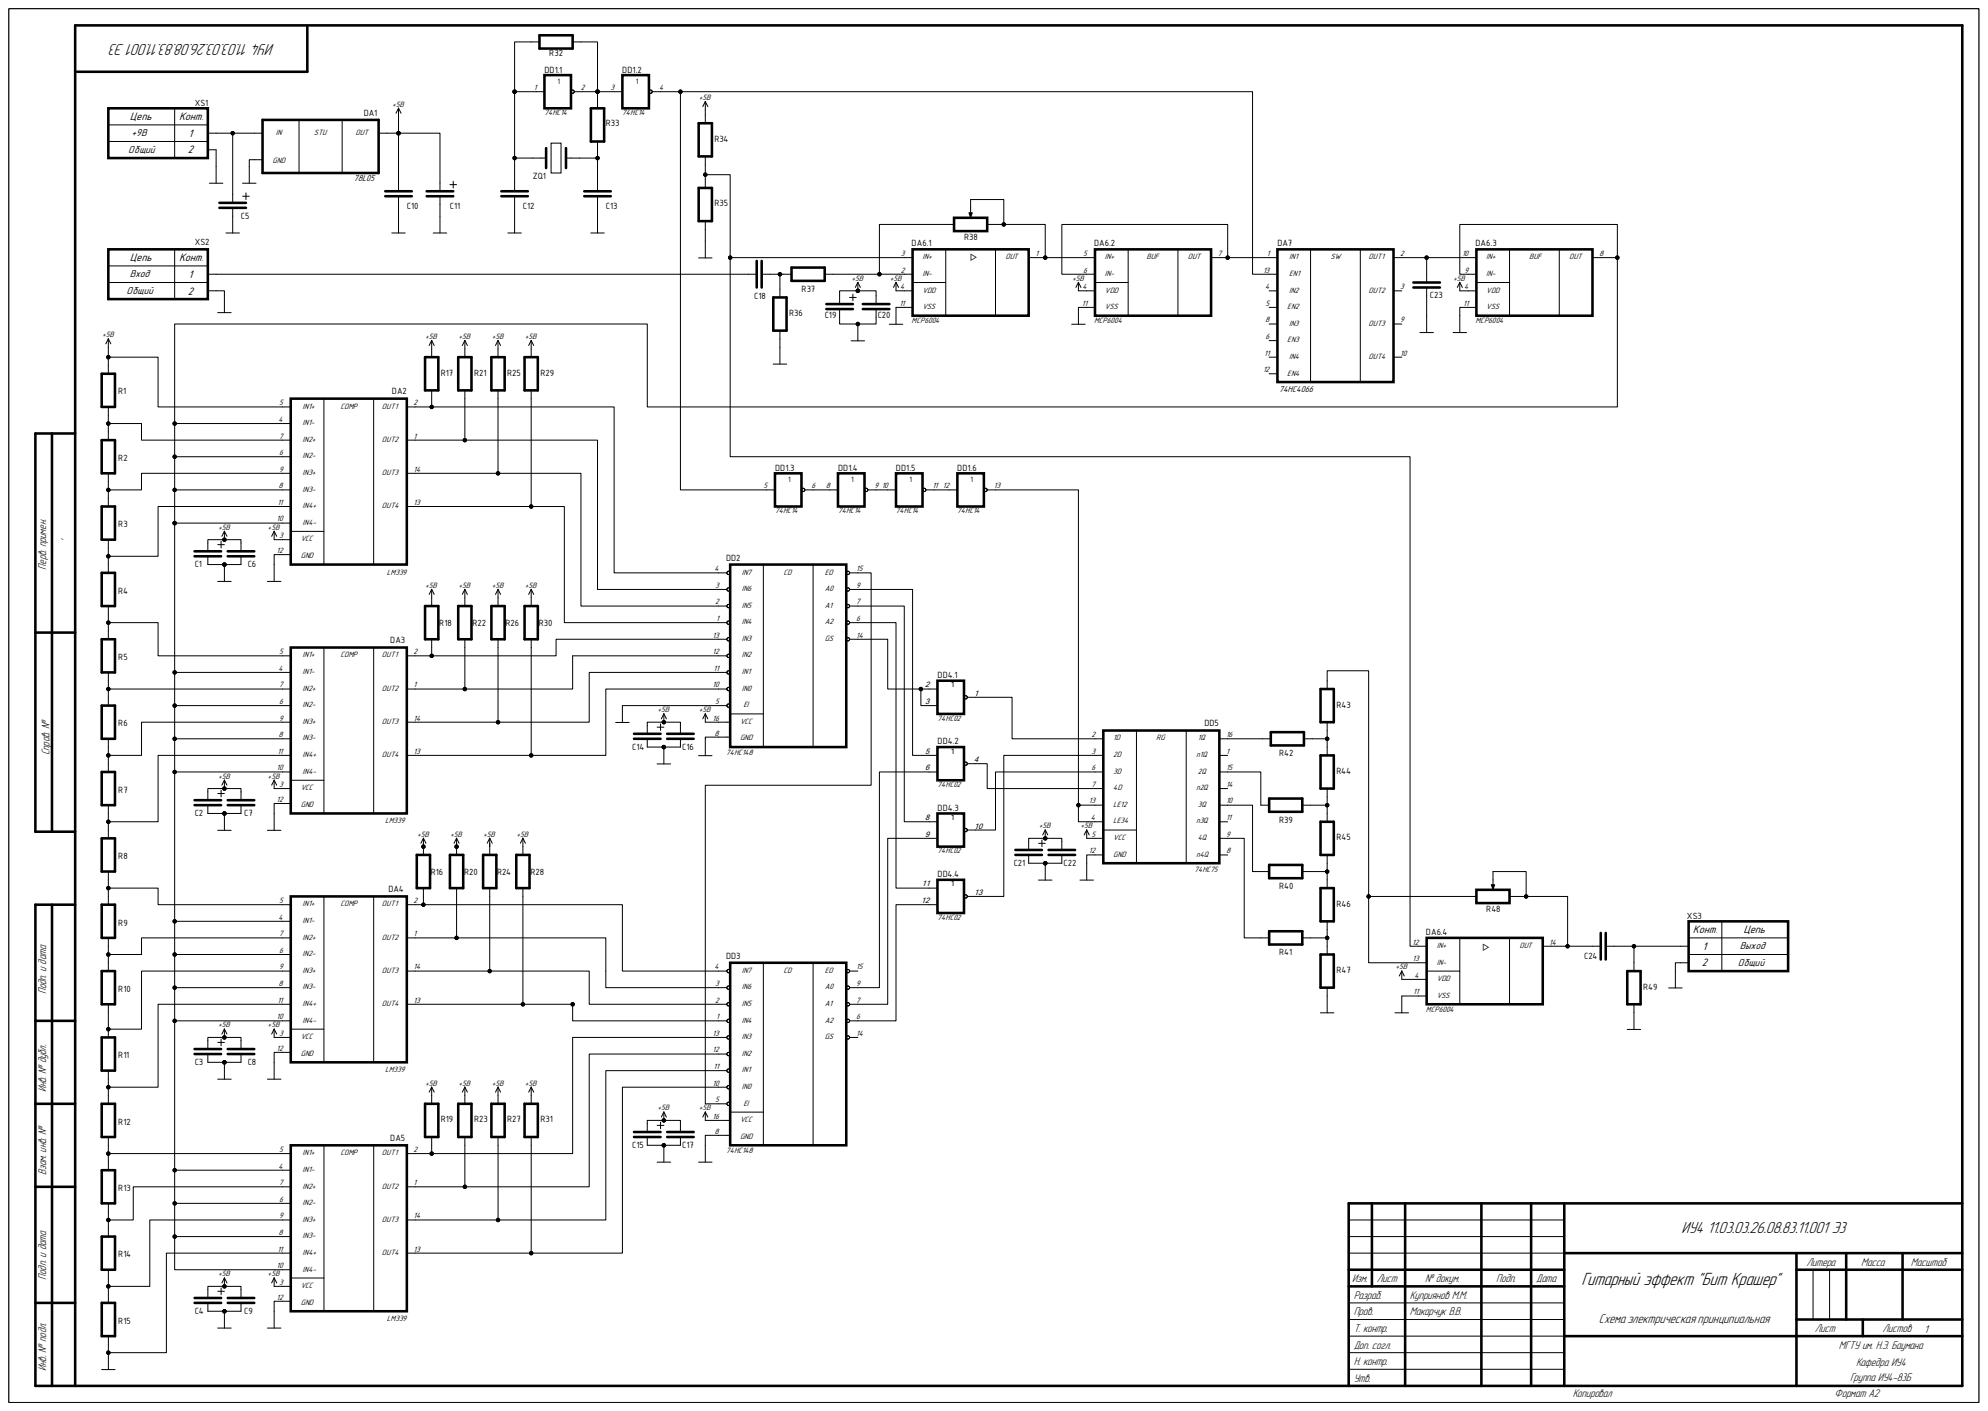
[picture p117: page 1]

Инв. № подл. Подп. и дата Инв. № дубл. Подп. и дата Взам. инв. №

Гитарный эффект "Бит Крашер" Схема электрическая принципиальная | Литера | Масса | Масштаб

Изм. | Лист | № докум. | Подп. | Дата
Разраб. | | Куприянов М.М.
Пров. | | Макарчук В.В.
Т. контр. | | | | | Лист | Листов 1
Доп. согл. | | | | | МГТУ им. Н.Э. Баумана Кафедра ИУ4 Группа ИУ4-83Б
Н. контр.
Утв.
