mkupriyanov05/Diploma_Baka/SB_Kupriyanov_Diploma.pdf

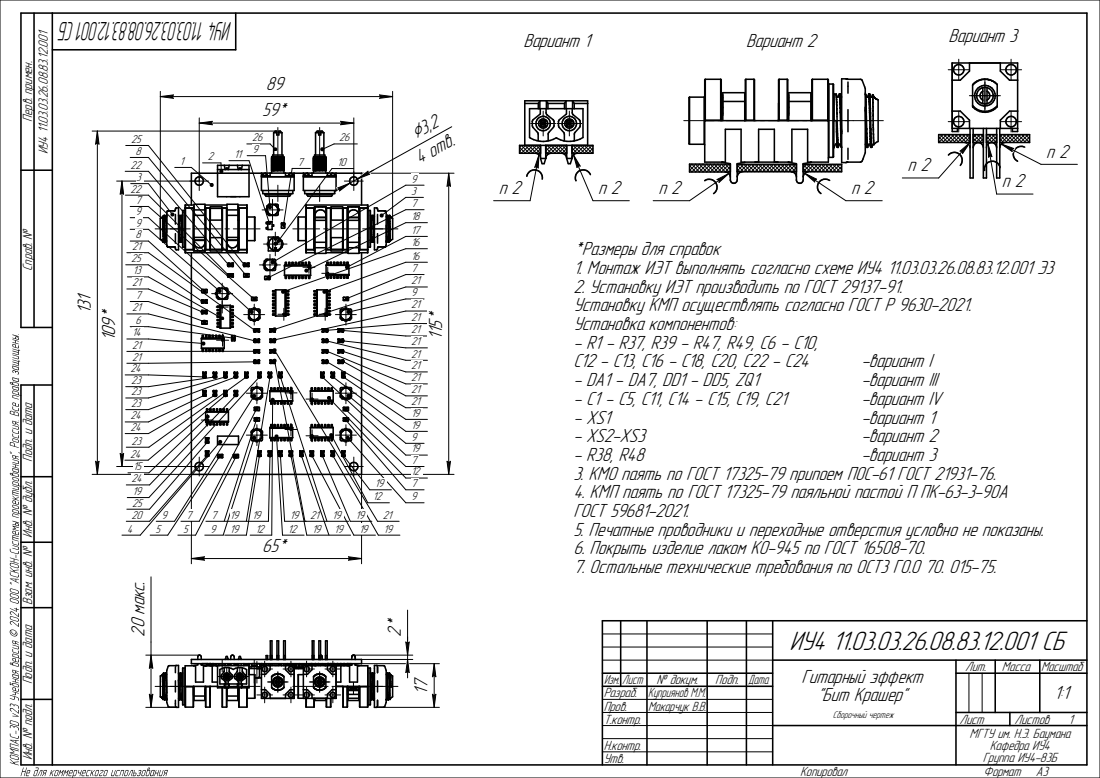
[picture p118: page 1]

*Размеры для справок
1. Монтаж ИЭТ выполнять согласно схеме ИУ4 11.03.03.26.08.83.12.001 Э3
2. Установку ИЭТ производить по ГОСТ 29137-91.
Установку КМП осуществлять согласно ГОСТ Р 9630-2021.
Установка компонентов:
3. КМО паять по ГОСТ 17325-79 припоем ПОС-61 ГОСТ 21931-76.
4. КМП паять по ГОСТ 17325-79 паяльной пастой П ПК-63-3-90А
ГОСТ 59681-2021.
5. Печатные проводники и переходные отверстия условно не показаны.
6. Покрыть изделие лаком КО-945 по ГОСТ 16508-70.
7. Остальные технические требования по ОСТ3 ГО.О 70. 015-75.
