mkupriyanov05/Diploma_Baka/Sbor_Base_Kupriyanov_Diploma.pdf

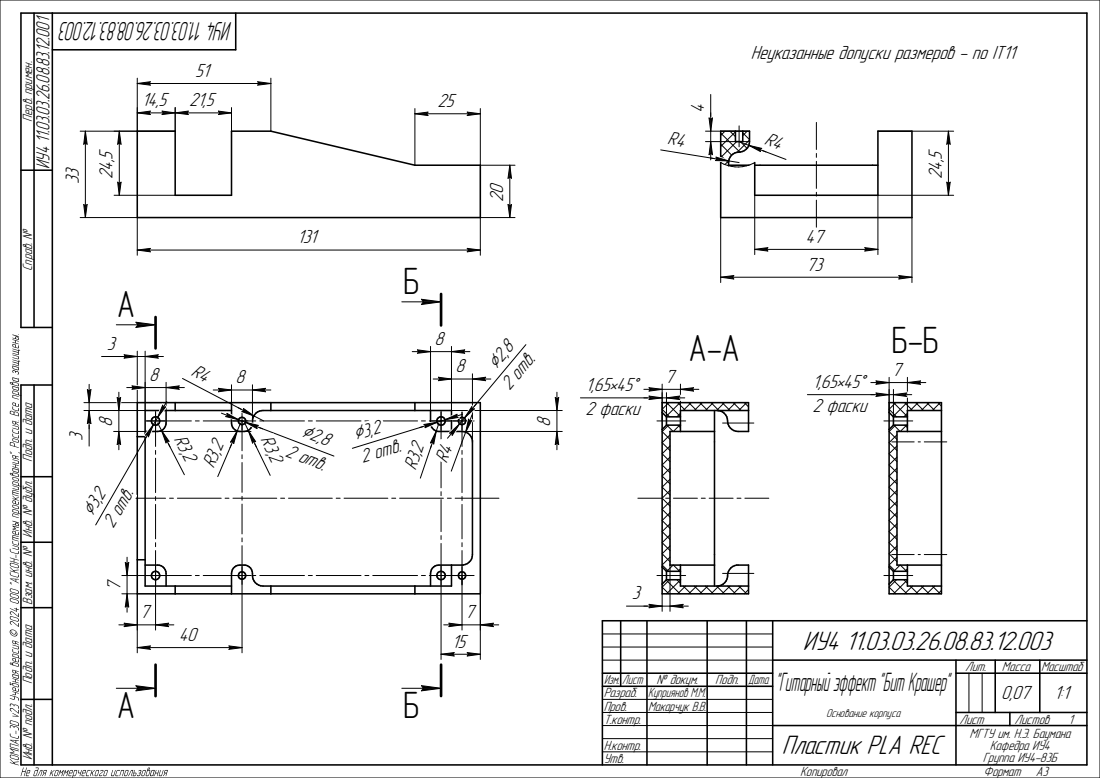
[picture p119: page 1]
2,8 2 отв. R4; 3,2 2 отв. 2,8 2 отв.; 3,2 2 отв.; 1,65•45 2 фаски; Разраб.; Куприянов М.М.; 0,07 Макарчук В.В.; ИУ4 11.03.03.26.08.83.12.003 Инв. № подл. Подп. и дата Взам. инв. № Инв. № дубл. Подп. и дата Справ. № Перв. примен. ИУ4 ¹¹.03.03.26.08.83.12.00¹; Копировал; Формат A3

Неуказанные допуски размеров - по IT11

"Гитарный эффект "Бит Крашер" Основание корпуса | Лит. | Масса | Масштаб

Изм. Лист | № докум. | Подп. | Дата | | | | | 1:1
Пров.
Т.контр. | | Лист | Листов 1
Н.контр.
Утв.

Пластик PLA REC | МГТУ им. Н.Э. Баумана Кафедра ИУ4 Группа ИУ4-83Б
