mkupriyanov05/Diploma_Baka/Sbor_Full_Kupriyanov_Diploma.pdf

143 23 36

## Неуказанные допуски размеров - по IT11

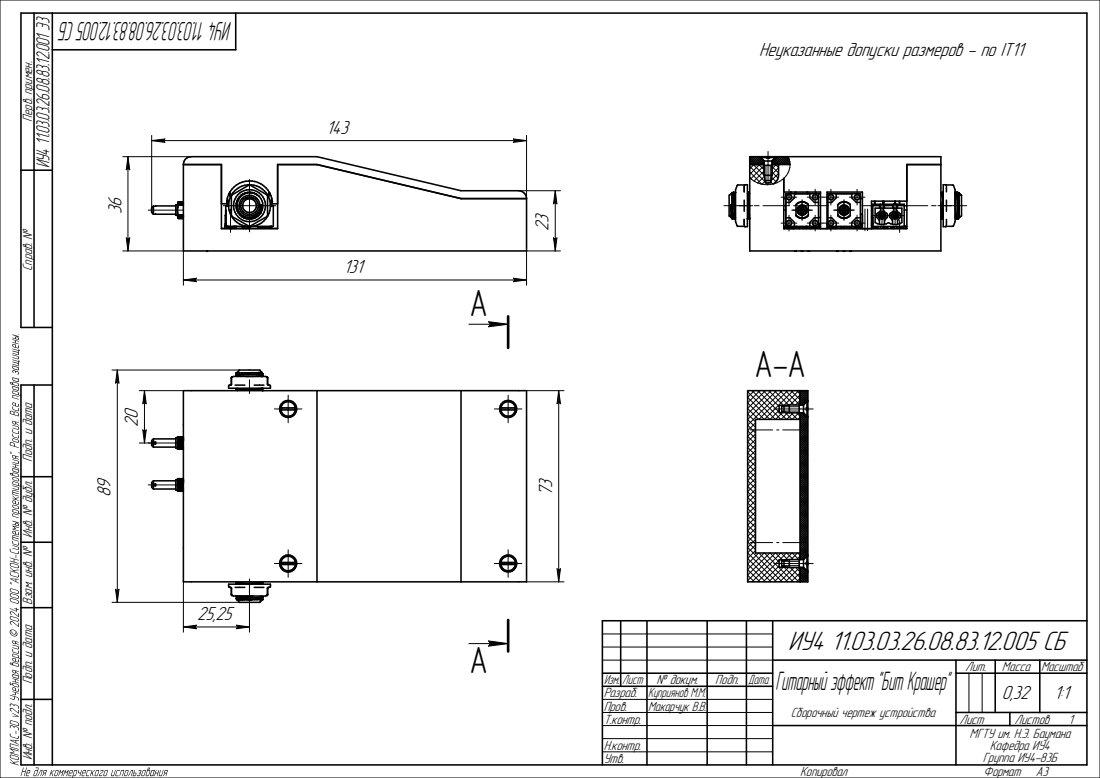
[picture p120: page 1]
Масса Масштаб; Лит.; Т.контр.; Лист; Листов; Куприянов М.М.; 0,32 Макарчук В.В.; МГТУ им. Н.Э. Баумана Кафедра ИУ4 Инв. № подл. Подп. и дата Взам. инв. № Инв. № дубл. Подп. и дата; Группа ИУ4-83Б Справ. № Перв. примен. ИУ4 ¹¹.03.03.26.08.83.12.00¹ Э3; Копировал; Формат A3

Гитарный эффект "Бит Крашер"

Изм. Лист № докум. Подп. Дата
Разраб.
Пров.
Н.контр.
Утв.

Сборочный чертеж устройства
