mkupriyanov05/Diploma_Baka/SH_Kupriyanov_Diploma.pdf

10 1

25 3

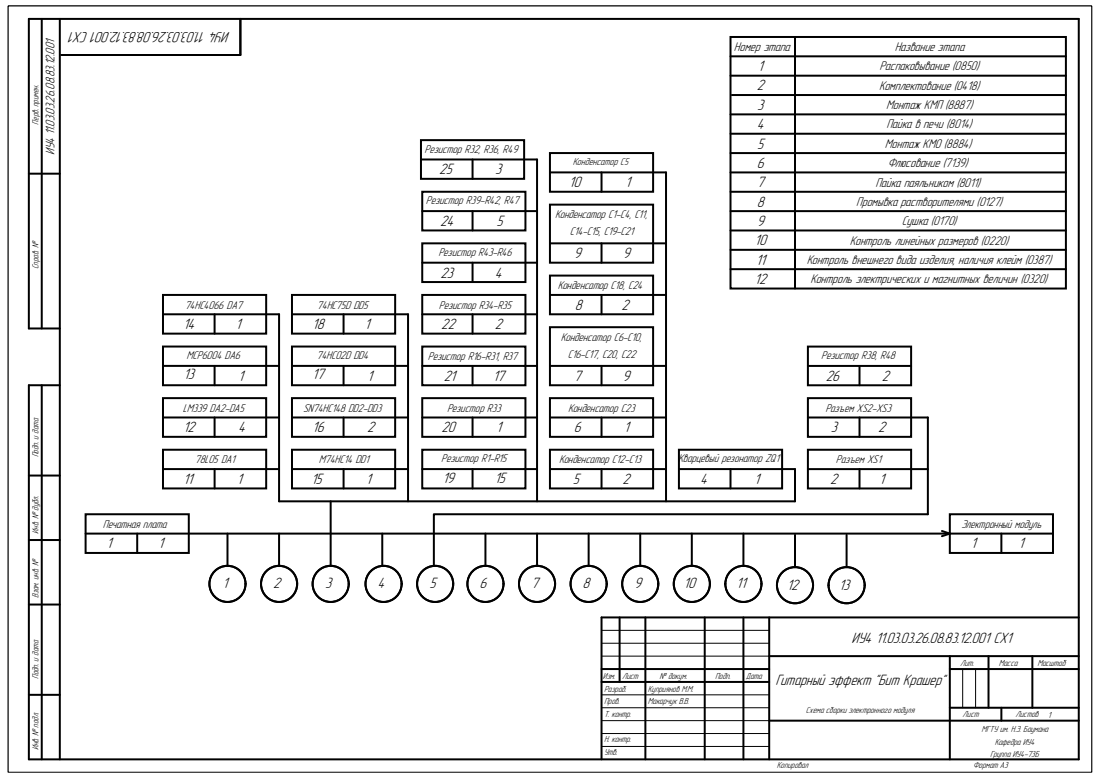
[picture p121: page 1]

Контроль электрических и магнитных величин (0320) ИУ4 ¹¹.03.03.26.08.83.12.00¹

Контроль внешнего вида изделия, наличия клейм (0387)

Лист Инв. № подл. Подп. и дата Инв. № дубл. Подп. и дата Взам. инв. №

Гитарный эффект "Бит Крашер" Схема сборки электронного модуля | Лит. | Масса | Масштаб

Изм. | Лист | № докум. | Подп. | Дата
Разраб. | | Куприянов М.М.
Пров. | | Макарчук В.В.
Т. контр. | | | | | | Листов 1

МГТУ им. Н.Э. Баумана Кафедра ИУ4 Группа ИУ4-73Б

Н. контр.
Утв.
