mkupriyanov05/Diploma_Baka/Shelkograph_Kupriyanov_Diploma.pdf

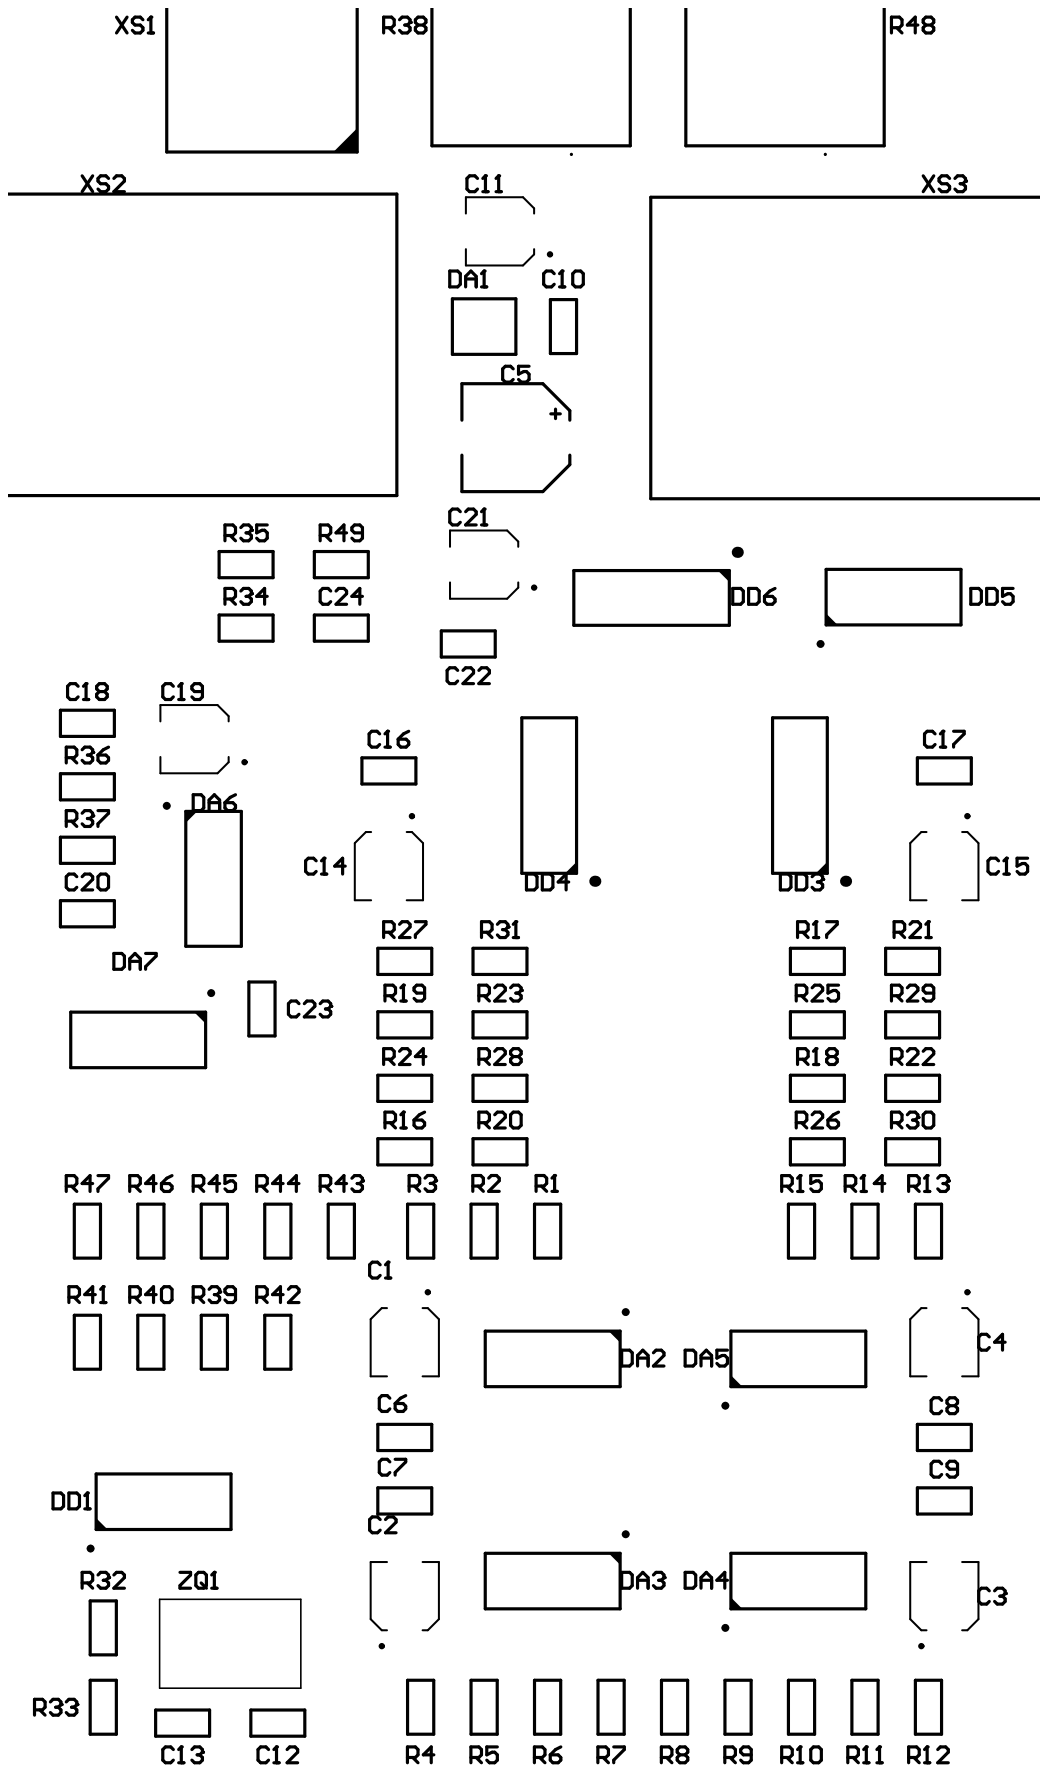
[picture p122: page 1]
