mkupriyanov05/Diploma_Baka/TX_Kupriyanov_Diploma.pdf

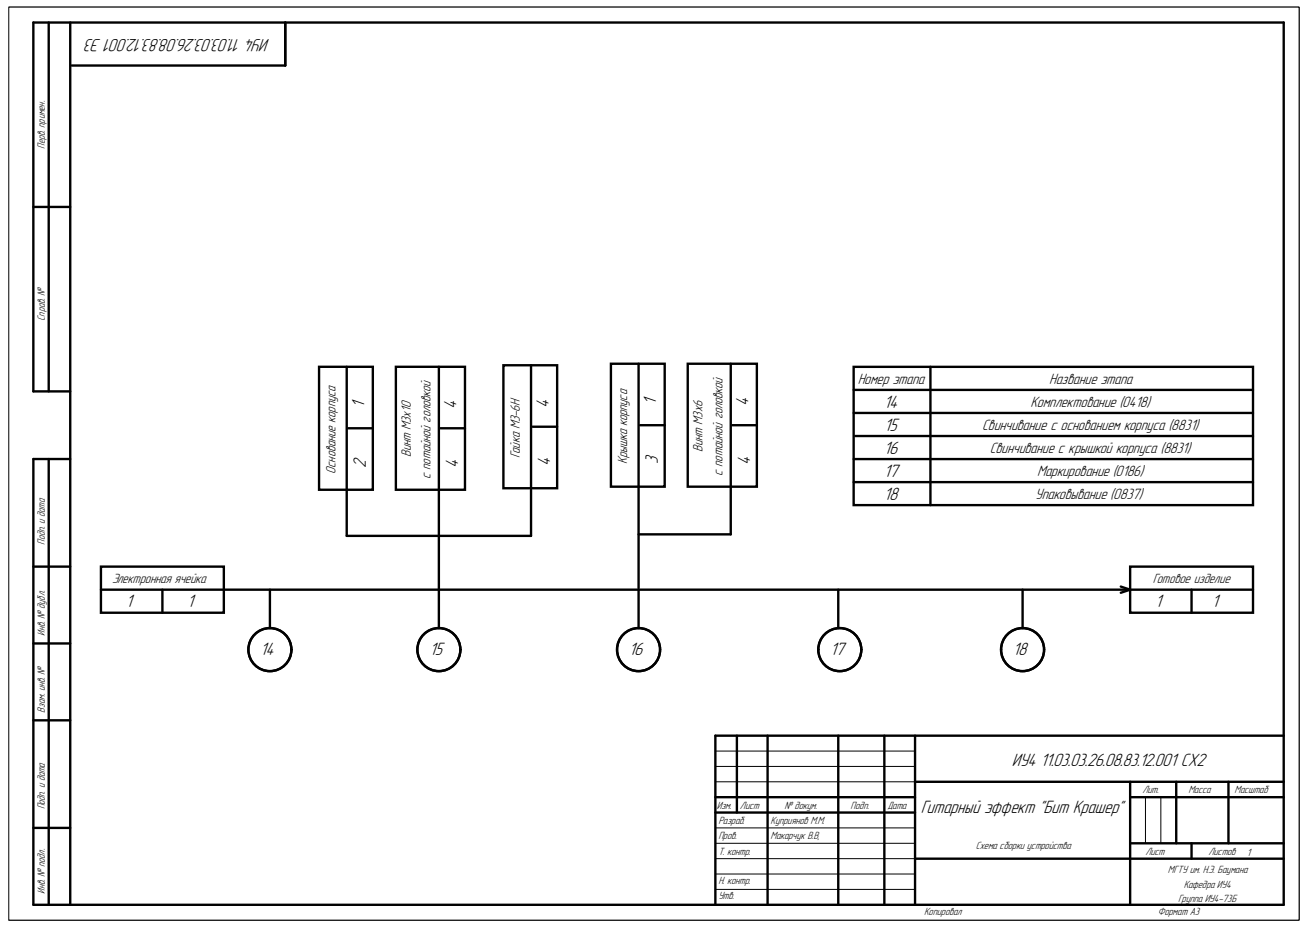
[picture p123: page 1]
Копировал; Формат А3 Перв. примен. Справ. №; Электронная ячейка; Готовое изделие; 1 Основание корпуса; 2 Крышка корпуса1; с потайной головкой; 4Винт М3х10 с потайной головкой 4; 4Винт М3х6 Гайка М3-6Н 4; Комплектование (0418); Номер этапа; Название этапа; Маркирование (0186); Упаковывание (0837)

Свинчивание с основанием корпуса (8831)
Свинчивание с крышкой корпуса (8831)

Лист Инв. № подл. Подп. и дата Инв. № дубл. Подп. и дата Взам. инв. №

Гитарный эффект "Бит Крашер" Схема сборки устройства | Лит. | Масса | Масштаб

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

МГТУ им. Н.Э. Баумана Кафедра ИУ4 Группа ИУ4-73Б

Н. контр.
Утв.
