mkupriyanov05/Diploma_Baka/(list of files, drawings)

Other design files:
ADC_Diploma.pdsprj
